ace-builder/Robbi/software/apps/fridge-rescue/README.md

# Fridge Rescue

Track food stock and dates, suggest offline recipes and maintain an app-owned shopping list.

See [Life tools documentation](../../docs/apps/LIFE_TOOLS_APPS.md) for behavior, limits, permissions and examples.

The implementation is included in this project and uses the declared Robbi SDK. It makes no network requests.
