ace-builder/Robbi/software/apps/home-care/README.md

# Home Care Companion

Recurring household chores with due dates based on actual completion and optional one-shot timers.

See [Life tools documentation](../../docs/apps/LIFE_TOOLS_APPS.md) for behavior, limits, permissions and examples.

The implementation is included in this project and uses the declared Robbi SDK. It makes no network requests.
