ace-builder/Robbi/build/hardware/prints/DESIGN-2026-10-13.md

# Printed design: 13 October 2026

[Print files](README.md) · [Assembly steps](../../05-assembly.md) · [Parts](../../01-parts.md)

> [!WARNING]
> **This printed design iteration has not yet been physically validated.** The CAD release records nominal fit, service-path and reference slicing checks. Those checks do not prove real printed fit, strength, reliable button actuation, charging access or sensor performance. Complete a dry assembly with actual components before committing adhesive or applying power.

The published assembly STL contains the revised chassis and fixed head; the earlier written guide and build footage described the prototype's assembly. The current guide now follows the October design. Individual October STLs and reference 3MF projects are available alongside the original assembly reference. Use the complete matching set.

## Differences from the filmed prototype

| Area | October design and required change |
| :--- | :--- |
| Head | Fixed carrier with an enclosed hollow neck and separate rear service cover. No adjustable or motorised head joint. Use two M3 × 12 screws **upward from inside the chassis**, with nuts in the head ears. The older central retaining bracket is not the new cover. |
| Head cover | Offer it **1.5 mm low**, move forward to the rim, then slide **up 1.5 mm** to engage two hooks. Secure with one M2 × 6 screw. The hooks slide; do not bend them as snap clips. |
| Electronics mounting | Four M2 × 20 screws from outside the rear cover pass through the Pi, **four 11 mm spacers**, custom PCB, compact washers and nuts. Confirm the actual header mating height; do not pull the boards together with screws. |
| Stack insertion | Keep the head and both side panels off. Enter from the **GPIO side**, hold the stack **4 mm outward**, connect BAT, then seat it **4 mm inward**. Do not stretch the body by centimetres as in the older footage. |
| Battery | Seat for a **76 × 21 × 18.4 mm** holder; measured loaded height **20.4 mm**. Glue the empty holder using accessible fillets after fit checks. Its central Ø3.6 hole is unused; no safe screw-head clearance has been established. |
| Motor retention | New front-fastened clip and side-loaded M2 nut replace the old rear fastener, which conflicts with the holder. Fit the motors and clip **before** the holder, head, camera or electronics. |
| Power button | Separate PETG rocker, keeper/return spring and split pivot pin operate SW1 from outside. Test no preload, a click before the stop and complete release with the actual stack installed. |
| Charging access | Rear opening is **14 × 8 mm**; the modelled connector mouth is **12.63 mm behind it**. The cable overmold must enter far enough for full seating. This enclosure change does not alter the PCB's brownout on charger connection. |
| Camera | The four seating planes move **1 mm forward**; the screw bores become **14 mm deep**. Check actual screws clamp before bottoming. Fit the camera after the head screws to preserve tool access. |
| ToF | Locating outline and two glue lands. Dry-fit the sensor, cover and solder tails; test readings through the window before two small glue fillets at the outer ears. No ToF screws or clamp. |
| Wiring | Battery position changes the local LCD and left-encoder routes. Use individual display housings through the neck and prewire constrained PCB plugs before inserting the stack. Keep H2 and SERVO1 empty in the standard build. |
| Servicing | Remove both side panels and the fixed head before taking out the electronics stack or replacing the cell. Unplug display leads at the display, feed individual housings down the neck, move the stack 4 mm out, disconnect BAT, then withdraw through the GPIO side. |

## Fit limits to check on real parts

- **Pi / PCB stack:** the 11 mm gap is between the Pi's top surface and the custom PCB's underside. The Pi's 1.6 mm model thickness is an assumption. Verify actual PCB thickness, soldered header height, mating depth and clearance before tightening.
- **Button:** nominal SW1 rest gap is 0.20 mm; assembly target 0.15–0.25 mm. Check no preload in every orientation and through available bearing play. A coupon cannot validate the board datum or switch position.
- **Head:** front outside face to inside rear wall is 29.0 mm, overall depth 30.6 mm. The model assumes a 1.2 mm display PCB. Four approximately 24.65 mm cover posts must not load the glass, cable or components. The cover must meet its rim without screw force.
- **Display leads:** the neck opening is Ø12 mm. Feed eight individual connector housings one at a time. Local head references allow housings up to 14.25 mm long, wire up to Ø1.5 mm and R3 centreline bends; actual bought leads still need checking.
- **Battery and harness:** the local LCD route has only about 0.295 mm nominal clearance to the loaded-holder envelope, falling to about 0.161 mm in the tested PCB-offset cases. Its modelled R2 bend and the left-encoder R2.5 bend are clearance references, not permission to kink stiff wire. Full harness lengths are not specified by CAD.
- **Thin plastic:** the minimum battery-seat floor is about 1.004 mm, rear motor wall about 1.018 mm, and panel pocket skins 0.8 mm. Check real print integrity and motor retention. Reference slicing is not a strength test.
- **ToF:** a 1 mm solder-tail reference clears in CAD, but actual tails/cover and optical field of view were not measured. Verify fit and ranging in the real shell.
- **Cell service:** the checked external envelope is up to 70 mm long × Ø18.6 mm. Actual spring-contact travel is not modelled. With the stack removed, the cell lifts about 20 mm before withdrawing through the battery side.

## What is established

The October release records 15 closed STL meshes, 11 unsliced reference 3MF projects and nominal assembly/service checks. The individual meshes and projects are published unchanged. [Validation status](2026-10-13/validation.json) and the [hardware manifest](../release-files.json) identify the files.

Physical print fit, material behaviour, repeated button use, motor retention, loaded wire clearance, optical performance and a complete new-enclosure build remain unverified. This mechanical revision does not change the PCB pinout or establish new electrical, charging or motor-load limits. Use the [wiring reference](../../WIRING.md), [bench tests](../../04-bench-tests.md) and [release checklist](../../RELEASE-CHECKLIST.md).
