ace-builder/Robbi/build/hardware/pcb/connector-pinout.csv

connector | pin | signal | connect_to | continuity_to | x_mm | y_mm
LCD | 1 | 3V3 | VCC | U6.1 | 18.11 | -2.2
LCD | 2 | GND | GND | U6.6 | 20.65 | -2.2
LCD | 3 | SPI clock | SCL | U6.23 | 23.19 | -2.2
LCD | 4 | SPI MOSI | SDA | U6.19 | 25.73 | -2.2
LCD | 5 | Reset | RES | U6.18 | 28.27 | -2.2
LCD | 6 | Data/command | DC | U6.22 | 30.81 | -2.2
LCD | 7 | Chip select | CS | U6.24 | 33.35 | -2.2
LCD | 8 | 3V3 backlight | BLK | U6.17 | 35.89 | -2.2
H1 | 1 | 3V3 | VCC | U6.1 | 53.65 | -2.2
H1 | 2 | GND | GND | U6.6 | 56.19 | -2.2
H1 | 3 | I2C SDA | SDA | U6.3 | 58.73 | -2.2
H1 | 4 | I2C SCL | SCL | U6.5 | 61.27 | -2.2
H1 | 5 | Unrouted | Leave unconnected | No route | 63.81 | -2.2
H1 | 6 | XSHUT / BCM13 | XSHUT | U6.33 | 66.35 | -2.2
H2 | 1 | 3V3 | Unused in this build | U6.1 | 2.2 | -3.15
H2 | 2 | GND | Unused in this build | U6.6 | 2.2 | -5.69
H2 | 3 | I2C SDA | Unused in this build | U6.3 | 2.2 | -8.23
H2 | 4 | I2C SCL | Unused in this build | U6.5 | 2.2 | -10.77
H2 | 5 | Unrouted | Leave unconnected | No route | 2.2 | -13.31
H2 | 6 | XSHUT / BCM12 | Unused in this build | U6.32 | 2.2 | -15.85
MENCODER_L | 1 | Motor terminal 1 | Motor lead 1 | MD1.2 | 17.15 | -42.0
MENCODER_L | 2 | 3V3 encoder supply | Encoder VCC | U6.1 | 19.69 | -42.0
MENCODER_L | 3 | Encoder A / BCM27 | Encoder A | U6.13 | 22.23 | -42.0
MENCODER_L | 4 | Encoder B / BCM5 | Encoder B | U6.29 | 24.77 | -42.0
MENCODER_L | 5 | GND | Encoder GND | U6.6 | 27.31 | -42.0
MENCODER_L | 6 | Motor terminal 2 | Motor lead 2 | MD1.4 | 29.85 | -42.0
MENCODER_R | 1 | Motor terminal 1 | Motor lead 1 | MD1.7 | 50.15 | -42.0
MENCODER_R | 2 | 3V3 encoder supply | Encoder VCC | U6.1 | 52.69 | -42.0
MENCODER_R | 3 | Encoder A / BCM6 | Encoder A | U6.31 | 55.23 | -42.0
MENCODER_R | 4 | Encoder B / BCM16 | Encoder B | U6.36 | 57.77 | -42.0
MENCODER_R | 5 | GND | Encoder GND | U6.6 | 60.31 | -42.0
MENCODER_R | 6 | Motor terminal 2 | Motor lead 2 | MD1.5 | 62.85 | -42.0
H3 | 1 | Speaker + | Speaker + | AMP.9 | 52.73 | -26.5
H3 | 2 | Speaker - | Speaker - | AMP.10 | 55.27 | -26.5
BAT | 1 | Battery + / PACK+ | Holder positive | TP_PACK+.1 | 11.98018 | -41.0
BAT | 2 | Battery - / PACK- | Holder negative | TP_PACK-.1 | 8.01982 | -41.0
