ace-builder/Robbi/software/apps/bookmarks/images/screen.png

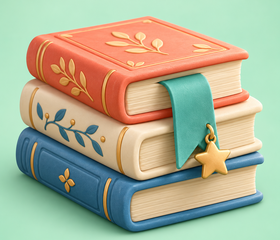
software/apps/bookmarks/images/screen.png
