ace-builder/Robbi/software/apps/calculator/images/screen.png

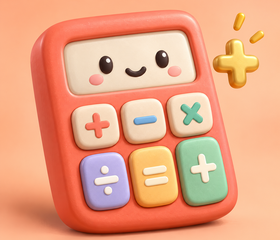
software/apps/calculator/images/screen.png
