ace-builder/Robbi/software/apps/checklists/images/screen.png

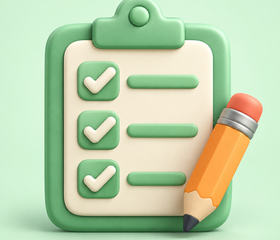
software/apps/checklists/images/screen.png
