ace-builder/Robbi/software/apps/date-calculator/images/screen.png

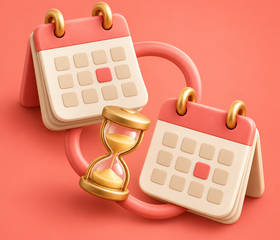
software/apps/date-calculator/images/screen.png
