ace-builder/Robbi/software/apps/decision-helper/images/screen.png

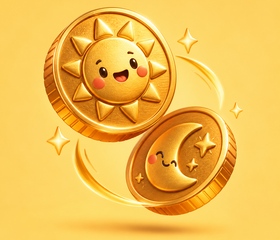
software/apps/decision-helper/images/screen.png
