ace-builder/Robbi/software/apps/decision-notebook/images/screen.png

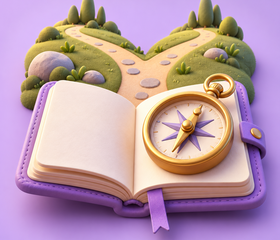
software/apps/decision-notebook/images/screen.png
