ace-builder/Robbi/software/apps/expense-tracker/images/screen.png

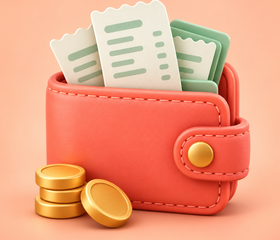
software/apps/expense-tracker/images/screen.png
