ace-builder/Robbi/software/apps/expressions/images/screen.png

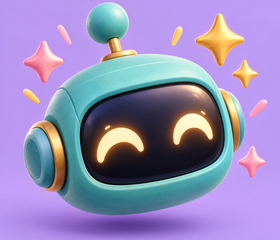
software/apps/expressions/images/screen.png
