ace-builder/Robbi/software/apps/fridge-rescue/images/screen.png

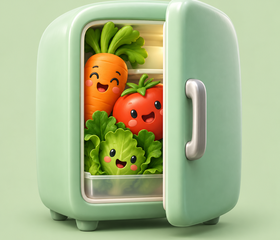
software/apps/fridge-rescue/images/screen.png
