ace-builder/Robbi/software/apps/gmail/images/screen.png

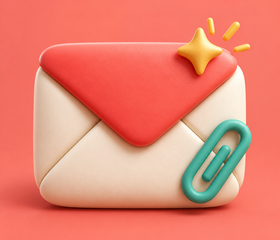
software/apps/gmail/images/screen.png
