ace-builder/Robbi/software/apps/google-calendar/images/screen.png

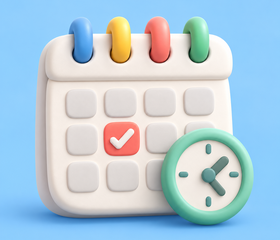
software/apps/google-calendar/images/screen.png
