ace-builder/Robbi/software/apps/google-maps/images/screen.png

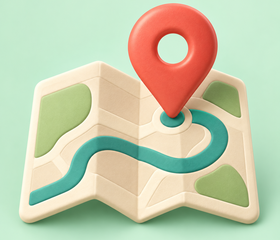
software/apps/google-maps/images/screen.png
