ace-builder/Robbi/software/apps/habit-tracker/images/screen.png

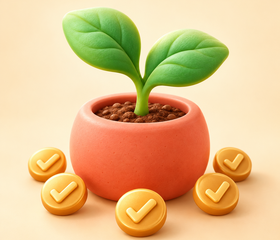
software/apps/habit-tracker/images/screen.png
