ace-builder/Robbi/software/apps/higher-lower/images/screen.png

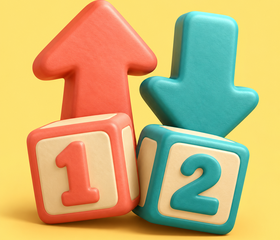
software/apps/higher-lower/images/screen.png
