ace-builder/Robbi/software/apps/home-care/images/screen.png

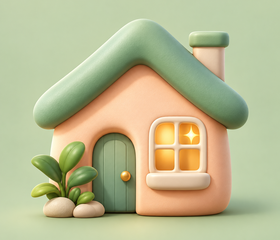
software/apps/home-care/images/screen.png
