ace-builder/Robbi/software/apps/image-studio/images/screen.png

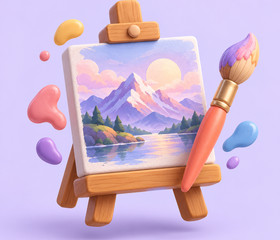
software/apps/image-studio/images/screen.png
