ace-builder/Robbi/software/apps/kitchen-timers/images/screen.png

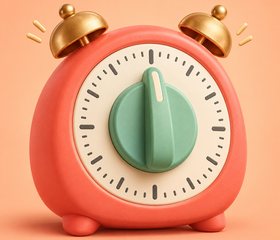
software/apps/kitchen-timers/images/screen.png
