ace-builder/Robbi/software/apps/meeting-prep/images/screen.png

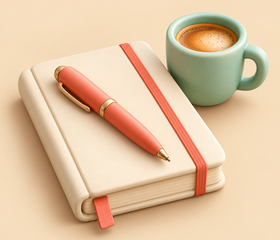
software/apps/meeting-prep/images/screen.png
