ace-builder/Robbi/software/apps/memory-colours/images/screen.png

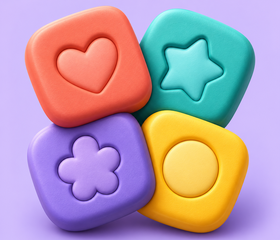
software/apps/memory-colours/images/screen.png
