ace-builder/Robbi/software/apps/packing-list/images/screen.png

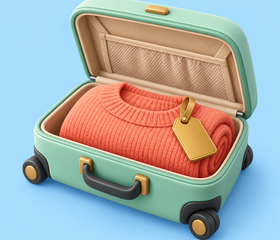
software/apps/packing-list/images/screen.png
