ace-builder/Robbi/software/apps/password-generator/images/screen.png

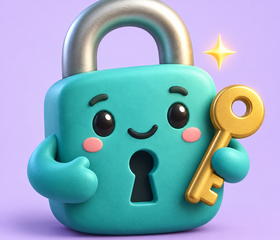
software/apps/password-generator/images/screen.png
