ace-builder/Robbi/software/apps/percentage-helper/images/screen.png

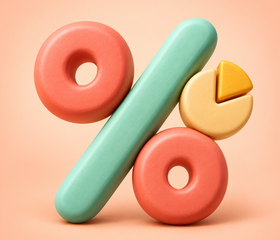
software/apps/percentage-helper/images/screen.png
