ace-builder/Robbi/software/apps/quick-notes/images/screen.png

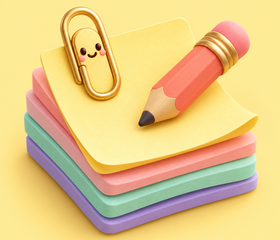
software/apps/quick-notes/images/screen.png
