ace-builder/Robbi/software/apps/random-number/images/screen.png

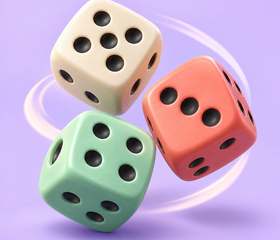
software/apps/random-number/images/screen.png
