ace-builder/Robbi/software/apps/ready-to-leave/images/screen.png

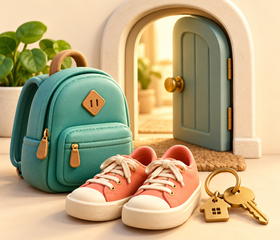
software/apps/ready-to-leave/images/screen.png
