ace-builder/Robbi/software/apps/recipe-scaler/images/screen.png

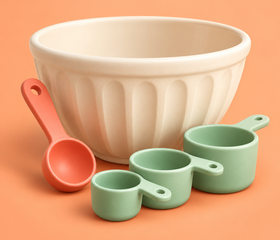
software/apps/recipe-scaler/images/screen.png
