ace-builder/Robbi/software/apps/rhythm-relay/images/screen.png

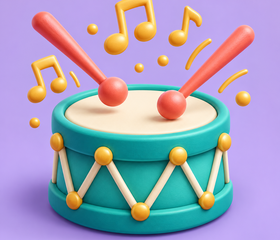
software/apps/rhythm-relay/images/screen.png
