ace-builder/Robbi/software/apps/robot-charades/images/screen.png

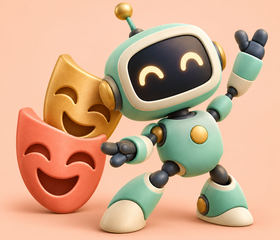
software/apps/robot-charades/images/screen.png
