ace-builder/Robbi/software/apps/robot-status/images/screen.png

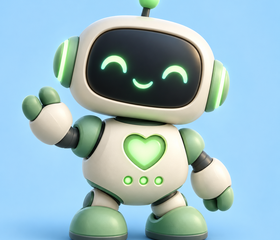
software/apps/robot-status/images/screen.png
