ace-builder/Robbi/software/apps/sensor-check/images/screen.png

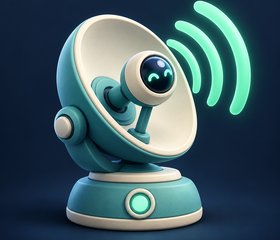
software/apps/sensor-check/images/screen.png
