ace-builder/Robbi/software/apps/teach-me/images/screen.png

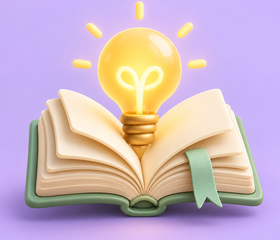
software/apps/teach-me/images/screen.png
