ace-builder/Robbi/software/apps/text-toolbox/images/screen.png

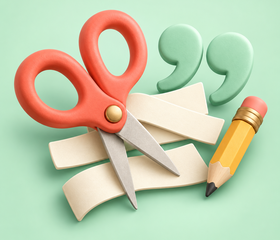
software/apps/text-toolbox/images/screen.png
