ace-builder/Robbi/software/apps/tic-tac-toe/images/screen.png

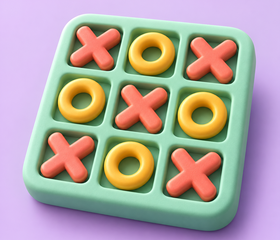
software/apps/tic-tac-toe/images/screen.png
