ace-builder/Robbi/software/apps/tiny-detective/images/screen.png

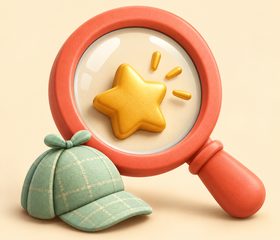
software/apps/tiny-detective/images/screen.png
