ace-builder/Robbi/software/apps/tip-splitter/images/screen.png

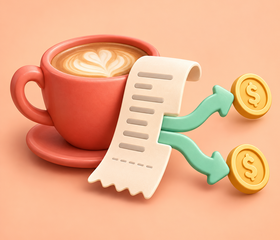
software/apps/tip-splitter/images/screen.png
