ace-builder/Robbi/software/apps/unit-converter/images/screen.png

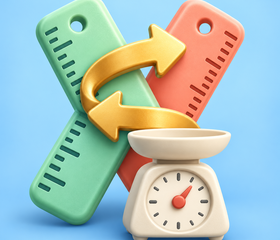
software/apps/unit-converter/images/screen.png
