ace-builder/Robbi/software/apps/weather/images/screen.png

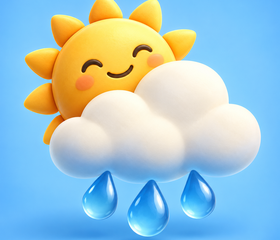
software/apps/weather/images/screen.png
