ace-builder/Robbi/software/apps/web-search/images/screen.png

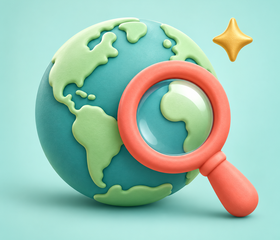
software/apps/web-search/images/screen.png
