ace-builder/Robbi/software/apps/where-did-i-put-it/images/screen.png

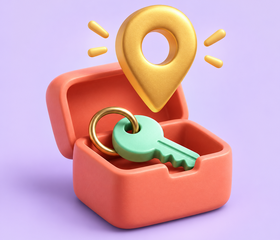
software/apps/where-did-i-put-it/images/screen.png
