ace-builder/Robbi/software/apps/world-clock/images/screen.png

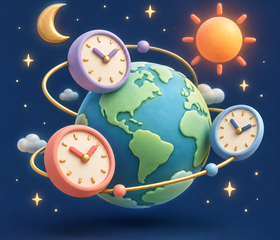
software/apps/world-clock/images/screen.png
