ace-builder/Robbi/software/assets/dynamics_sources/after-hours-v1/boundary-cactus.png

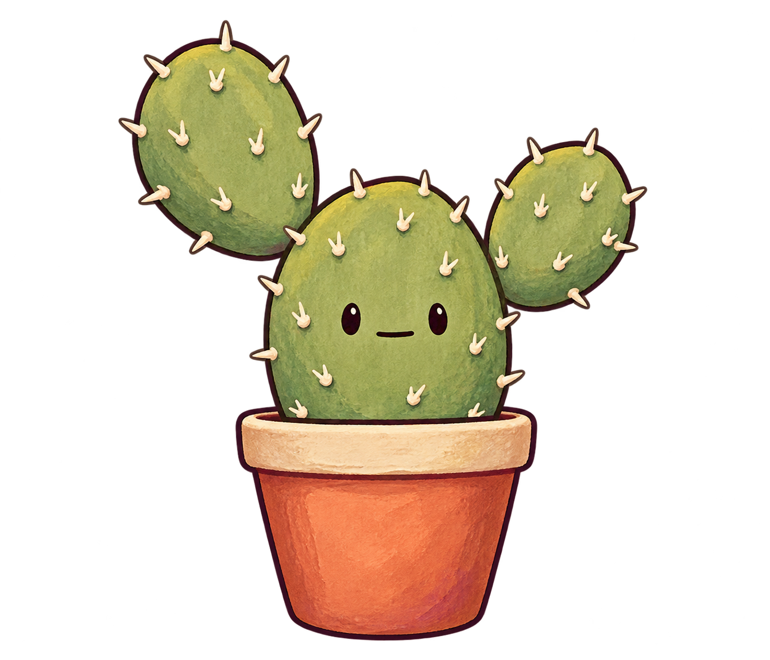
software/assets/dynamics_sources/after-hours-v1/boundary-cactus.png
