ace-builder/Robbi/software/assets/dynamics_sources/after-hours-v1/capybara-rest.png

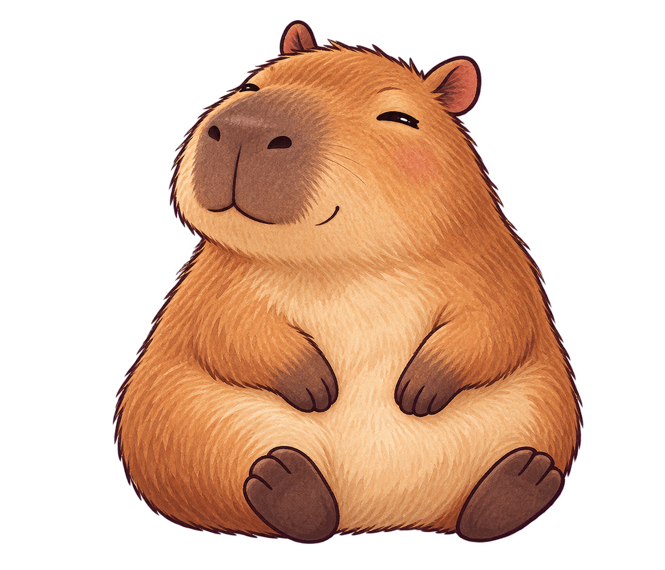
software/assets/dynamics_sources/after-hours-v1/capybara-rest.png
