ace-builder/Robbi/software/assets/dynamics_sources/after-hours-v1/judge-shrimp.png

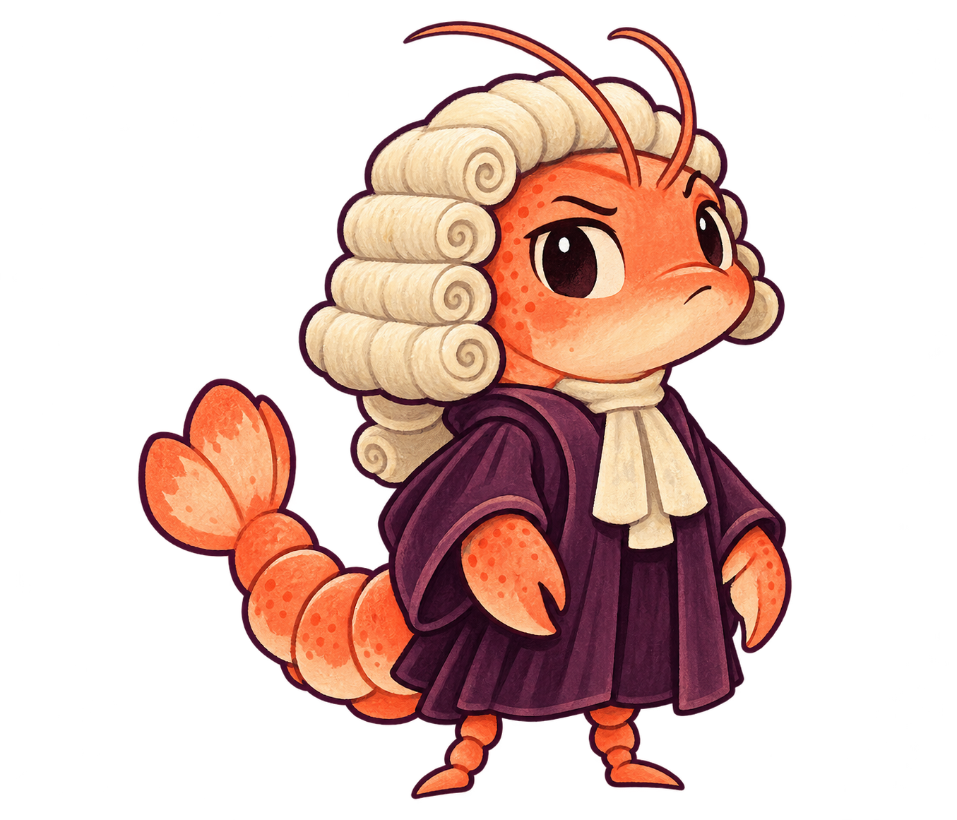
software/assets/dynamics_sources/after-hours-v1/judge-shrimp.png
