ace-builder/Robbi/software/assets/dynamics_sources/celebration-original.png

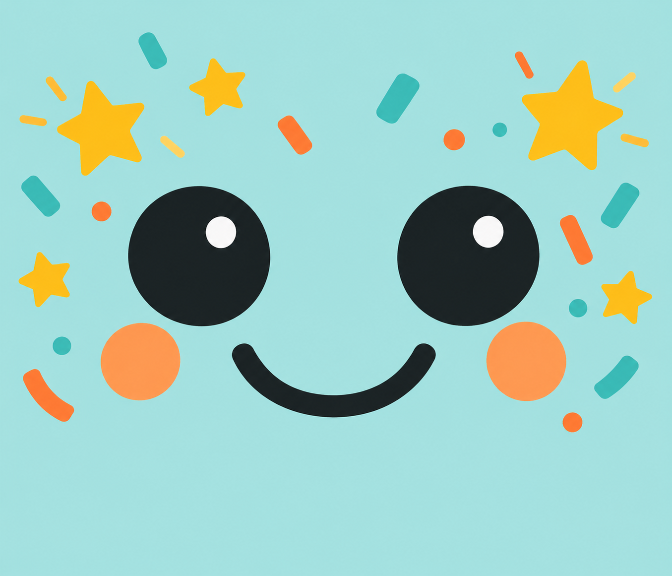
software/assets/dynamics_sources/celebration-original.png
