ace-builder/Robbi/software/assets/dynamics_sources/emotion-keyposes-v3-original.png

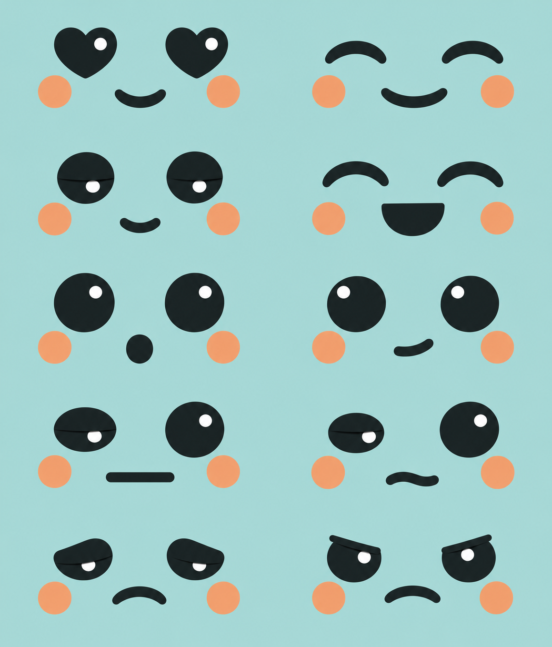
software/assets/dynamics_sources/emotion-keyposes-v3-original.png
