ace-builder/Robbi/software/assets/dynamics_sources/expression-atlas-v2-original.png

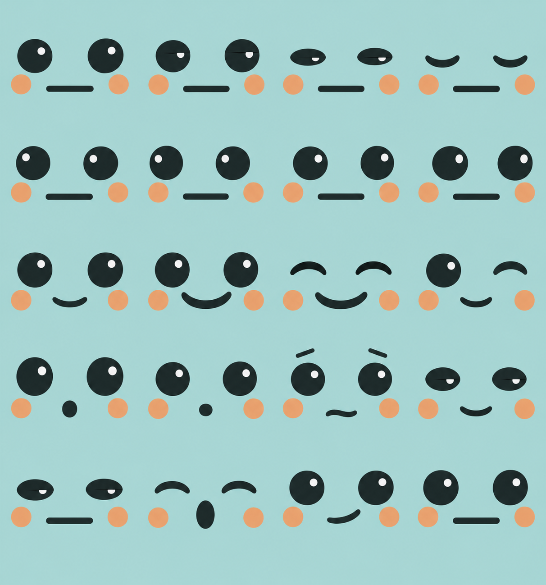
software/assets/dynamics_sources/expression-atlas-v2-original.png
