ace-builder/Robbi/software/assets/dynamics_sources/happy-sprites-original.png

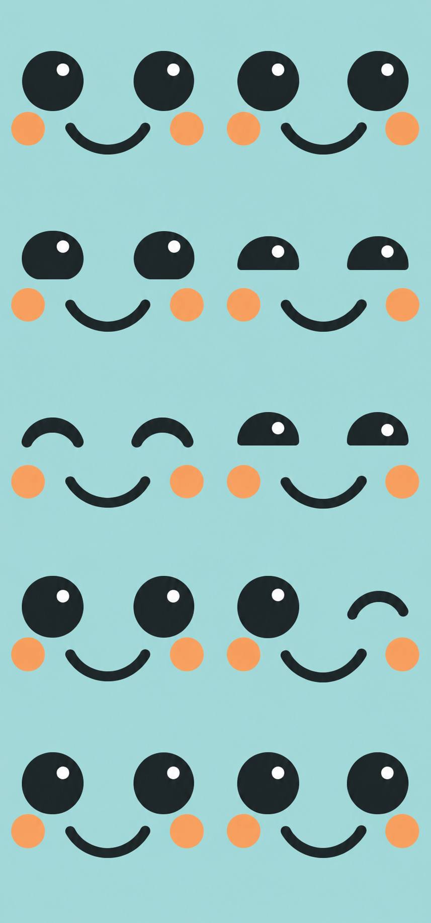
software/assets/dynamics_sources/happy-sprites-original.png
