ace-builder/Robbi/software/assets/dynamics_sources/little-kindness-v1/cookie.png

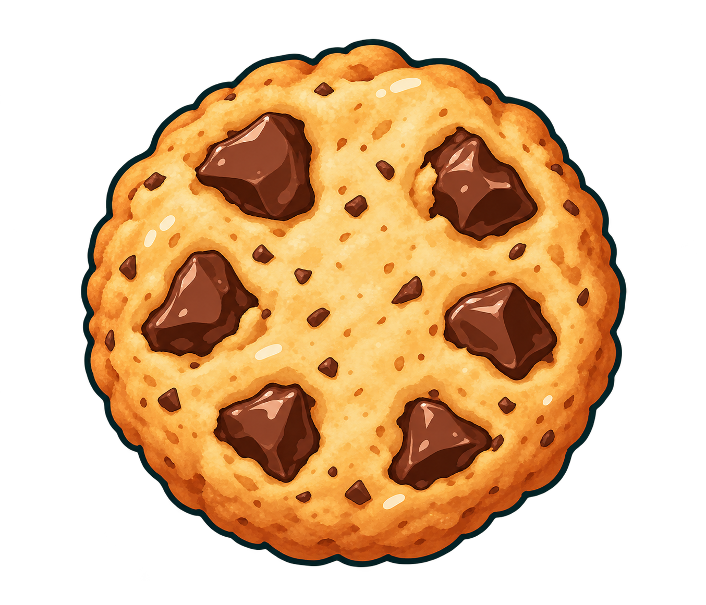
software/assets/dynamics_sources/little-kindness-v1/cookie.png
