ace-builder/Robbi/software/assets/dynamics_sources/little-kindness-v1/face-plate.png

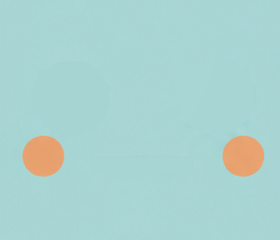
software/assets/dynamics_sources/little-kindness-v1/face-plate.png
