ace-builder/Robbi/software/assets/dynamics_sources/little-kindness-v1/flower.png

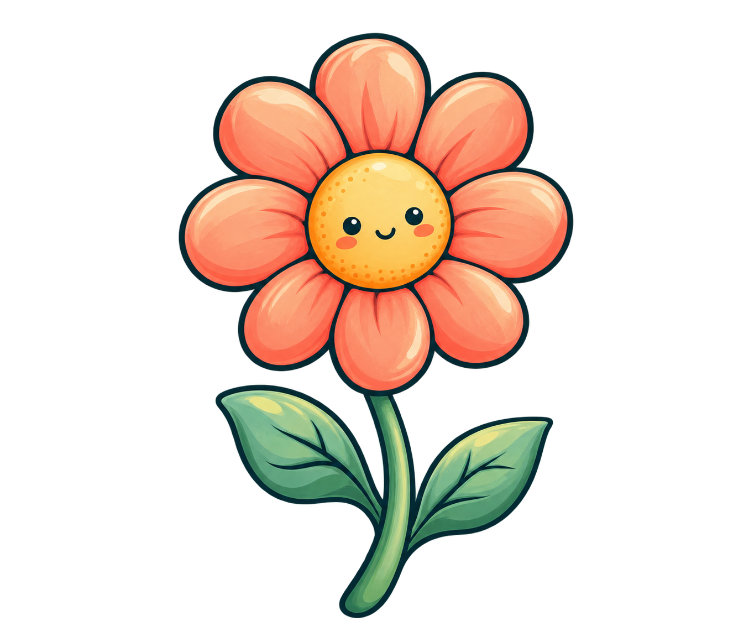
software/assets/dynamics_sources/little-kindness-v1/flower.png
