ace-builder/Robbi/software/assets/dynamics_sources/little-kindness-v1/umbrella.png

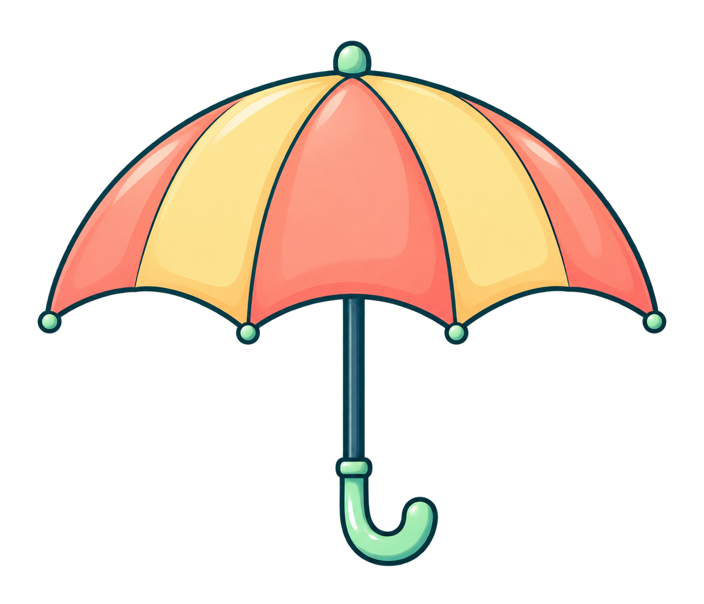
software/assets/dynamics_sources/little-kindness-v1/umbrella.png
