ace-builder/Robbi/software/assets/dynamics_sources/meme-encore-v1/cat.png

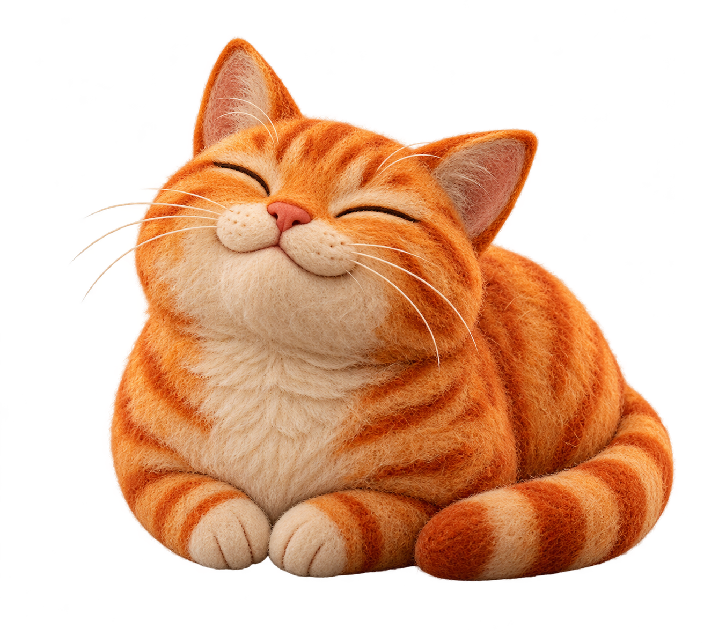
software/assets/dynamics_sources/meme-encore-v1/cat.png
