ace-builder/Robbi/software/assets/dynamics_sources/meme-encore-v1/raccoon.png

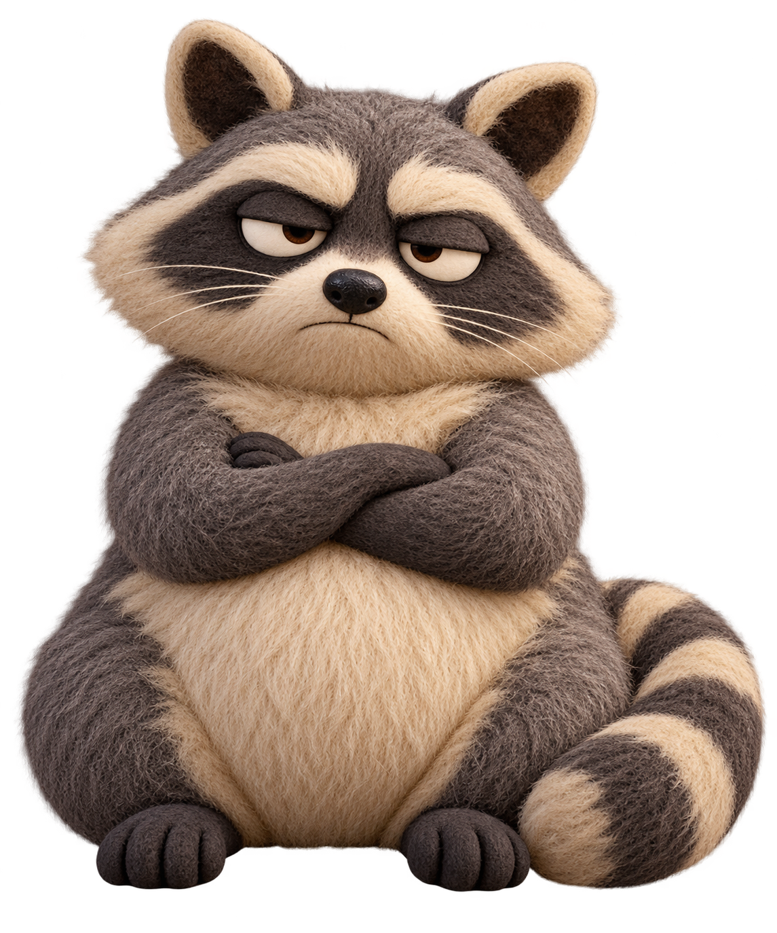
software/assets/dynamics_sources/meme-encore-v1/raccoon.png
