ace-builder/Robbi/software/assets/dynamics_sources/meme-encore-v1/toaster.png

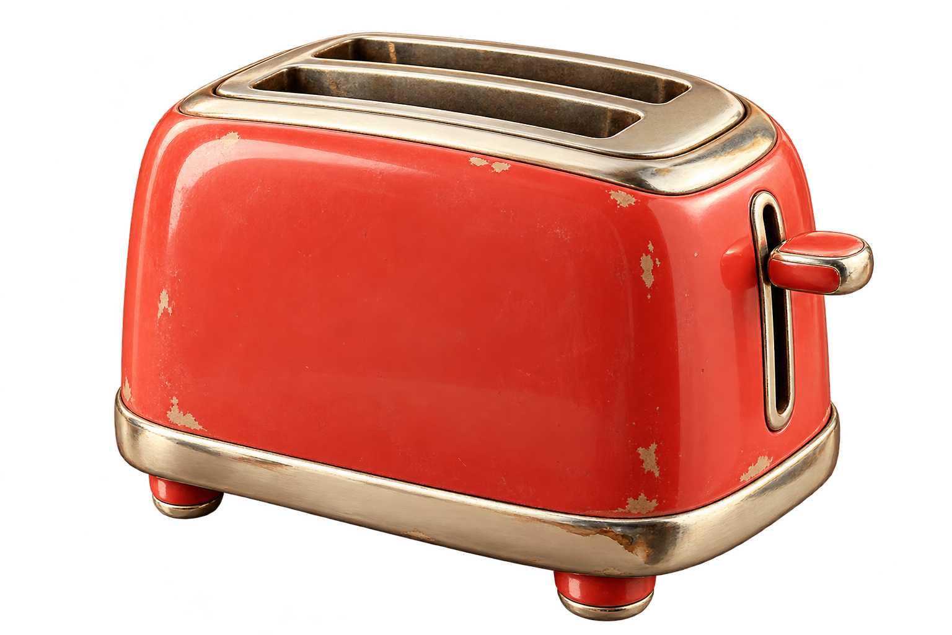
software/assets/dynamics_sources/meme-encore-v1/toaster.png
