ace-builder/Robbi/software/assets/dynamics_sources/meme-lab-v1/bin.png

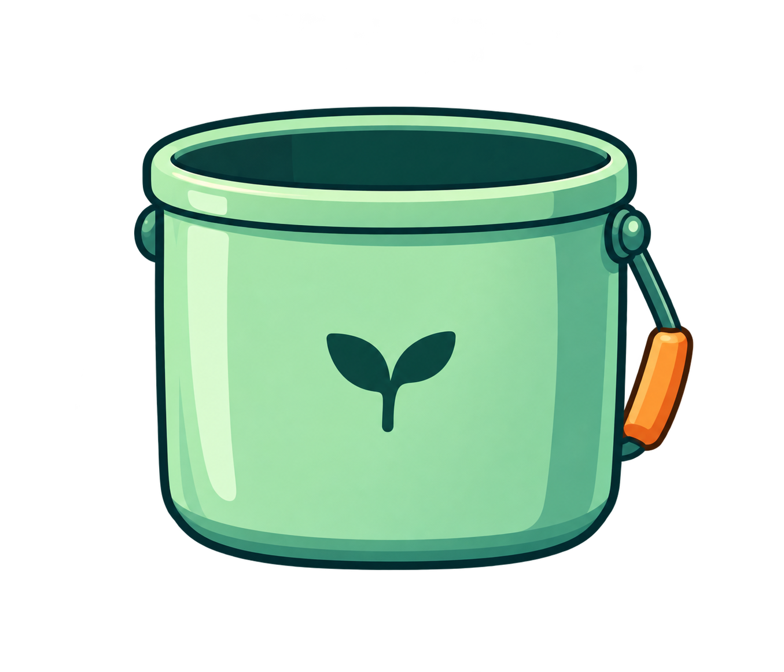
software/assets/dynamics_sources/meme-lab-v1/bin.png
