ace-builder/Robbi/software/assets/dynamics_sources/meme-lab-v1/brick.png

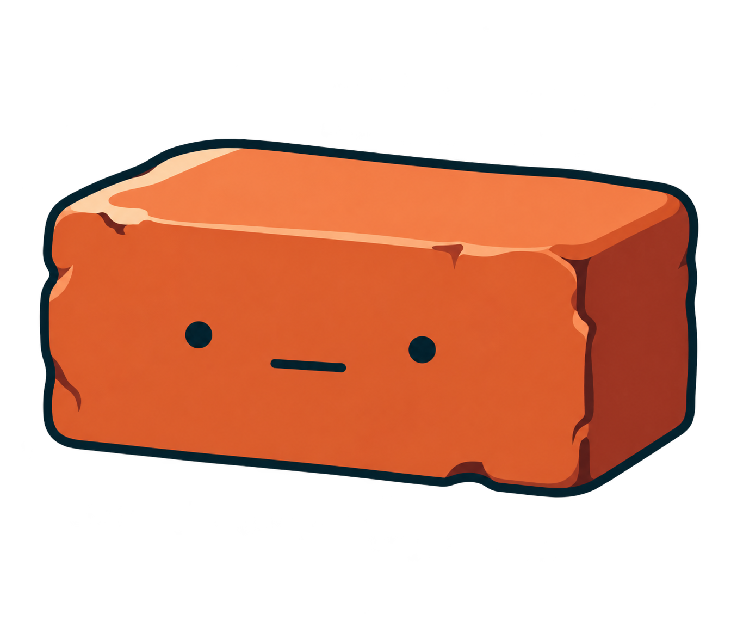
software/assets/dynamics_sources/meme-lab-v1/brick.png
