ace-builder/Robbi/software/assets/dynamics_sources/meme-lab-v1/can.png

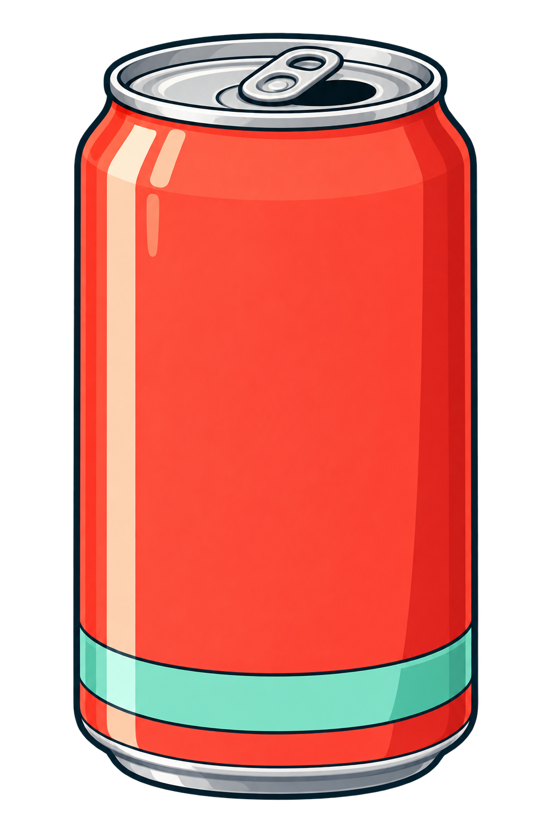
software/assets/dynamics_sources/meme-lab-v1/can.png
