ace-builder/Robbi/software/assets/dynamics_sources/meme-lab-v1/shredder.png

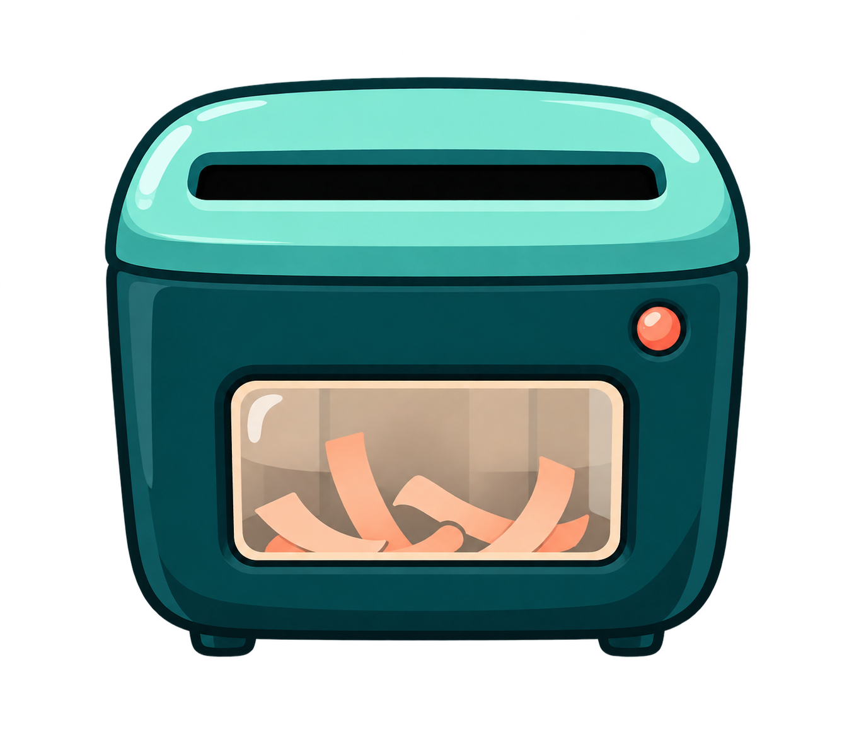
software/assets/dynamics_sources/meme-lab-v1/shredder.png
