ace-builder/Robbi/software/assets/dynamics_sources/meme-reflections-v1/cactus.png

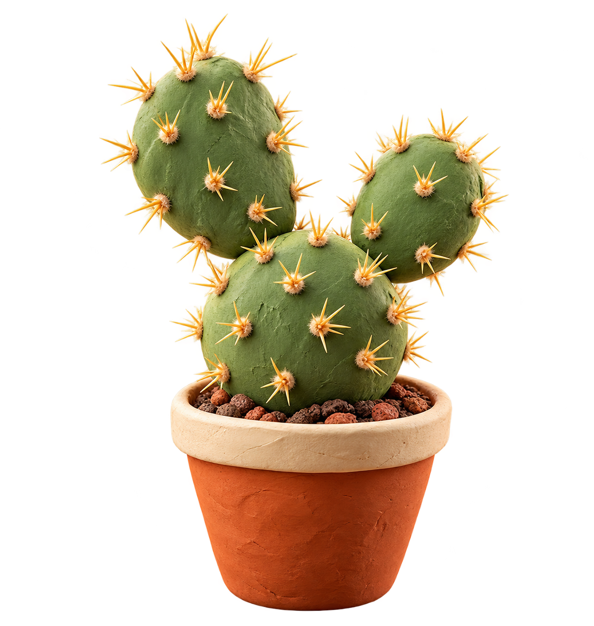
software/assets/dynamics_sources/meme-reflections-v1/cactus.png
