ace-builder/Robbi/software/assets/dynamics_sources/meme-reflections-v1/frog.png

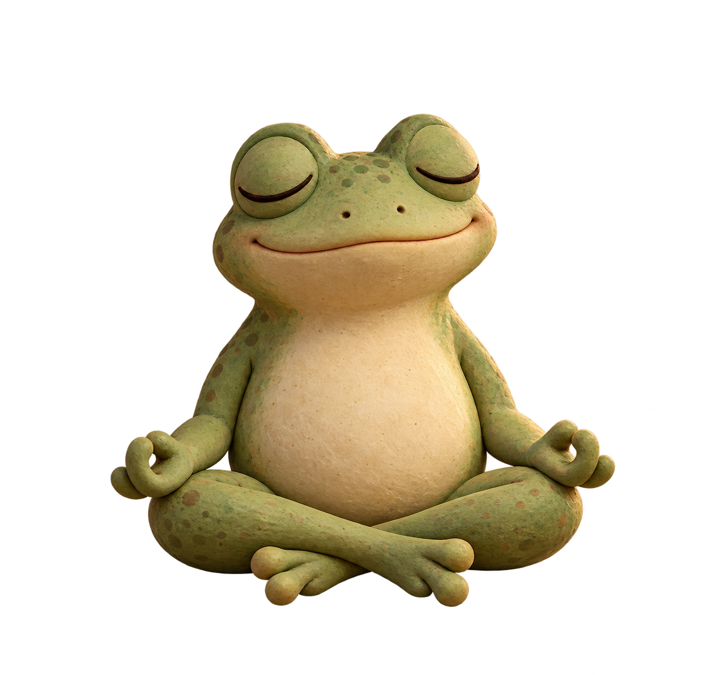
software/assets/dynamics_sources/meme-reflections-v1/frog.png
