ace-builder/Robbi/software/assets/dynamics_sources/meme-reflections-v1/octopus.png

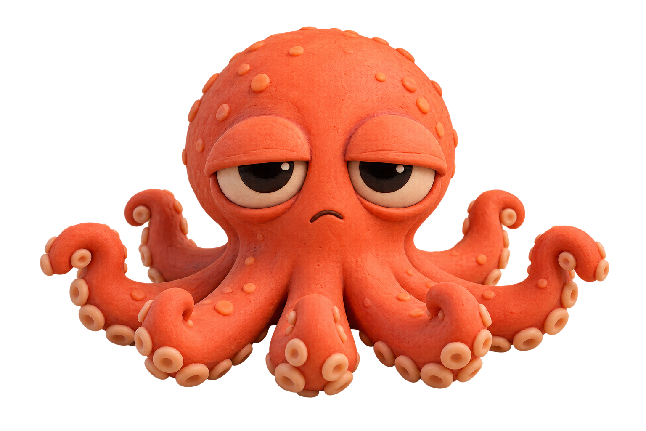
software/assets/dynamics_sources/meme-reflections-v1/octopus.png
