ace-builder/Robbi/software/assets/dynamics_sources/pocket-postcards-v1/peace-tea.png

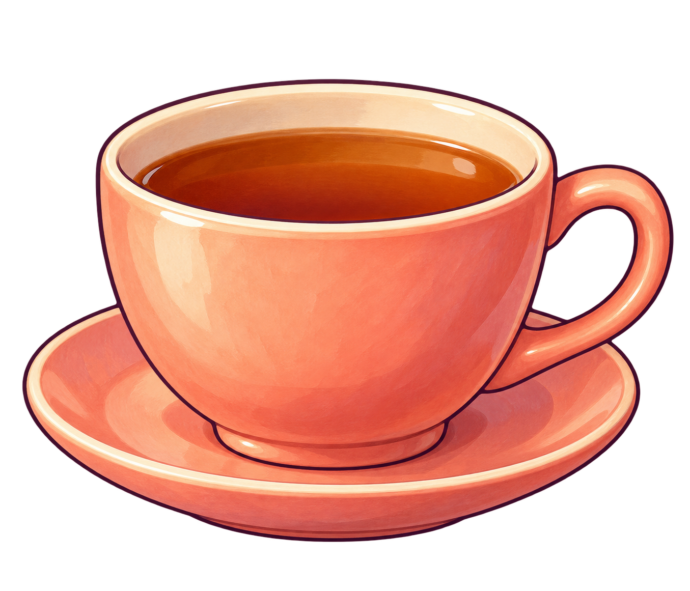
software/assets/dynamics_sources/pocket-postcards-v1/peace-tea.png
