ace-builder/Robbi/software/assets/dynamics_sources/pocket-postcards-v1/slow-snail-draft.png

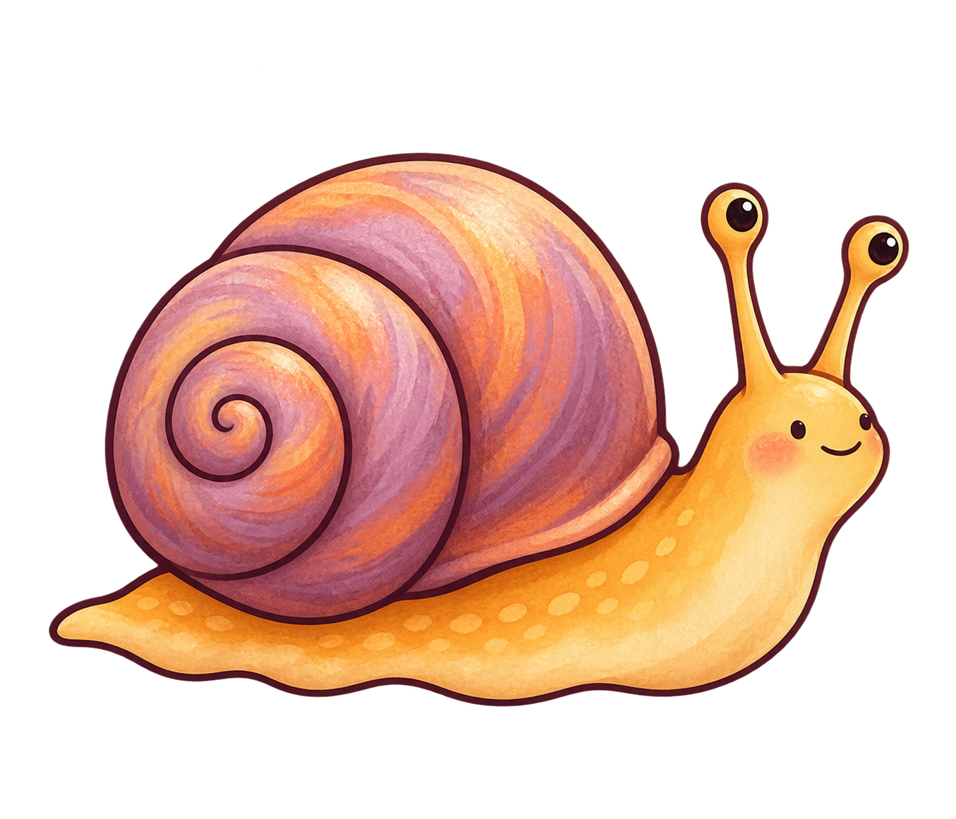
software/assets/dynamics_sources/pocket-postcards-v1/slow-snail-draft.png
