ace-builder/Robbi/software/assets/dynamics_sources/pocket-postcards-v1/soft-pillow.png

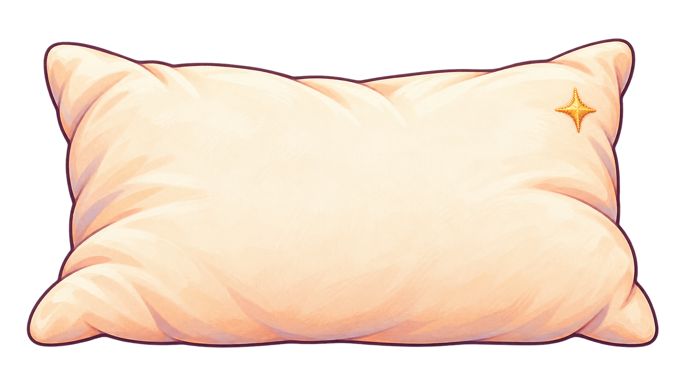
software/assets/dynamics_sources/pocket-postcards-v1/soft-pillow.png
