ace-builder/Robbi/software/assets/dynamics_sources/pocket-postcards-v1/sunshine-jar.png

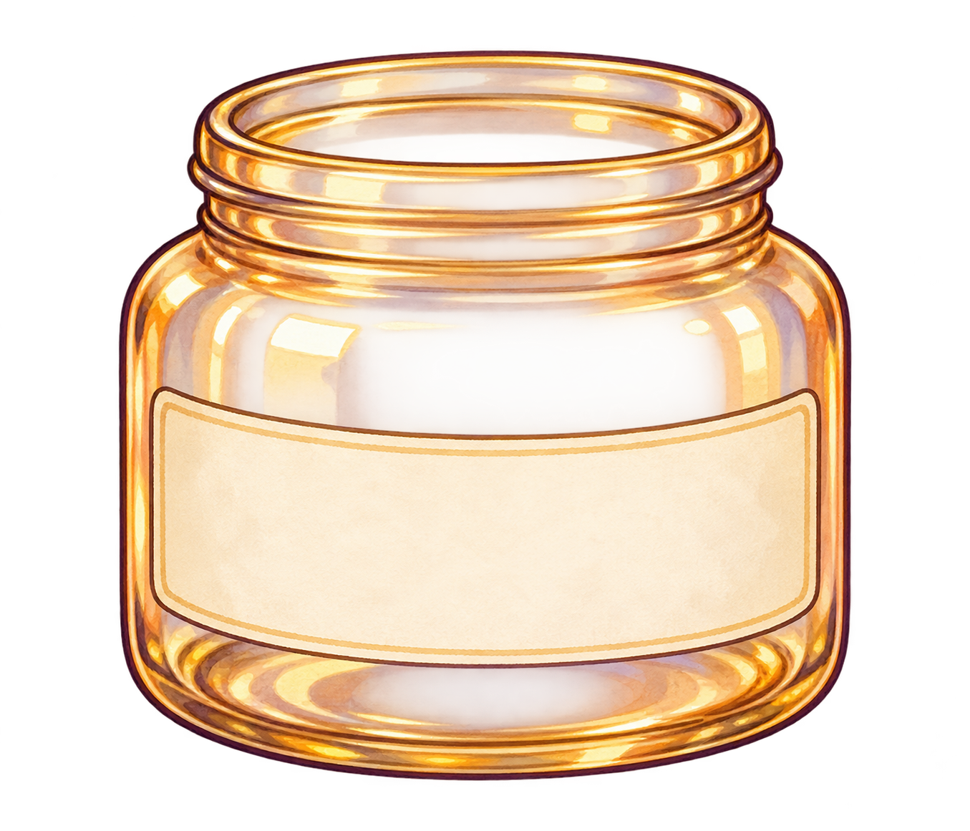
software/assets/dynamics_sources/pocket-postcards-v1/sunshine-jar.png
