ace-builder/Robbi/software/assets/dynamics_sources/screen-gags-v1/duck.png

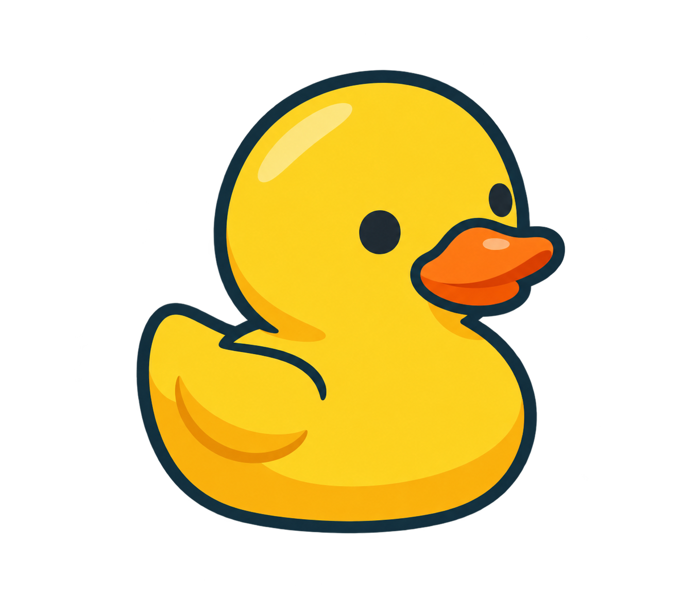
software/assets/dynamics_sources/screen-gags-v1/duck.png
