ace-builder/Robbi/software/assets/dynamics_sources/screen-gags-v1/hamster.png

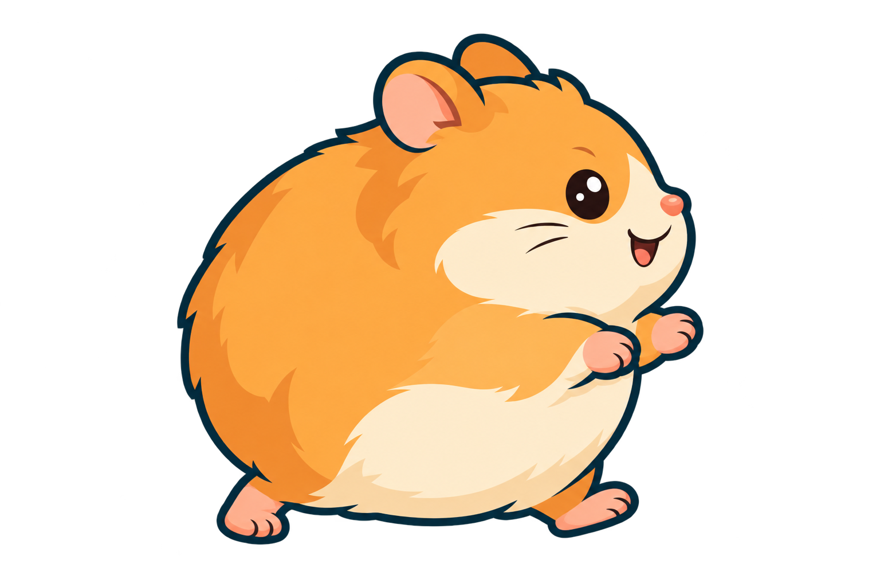
software/assets/dynamics_sources/screen-gags-v1/hamster.png
