ace-builder/Robbi/software/assets/dynamics_sources/screen-gags-v1/violin.png

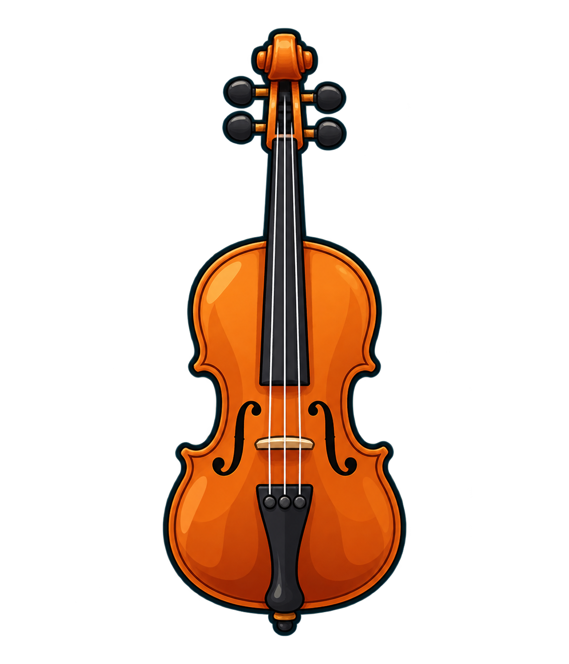
software/assets/dynamics_sources/screen-gags-v1/violin.png
