ace-builder/Robbi/software/assets/dynamics_sources/seasonal-encore-v1/festive/carnival-mask.png

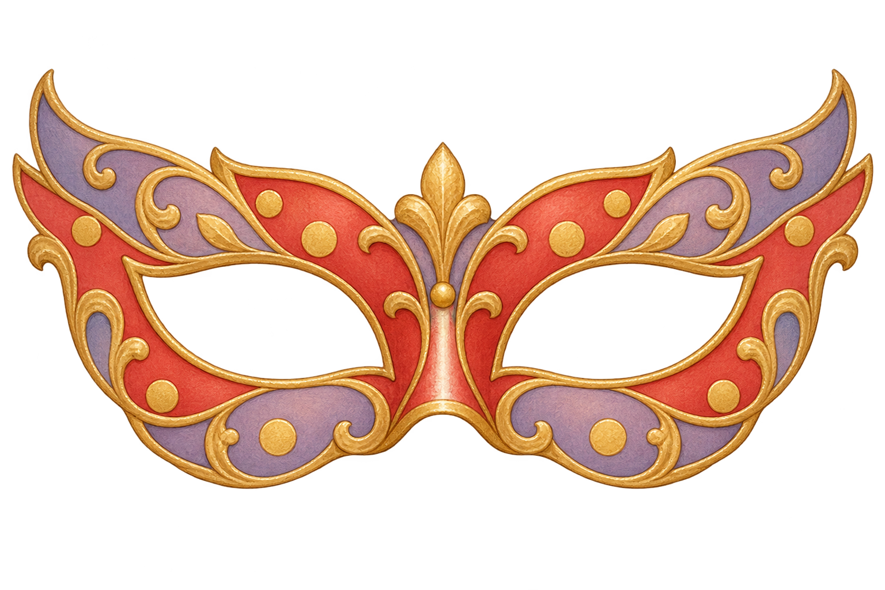
software/assets/dynamics_sources/seasonal-encore-v1/festive/carnival-mask.png
