ace-builder/Robbi/software/assets/dynamics_sources/seasonal-encore-v1/holidays/rubber-duck.png

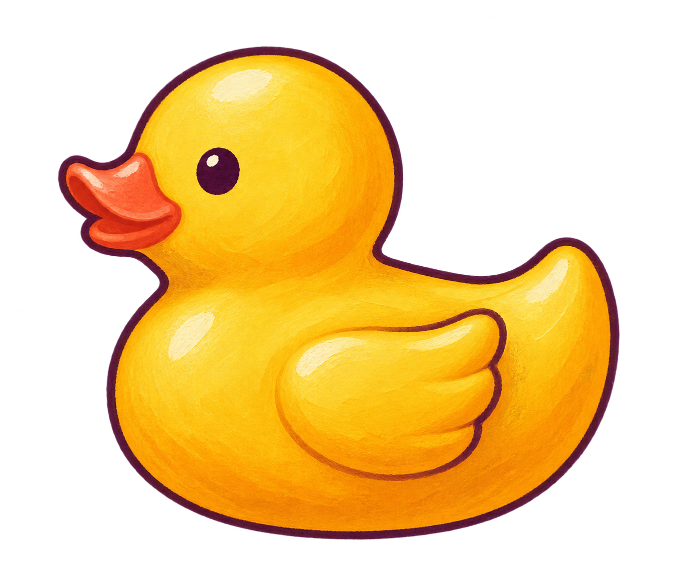
software/assets/dynamics_sources/seasonal-encore-v1/holidays/rubber-duck.png
