ace-builder/Robbi/software/assets/dynamics_sources/seasonal-encore-v1/holidays/warm-pretzel.png

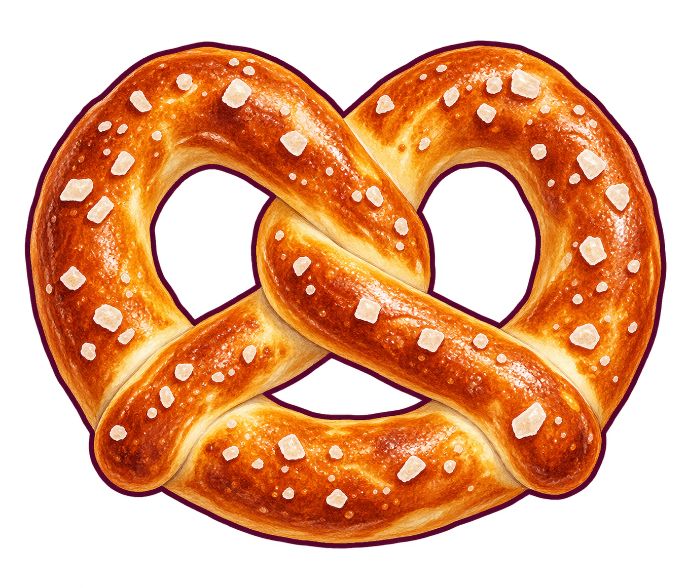
software/assets/dynamics_sources/seasonal-encore-v1/holidays/warm-pretzel.png
