ace-builder/Robbi/software/assets/dynamics_sources/seasonal-encore-v1/nature/strawberry.png

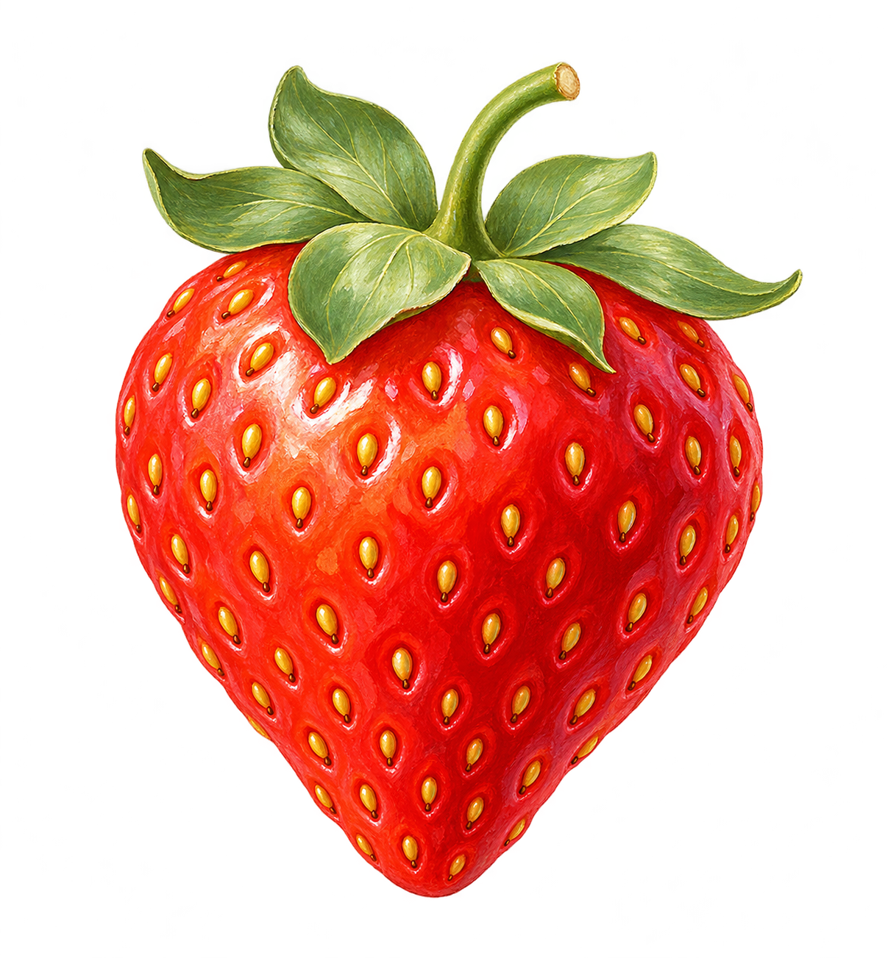
software/assets/dynamics_sources/seasonal-encore-v1/nature/strawberry.png
