ace-builder/Robbi/software/assets/dynamics_sources/seasonal-encore-v1/nature/woodland-mushroom.png

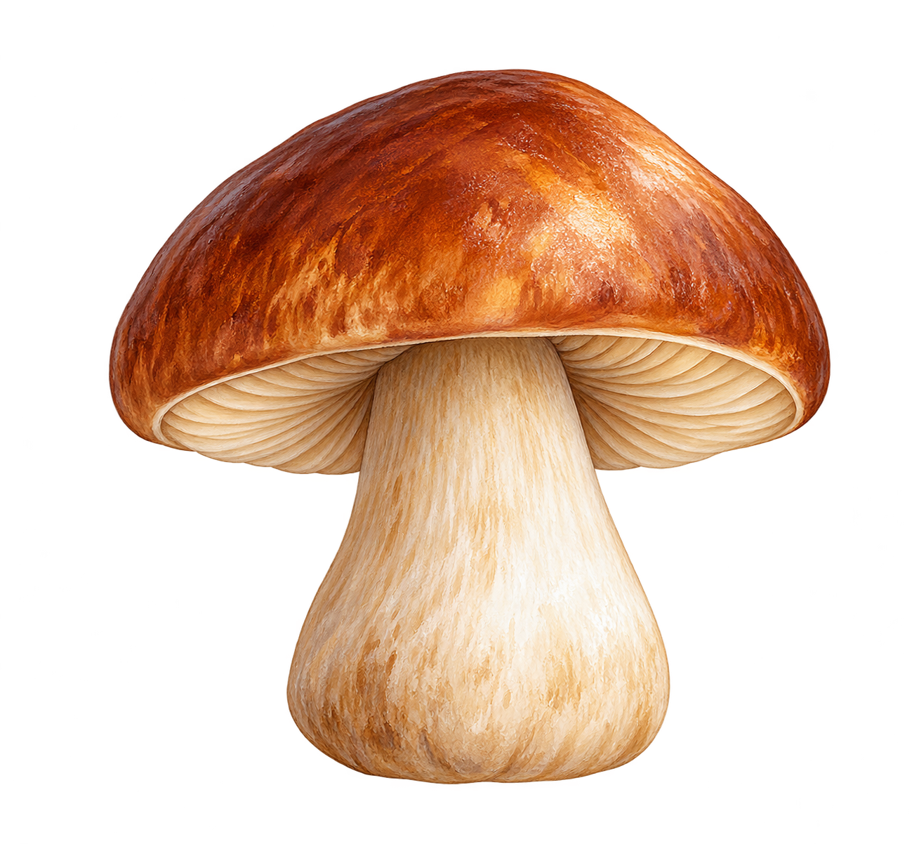
software/assets/dynamics_sources/seasonal-encore-v1/nature/woodland-mushroom.png
