ace-builder/Robbi/software/assets/dynamics_sources/seasonal-postcards-v1/advent-early/cocoa-mug.png

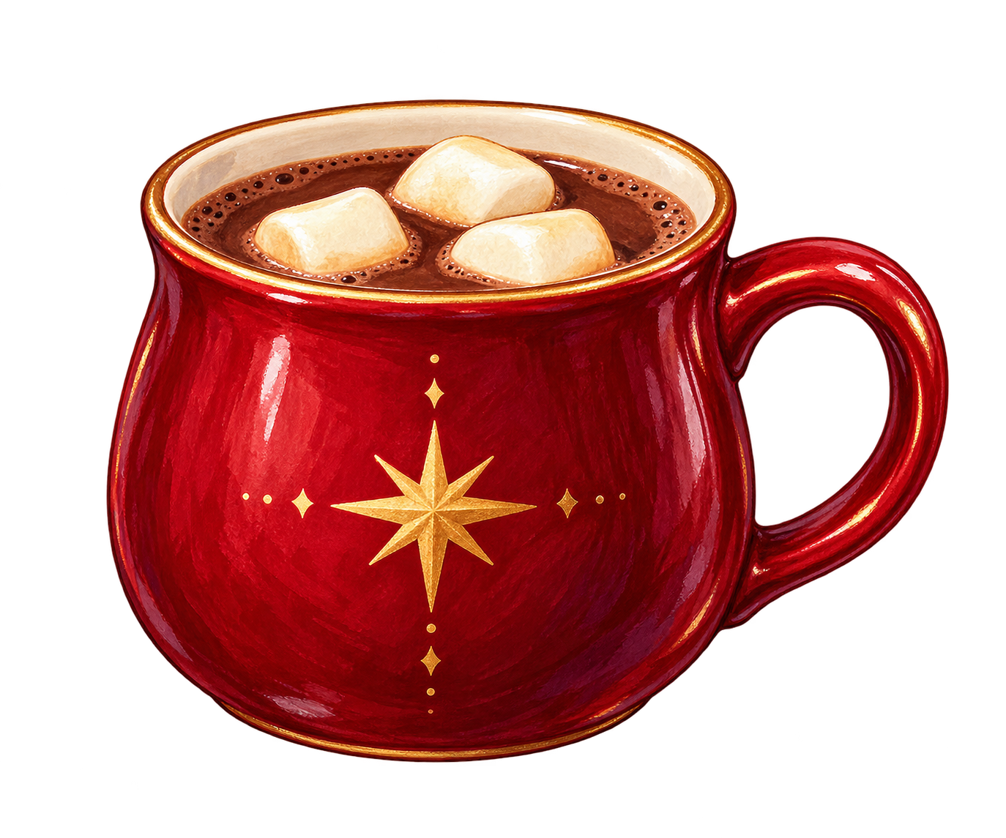
software/assets/dynamics_sources/seasonal-postcards-v1/advent-early/cocoa-mug.png
