ace-builder/Robbi/software/assets/dynamics_sources/seasonal-postcards-v1/advent-early/ginger-star.png

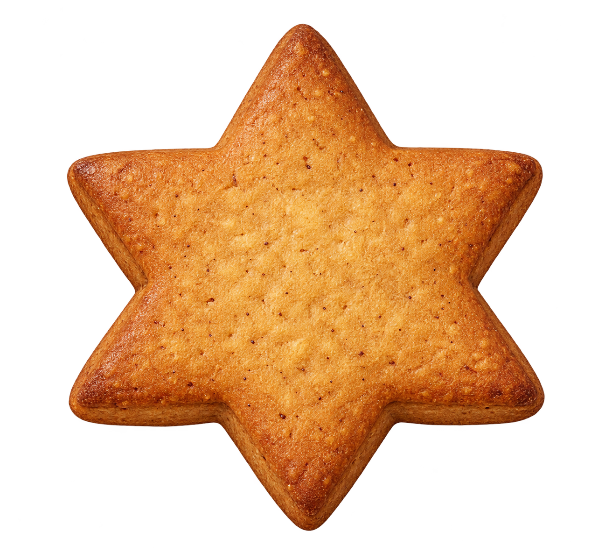
software/assets/dynamics_sources/seasonal-postcards-v1/advent-early/ginger-star.png
