ace-builder/Robbi/software/assets/dynamics_sources/seasonal-postcards-v1/advent-early/nicholas-boot.png

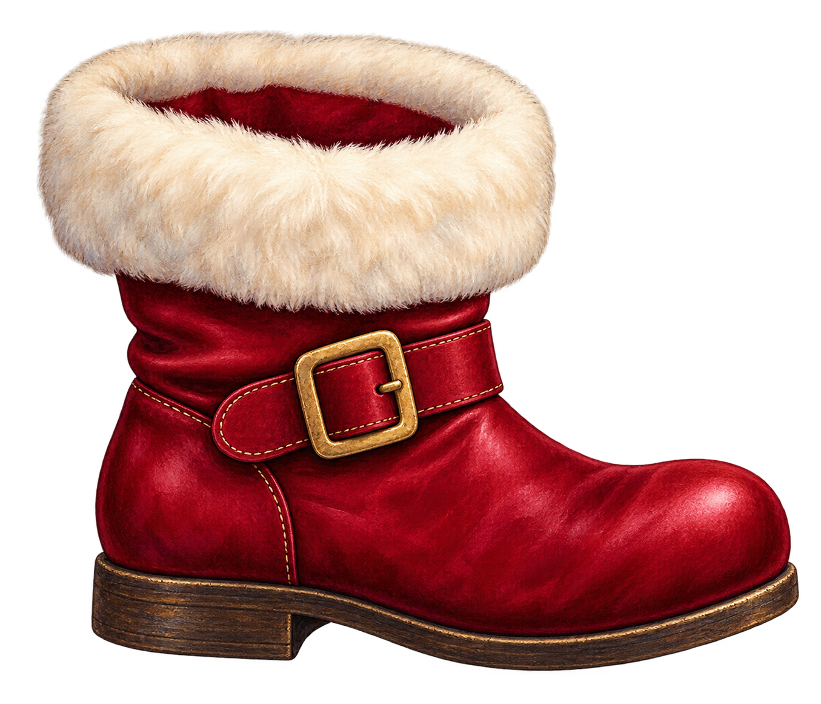
software/assets/dynamics_sources/seasonal-postcards-v1/advent-early/nicholas-boot.png
