ace-builder/Robbi/software/assets/dynamics_sources/seasonal-postcards-v1/advent-early/sage-mitten.png

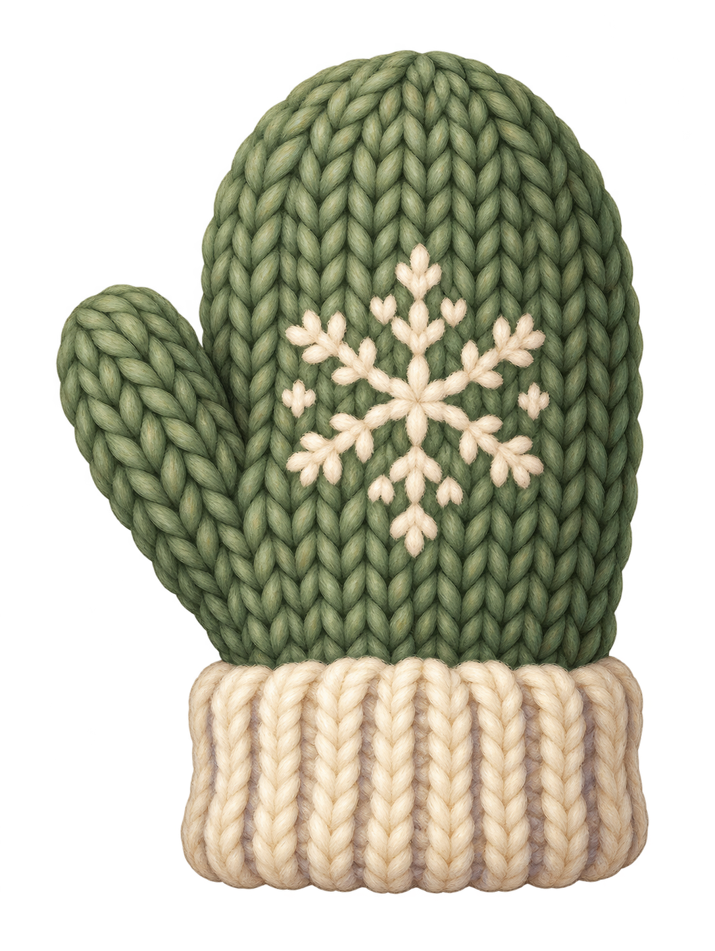
software/assets/dynamics_sources/seasonal-postcards-v1/advent-early/sage-mitten.png
