ace-builder/Robbi/software/assets/dynamics_sources/seasonal-postcards-v1/advent-late/festive-pinecone.png

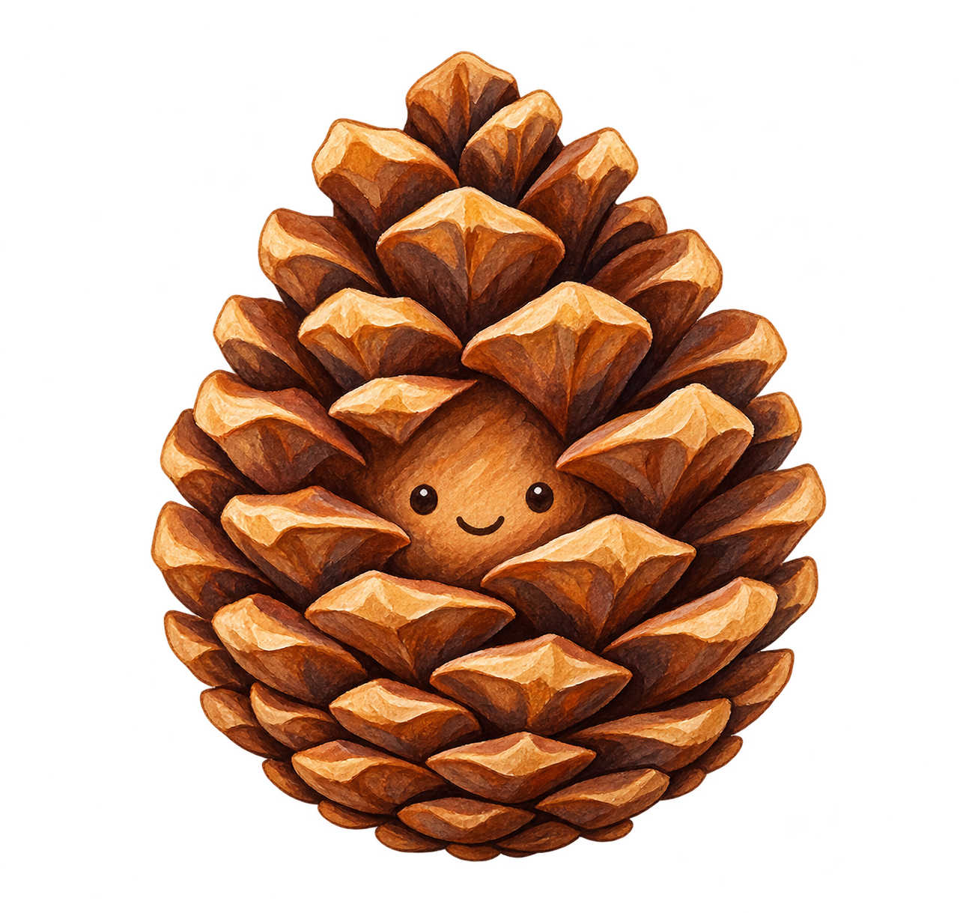
software/assets/dynamics_sources/seasonal-postcards-v1/advent-late/festive-pinecone.png
