ace-builder/Robbi/software/assets/dynamics_sources/seasonal-postcards-v1/advent-late/skating-penguin.png

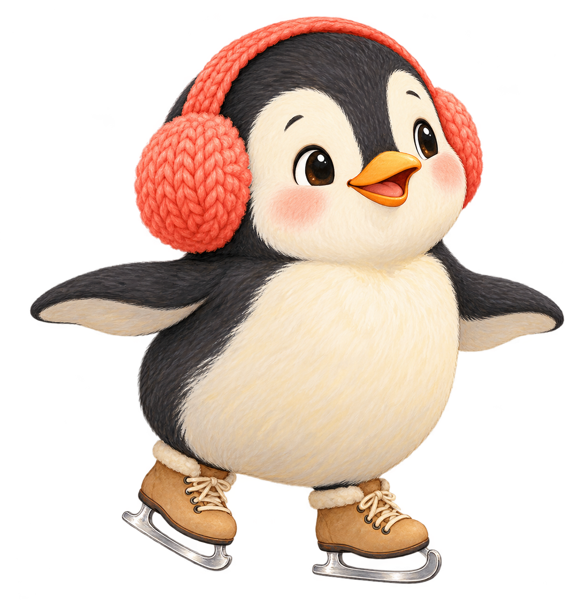
software/assets/dynamics_sources/seasonal-postcards-v1/advent-late/skating-penguin.png
