ace-builder/Robbi/software/assets/dynamics_sources/seasonal-postcards-v1/advent-late/sleepy-gingerbread.png

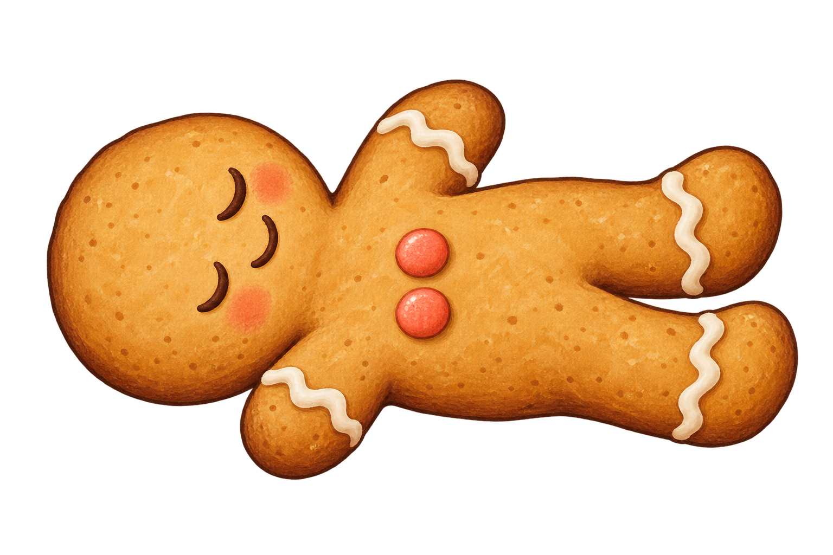
software/assets/dynamics_sources/seasonal-postcards-v1/advent-late/sleepy-gingerbread.png
