ace-builder/Robbi/software/assets/dynamics_sources/seasonal-postcards-v1/advent-late/snack-reindeer.png

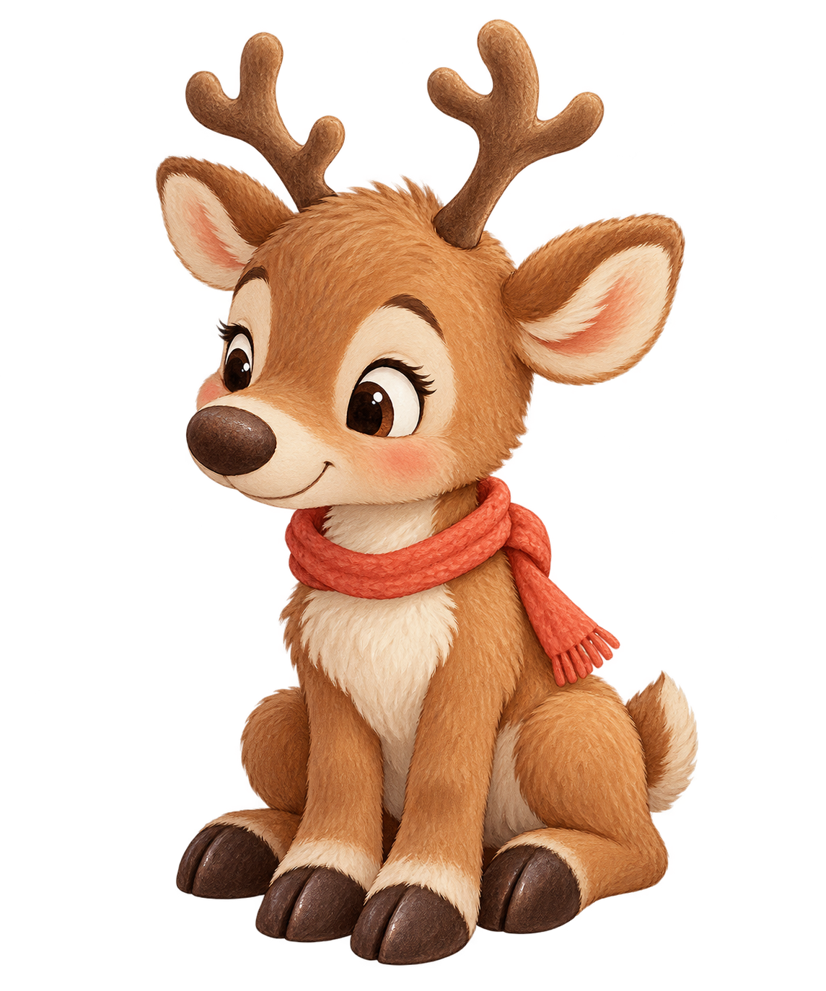
software/assets/dynamics_sources/seasonal-postcards-v1/advent-late/snack-reindeer.png
