ace-builder/Robbi/software/assets/dynamics_sources/seasonal-postcards-v1/holidays/autumn-hedgehog.png

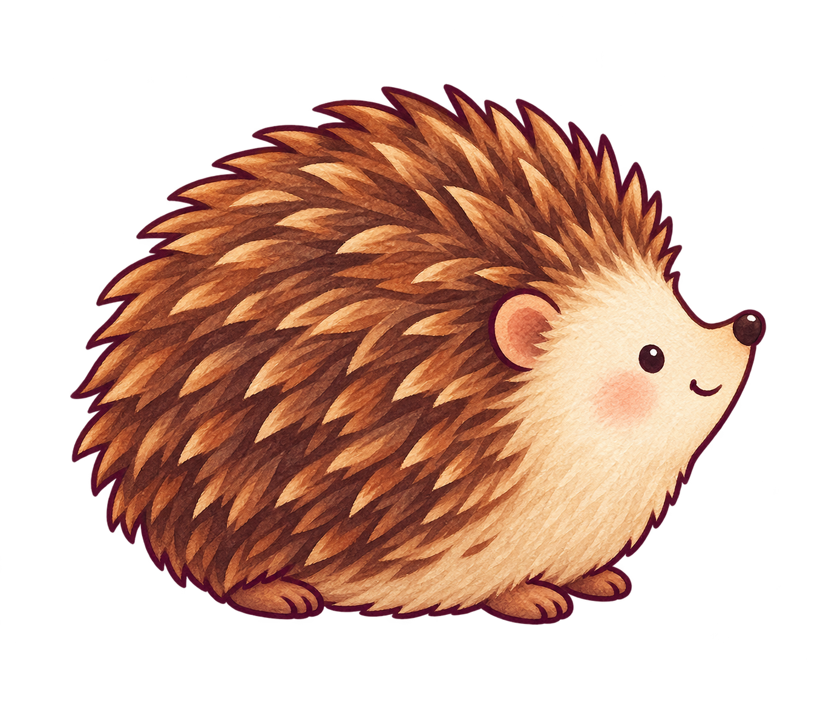
software/assets/dynamics_sources/seasonal-postcards-v1/holidays/autumn-hedgehog.png
