ace-builder/Robbi/software/assets/dynamics_sources/seasonal-postcards-v1/holidays/birthday-cake.png

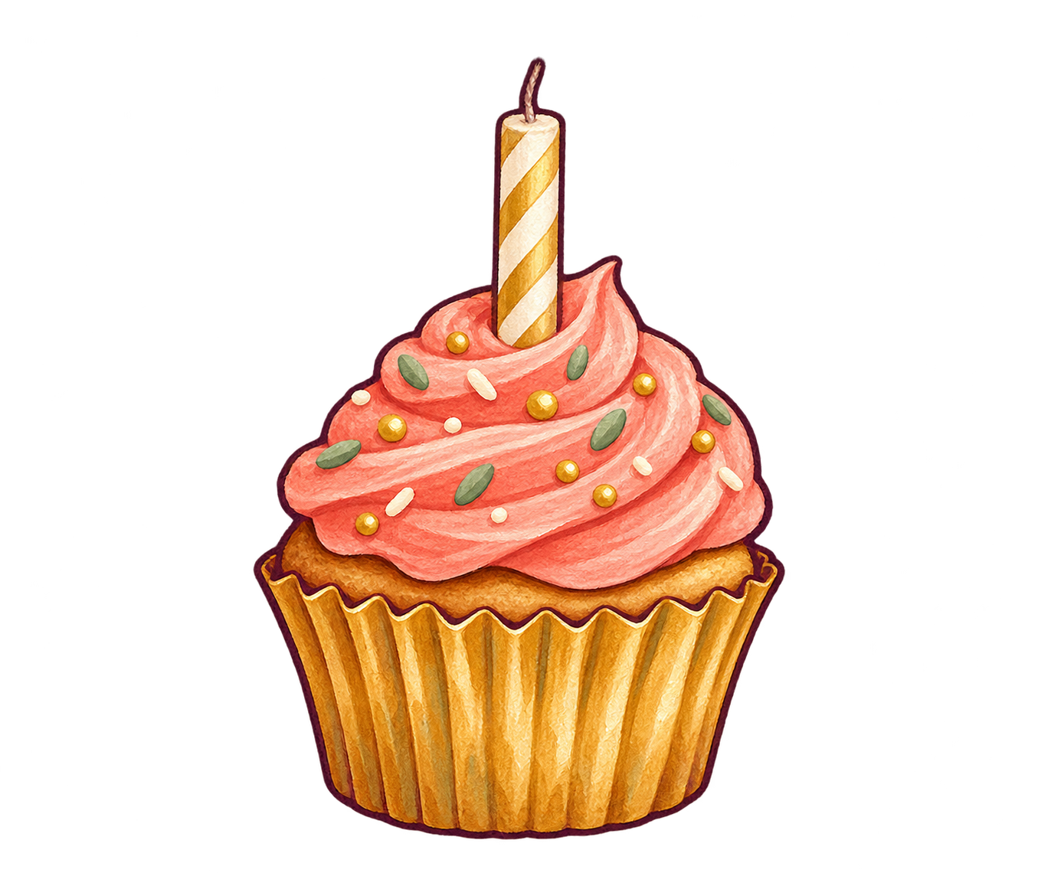
software/assets/dynamics_sources/seasonal-postcards-v1/holidays/birthday-cake.png
