ace-builder/Robbi/software/assets/dynamics_sources/seasonal-postcards-v1/holidays/gingerbread.png

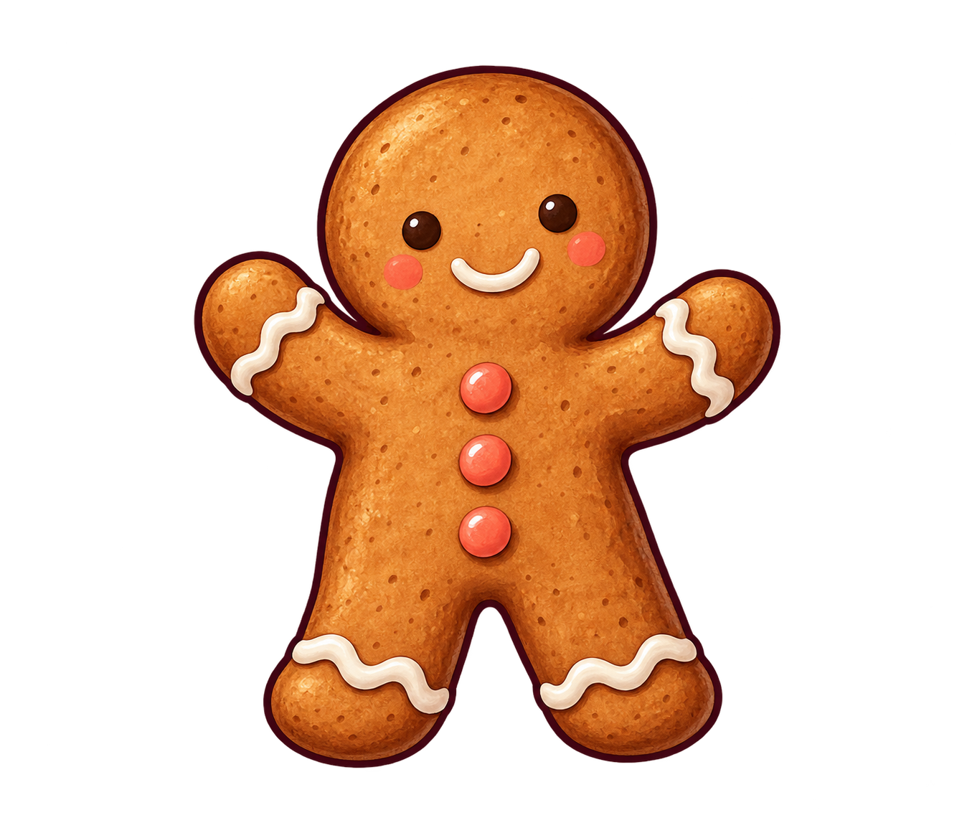
software/assets/dynamics_sources/seasonal-postcards-v1/holidays/gingerbread.png
