ace-builder/Robbi/software/assets/dynamics_sources/seasonal-postcards-v1/holidays/pumpkin.png

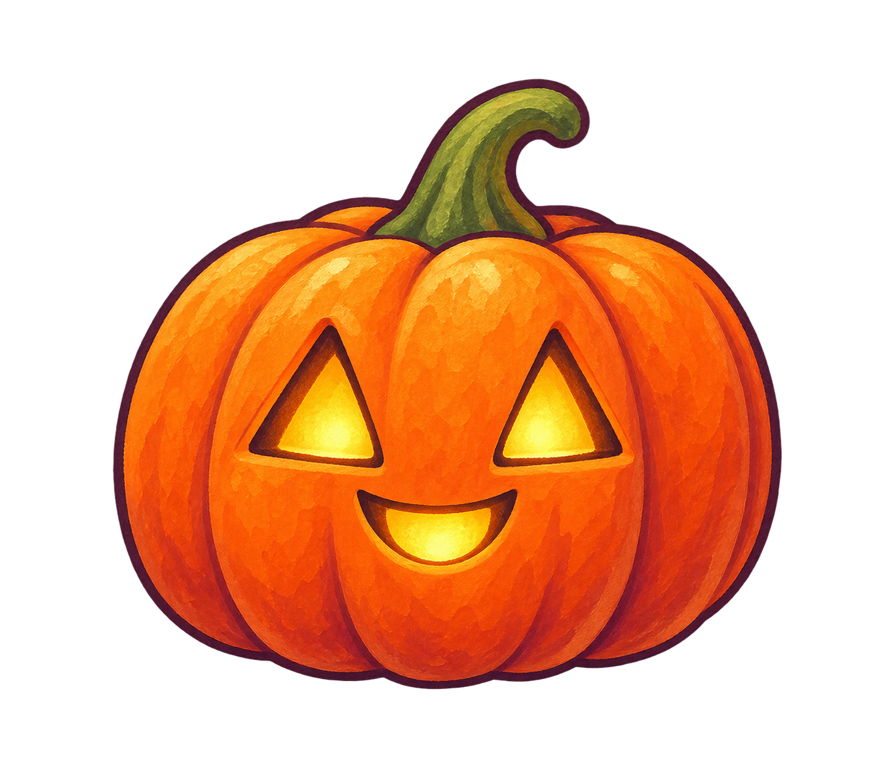
software/assets/dynamics_sources/seasonal-postcards-v1/holidays/pumpkin.png
