ace-builder/Robbi/software/assets/dynamics_sources/seasonal-postcards-v1/holidays/spring-wateringcan.png

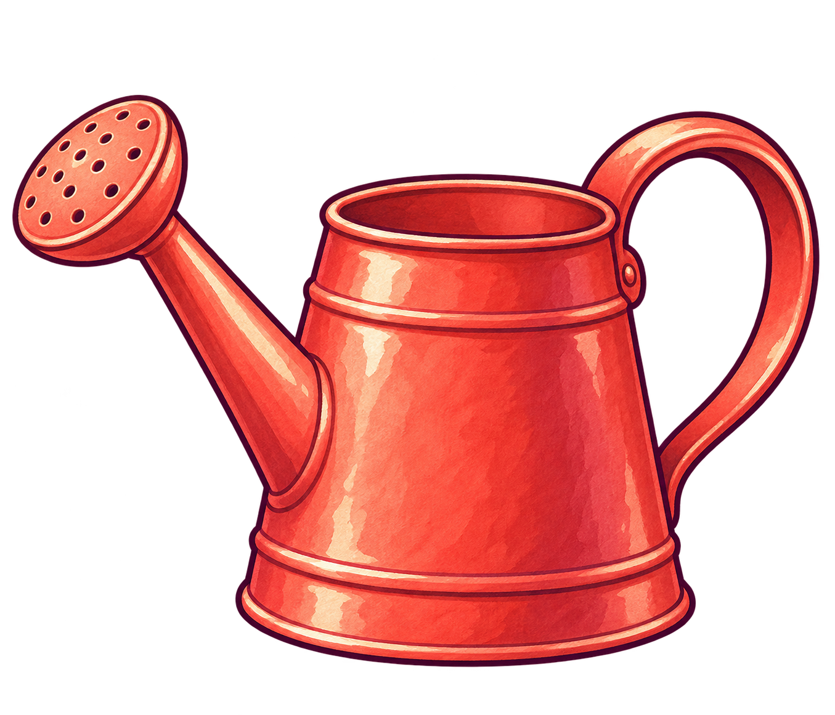
software/assets/dynamics_sources/seasonal-postcards-v1/holidays/spring-wateringcan.png
