ace-builder/Robbi/software/assets/dynamics_sources/seasonal-postcards-v1/holidays/summer-icecream.png

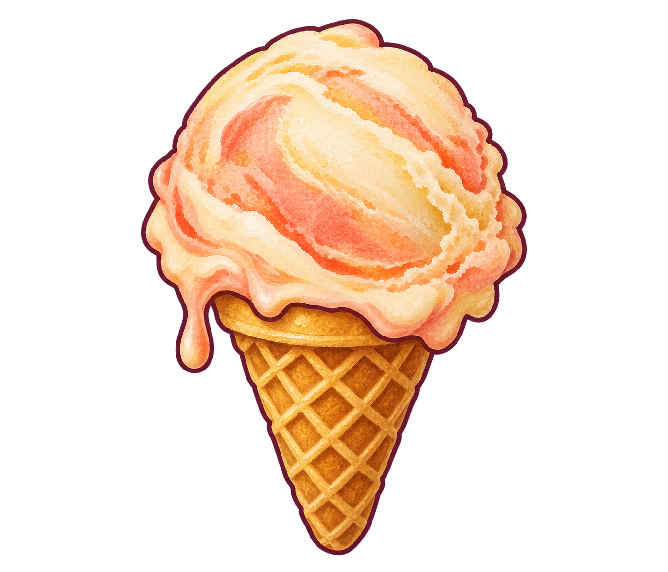
software/assets/dynamics_sources/seasonal-postcards-v1/holidays/summer-icecream.png
