ace-builder/Robbi/software/assets/face_animations/advent-01.png

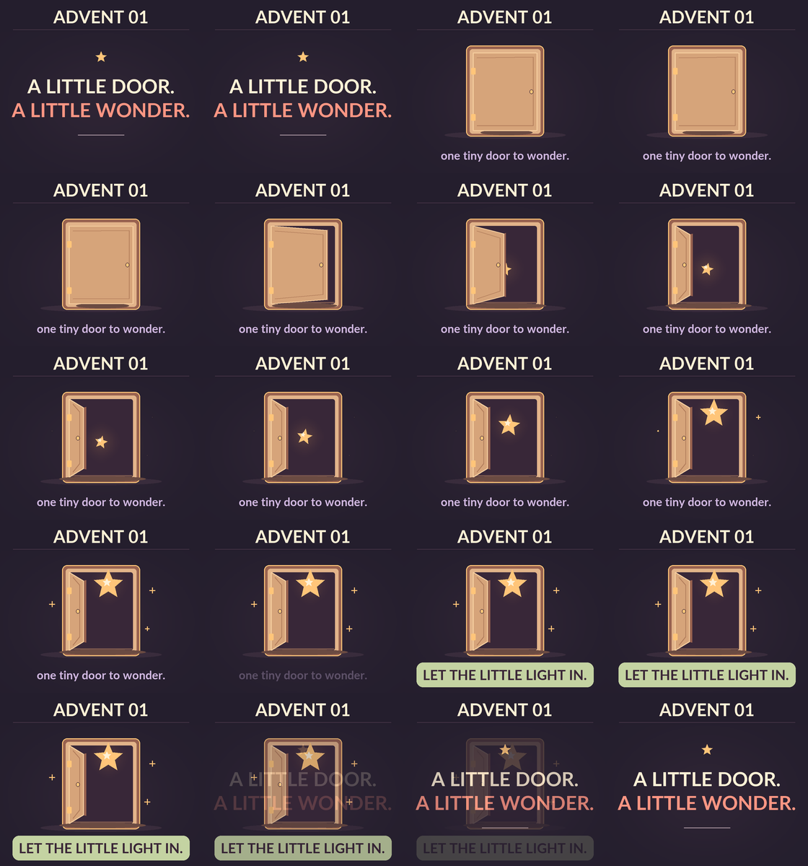
software/assets/face_animations/advent-01.png
