ace-builder/Robbi/software/assets/face_animations/advent-02.png

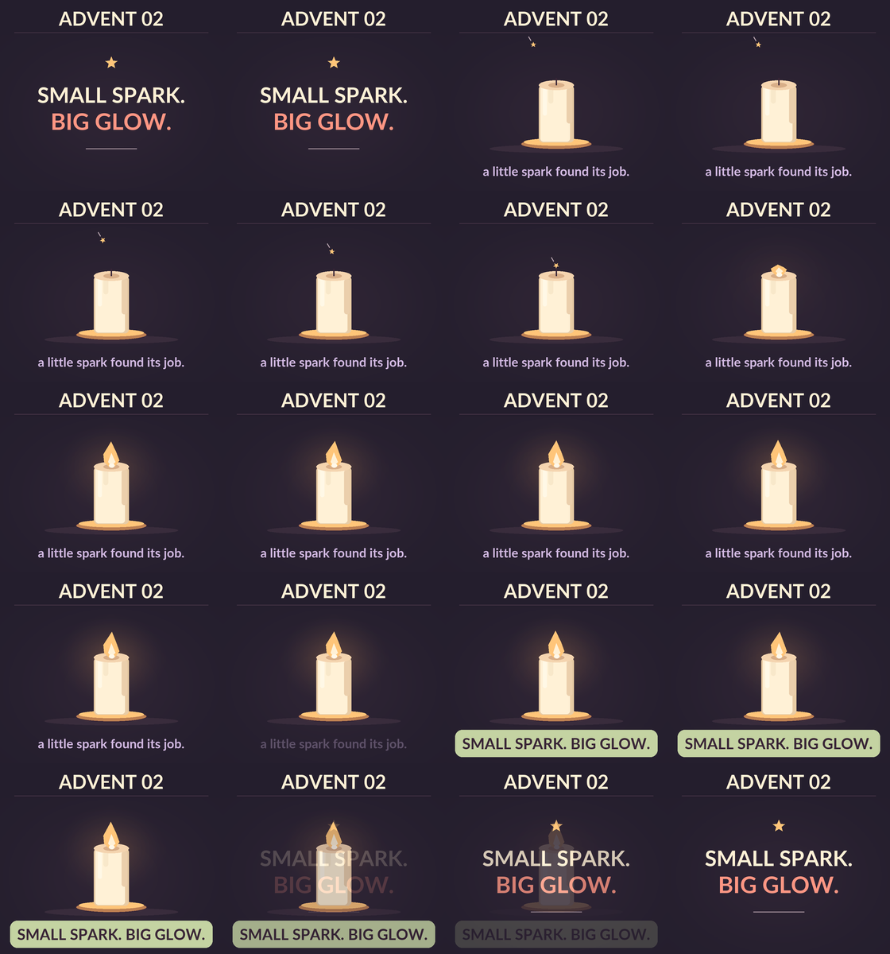
software/assets/face_animations/advent-02.png
