ace-builder/Robbi/software/assets/face_animations/advent-09.png

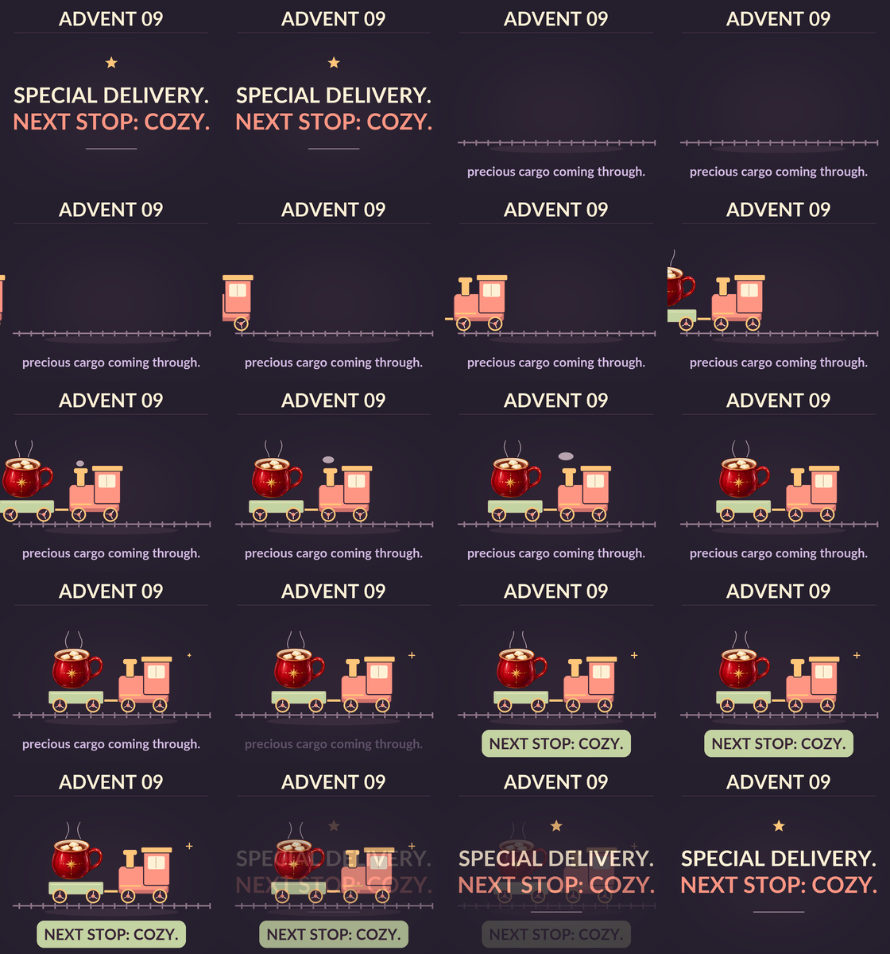
software/assets/face_animations/advent-09.png
