ace-builder/Robbi/software/assets/face_animations/advent-11.png

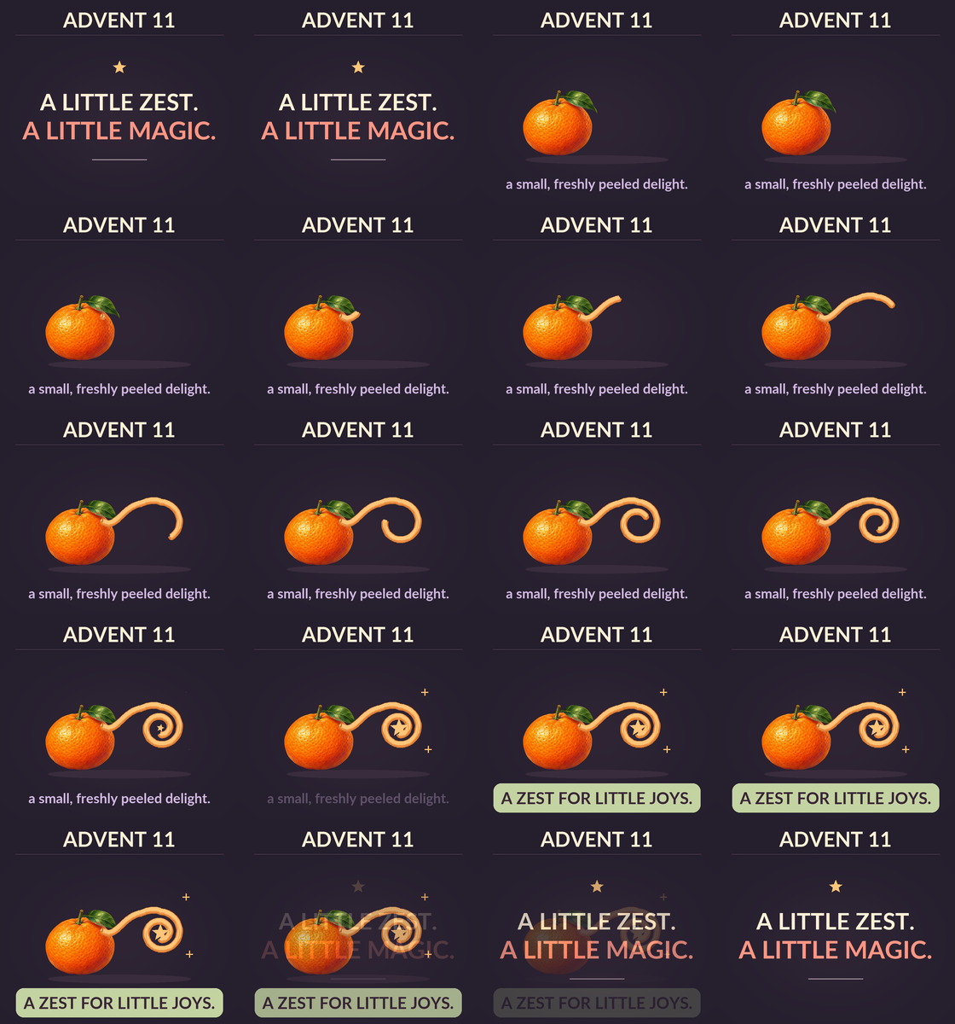
software/assets/face_animations/advent-11.png
