ace-builder/Robbi/software/assets/face_animations/advent-18.png

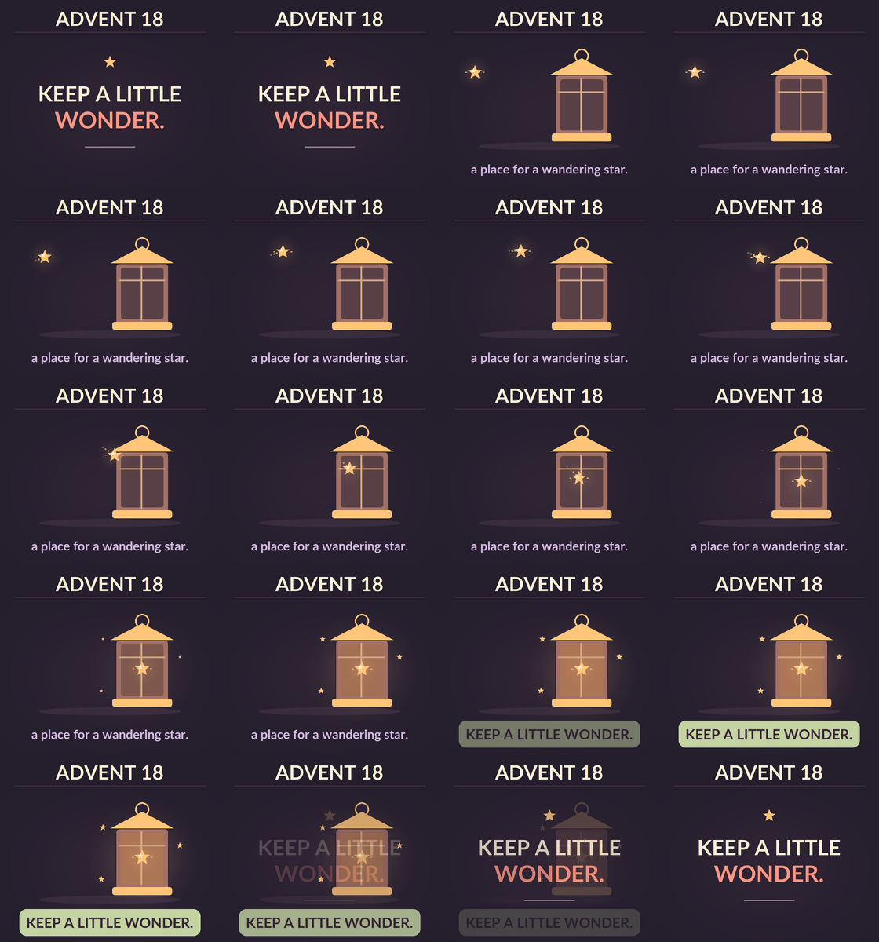
software/assets/face_animations/advent-18.png
