ace-builder/Robbi/software/assets/face_animations/advent-20.png

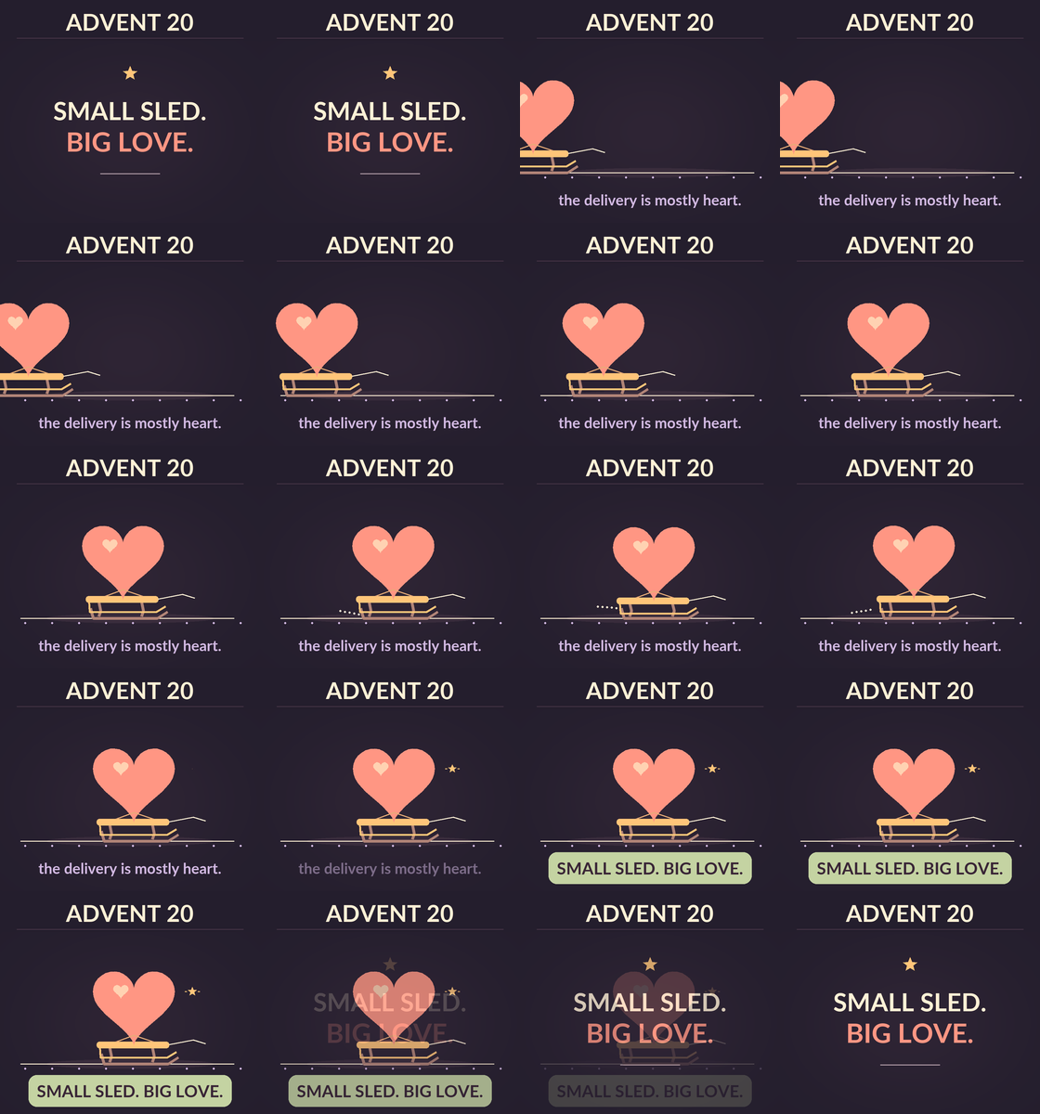
software/assets/face_animations/advent-20.png
