ace-builder/Robbi/software/assets/face_animations/advent-23.png

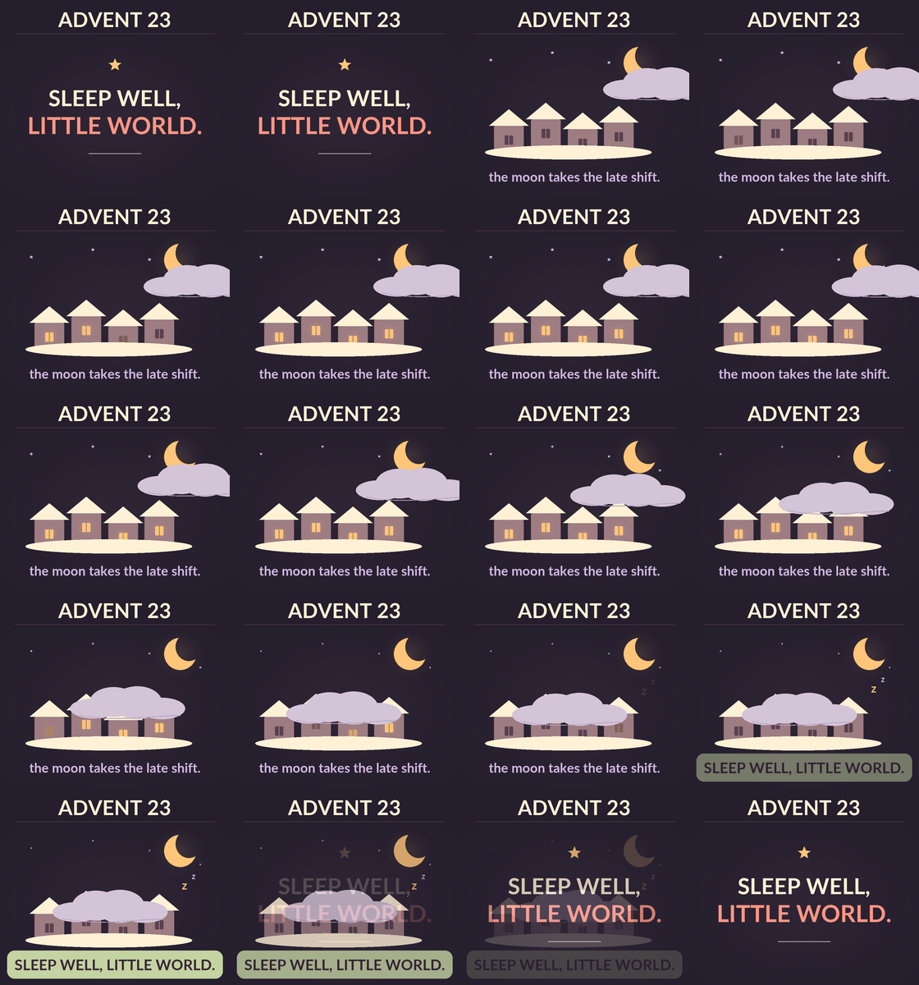
software/assets/face_animations/advent-23.png
