ace-builder/Robbi/software/assets/face_animations/amazed-gasp.png

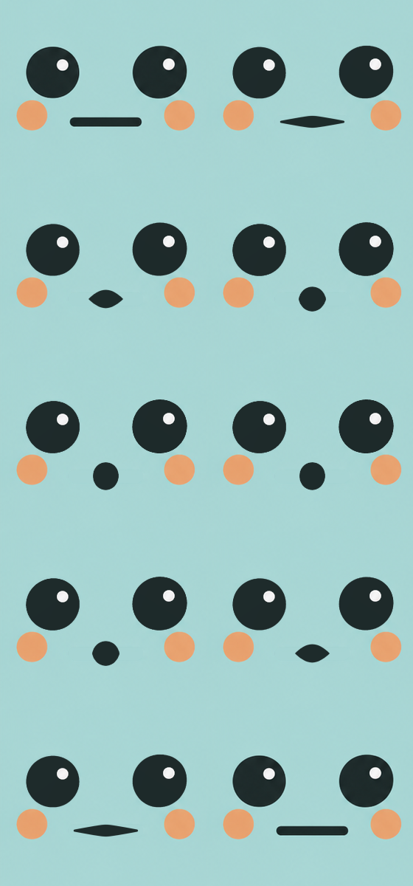
software/assets/face_animations/amazed-gasp.png
