ace-builder/Robbi/software/assets/face_animations/expression-atlas-v2.png

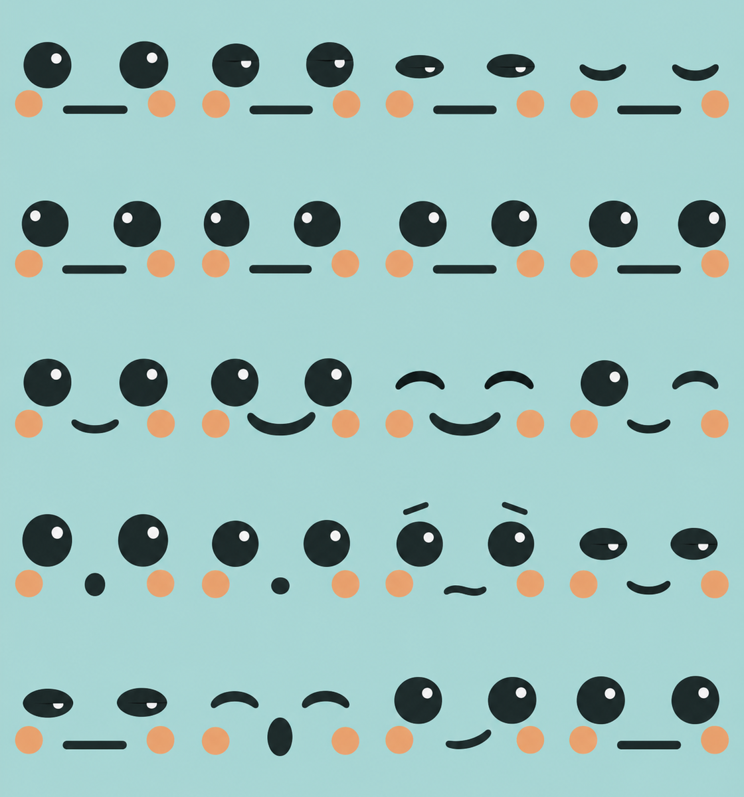
software/assets/face_animations/expression-atlas-v2.png
