ace-builder/Robbi/software/assets/face_animations/gag-achievement.png

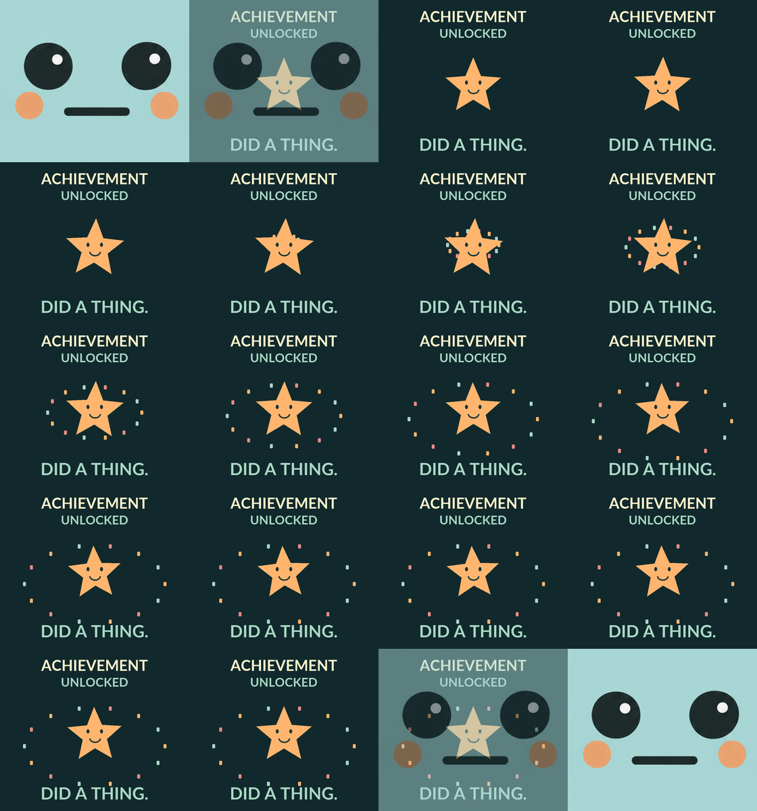
software/assets/face_animations/gag-achievement.png
