ace-builder/Robbi/software/assets/face_animations/gag-buffering.png

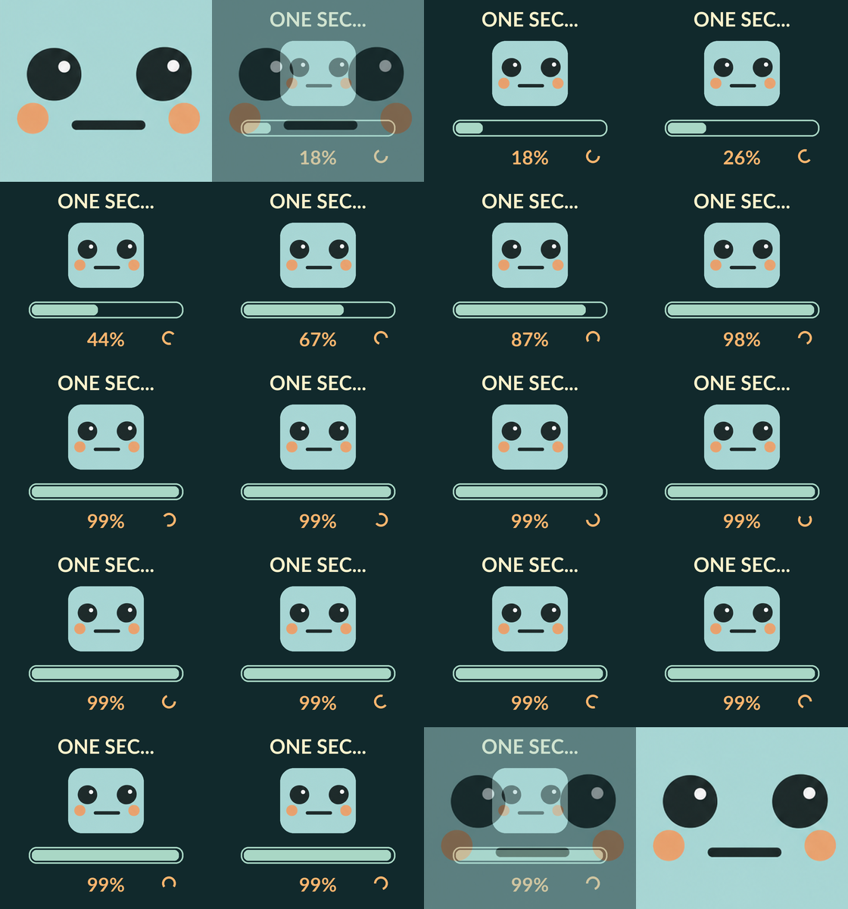
software/assets/face_animations/gag-buffering.png
