ace-builder/Robbi/software/assets/face_animations/gag-deal-with-it.png

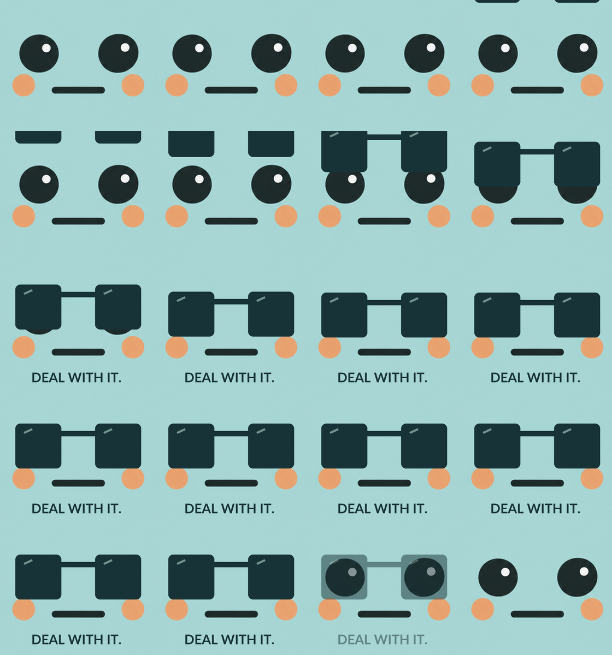
software/assets/face_animations/gag-deal-with-it.png
