ace-builder/Robbi/software/assets/face_animations/gag-dramatic-zoom.png

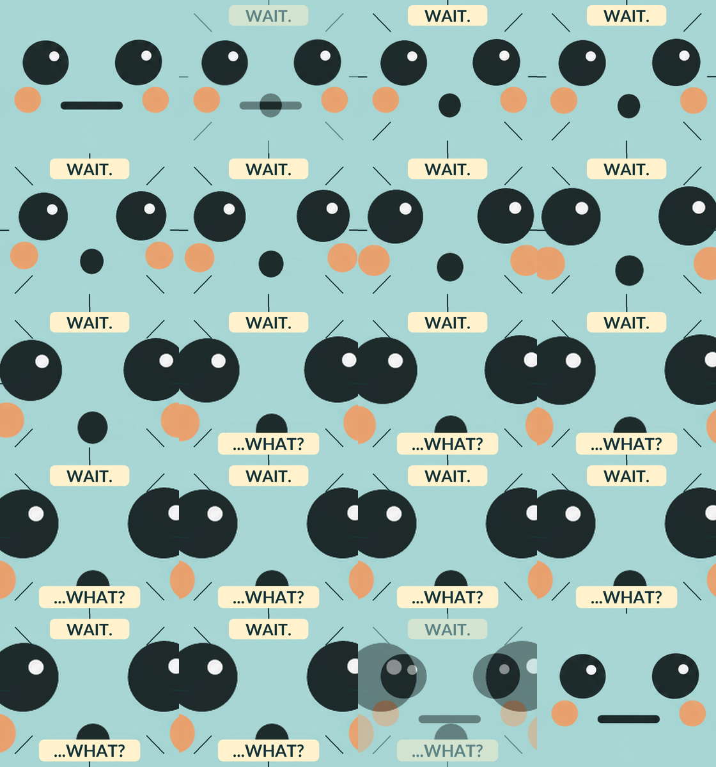
software/assets/face_animations/gag-dramatic-zoom.png
