ace-builder/Robbi/software/assets/face_animations/gag-hamster-brain.png

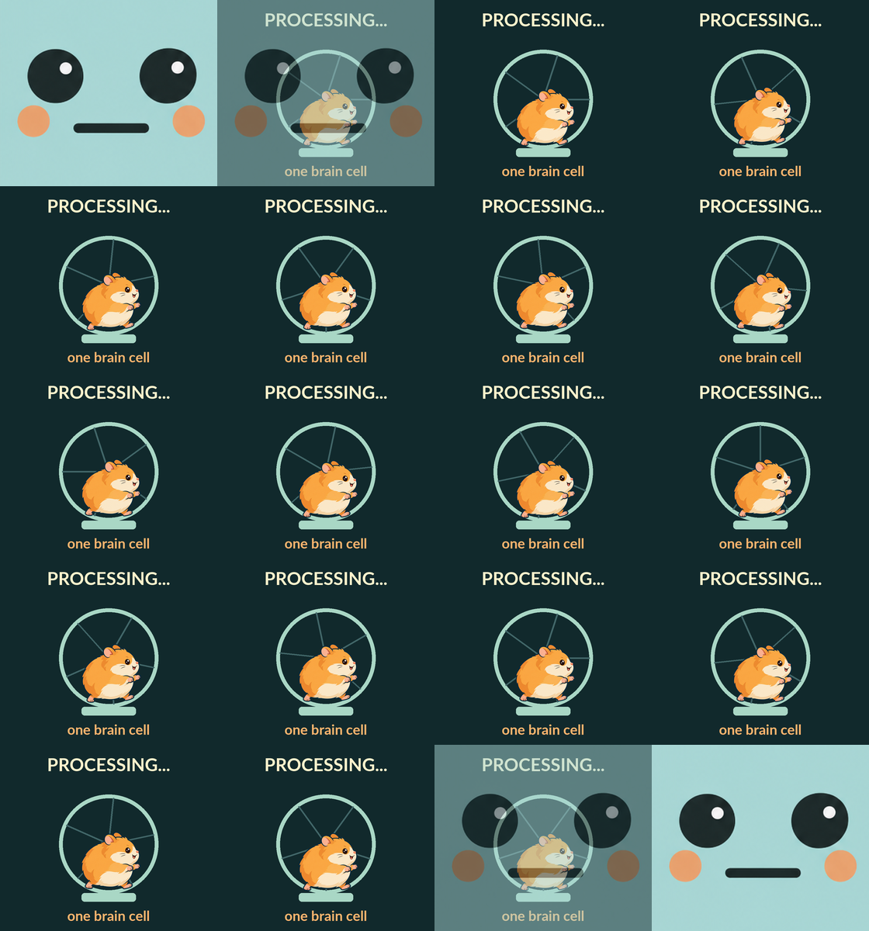
software/assets/face_animations/gag-hamster-brain.png
