ace-builder/Robbi/software/assets/face_animations/gag-touch-grass.png

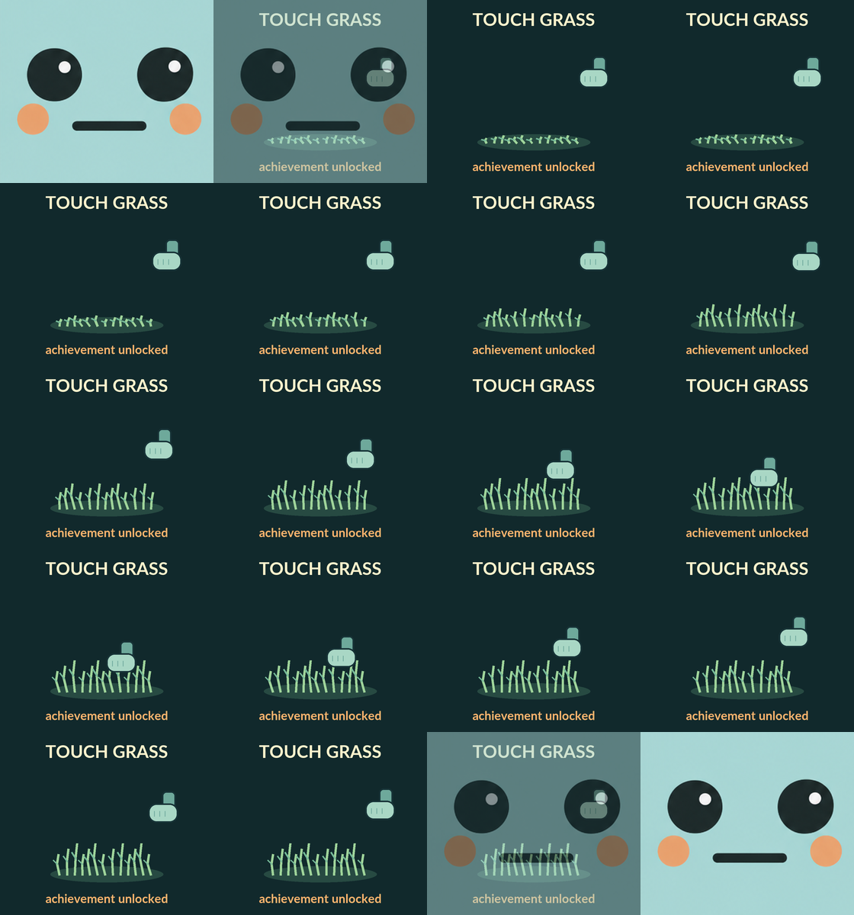
software/assets/face_animations/gag-touch-grass.png
