ace-builder/Robbi/software/assets/face_animations/meme-brain-tabs.png

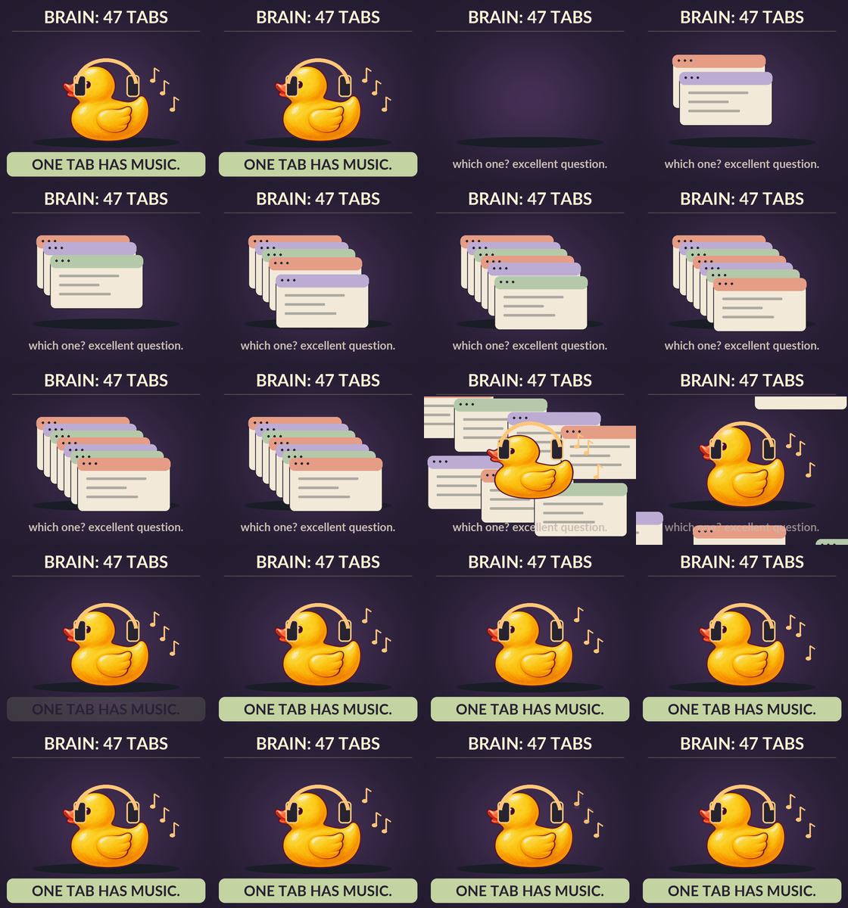
software/assets/face_animations/meme-brain-tabs.png
