ace-builder/Robbi/software/assets/face_animations/meme-expectation-luggage.png

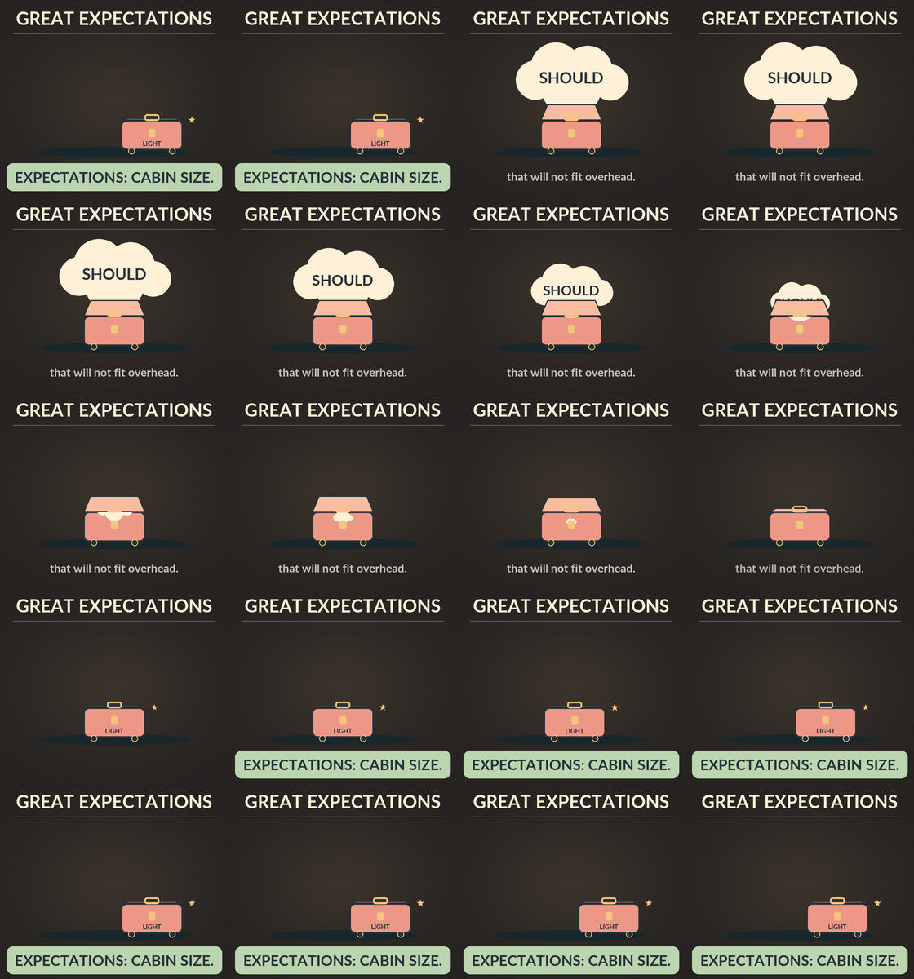
software/assets/face_animations/meme-expectation-luggage.png
