ace-builder/Robbi/software/assets/face_animations/meme-hot-take-freezer.png

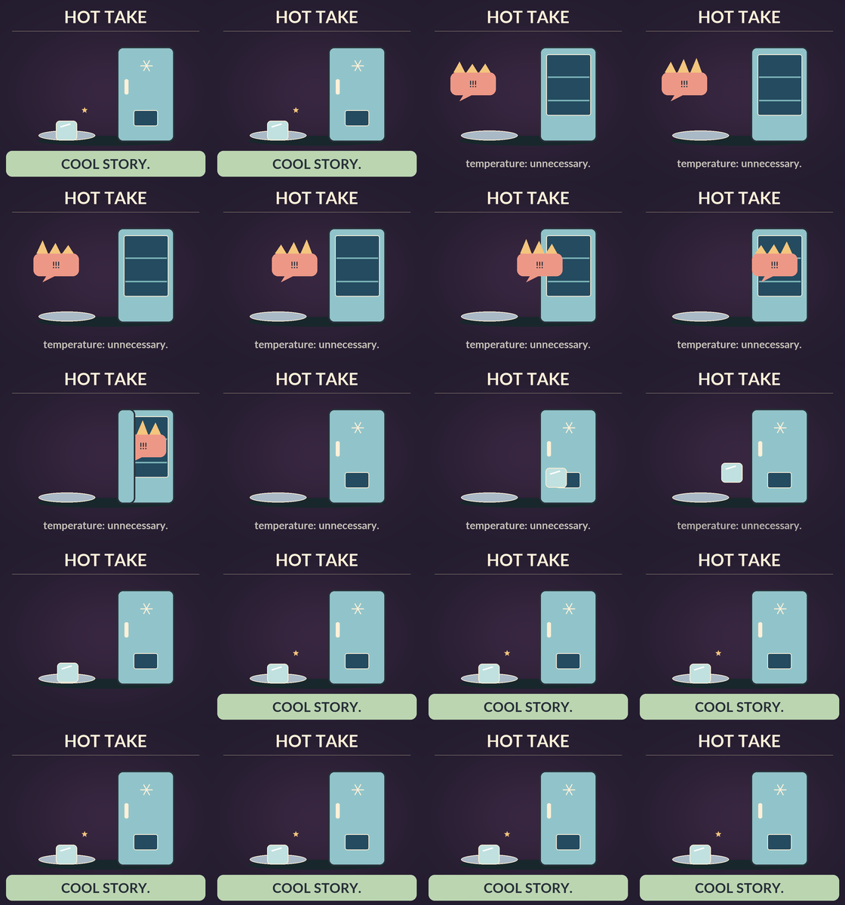
software/assets/face_animations/meme-hot-take-freezer.png
