ace-builder/Robbi/software/assets/face_animations/meme-meeting-escape.png

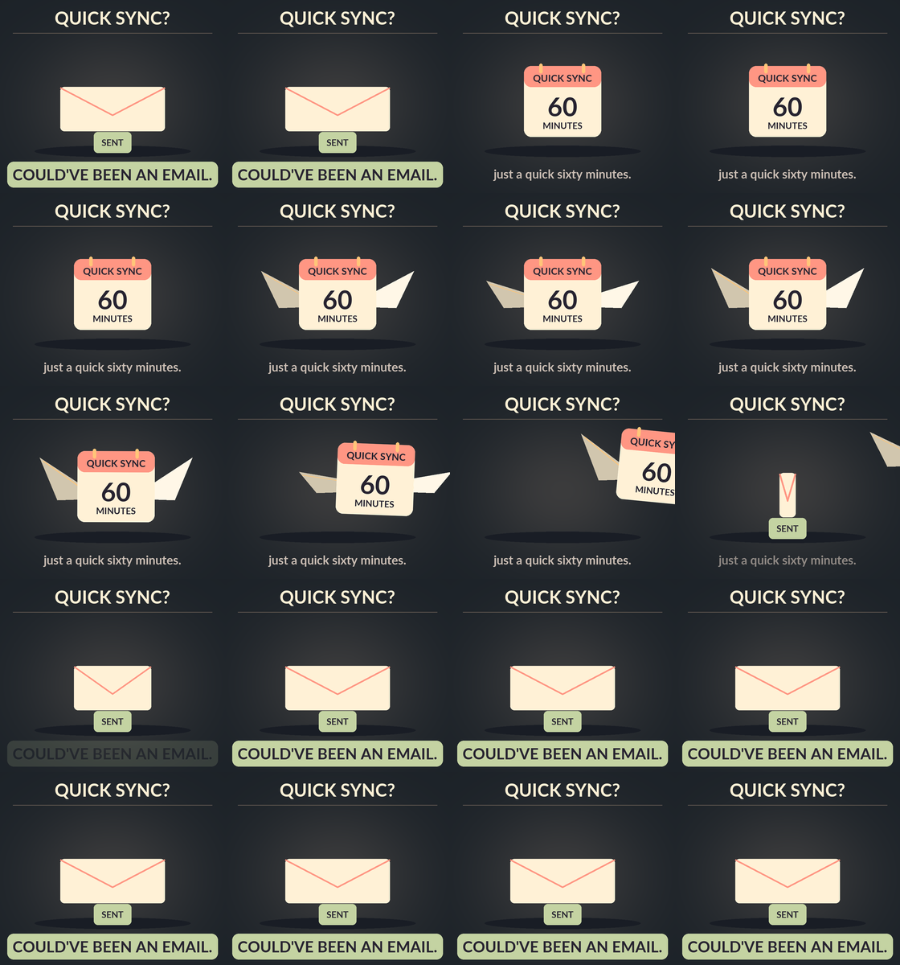
software/assets/face_animations/meme-meeting-escape.png
