ace-builder/Robbi/software/assets/face_animations/meme-moving-goalposts.png

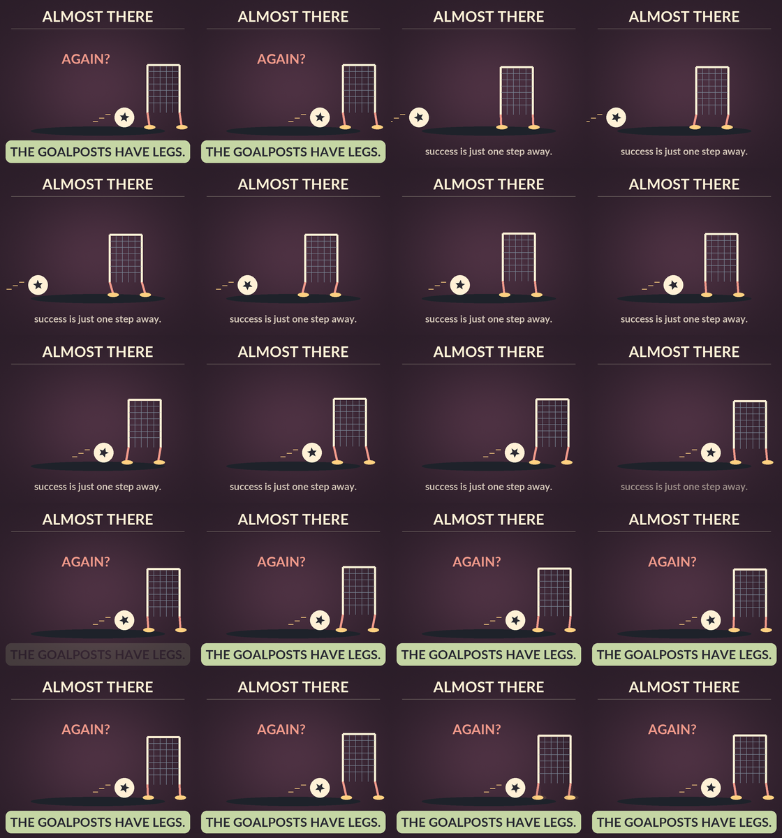
software/assets/face_animations/meme-moving-goalposts.png
