ace-builder/Robbi/software/assets/face_animations/meme-optimism-shredder.png

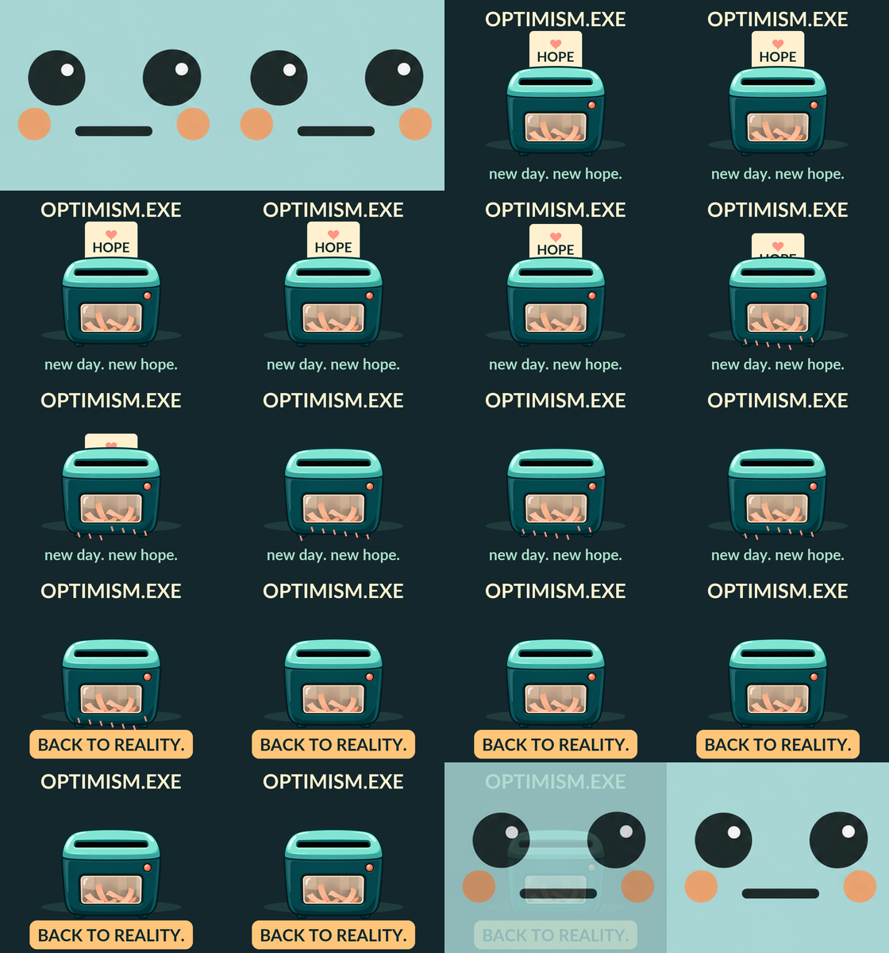
software/assets/face_animations/meme-optimism-shredder.png
