ace-builder/Robbi/software/assets/face_animations/meme-plot-armor.png

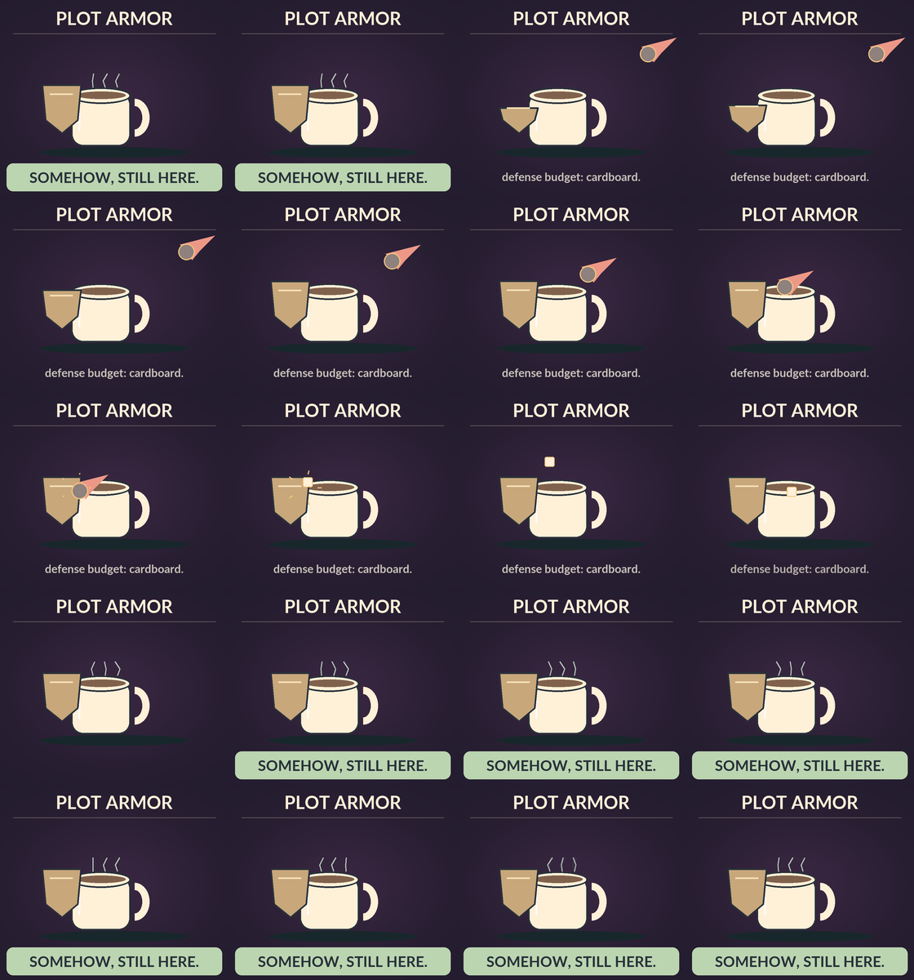
software/assets/face_animations/meme-plot-armor.png
