ace-builder/Robbi/software/assets/face_animations/meme-plot-twist-boat.png

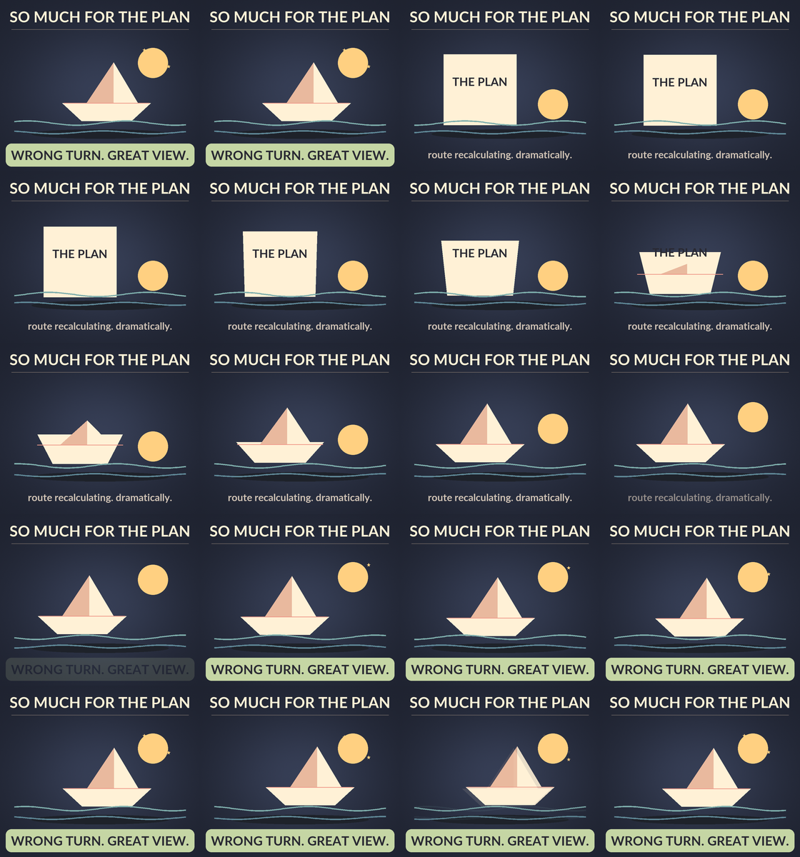
software/assets/face_animations/meme-plot-twist-boat.png
