ace-builder/Robbi/software/assets/face_animations/meme-urgent-laundry.png

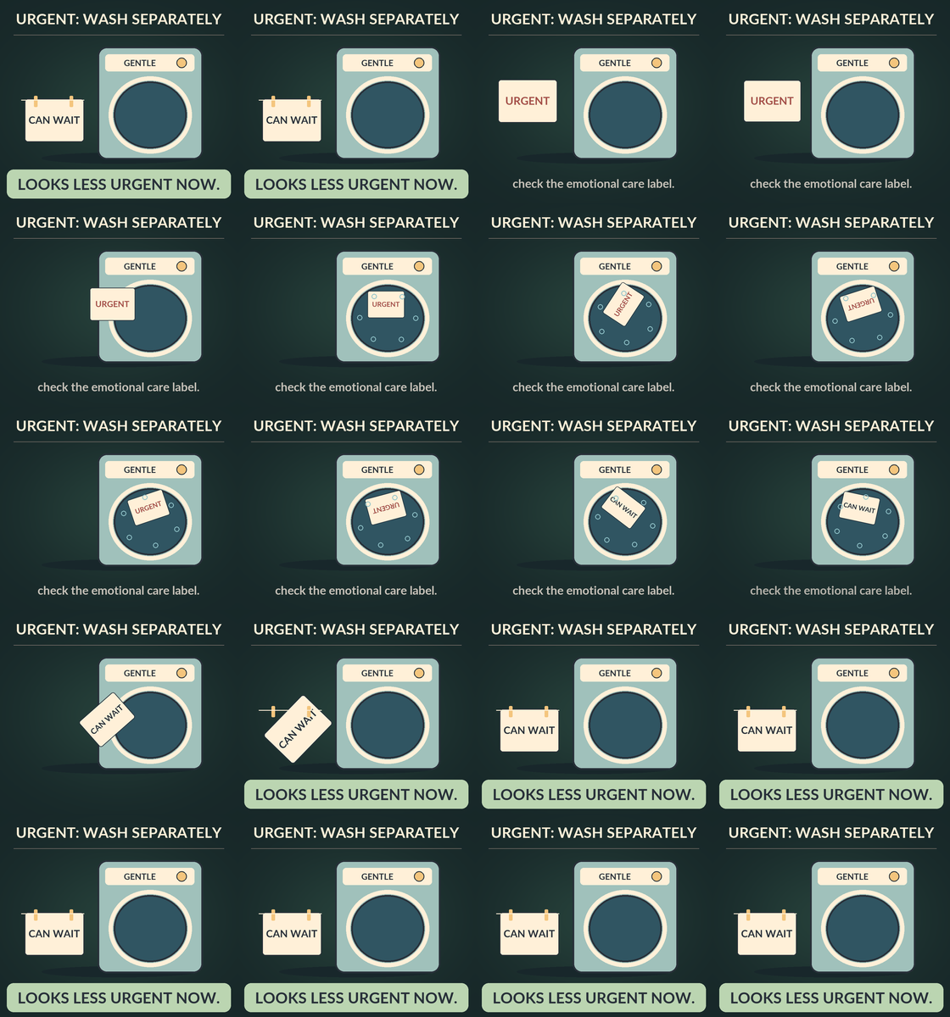
software/assets/face_animations/meme-urgent-laundry.png
