ace-builder/Robbi/software/assets/face_animations/meme-vibe-check.png

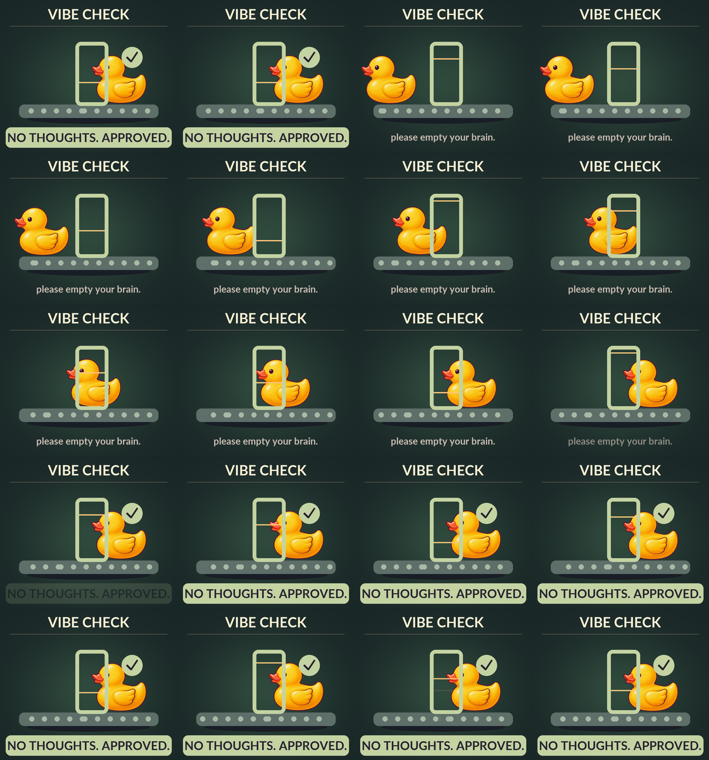
software/assets/face_animations/meme-vibe-check.png
