ace-builder/Robbi/software/assets/face_animations/post-peace-tea.png

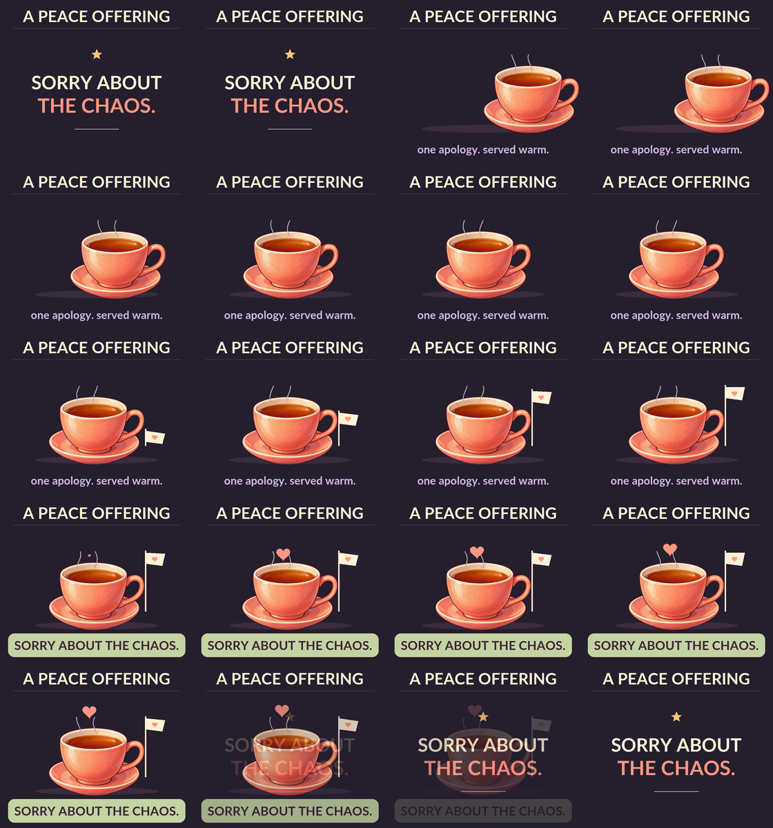
software/assets/face_animations/post-peace-tea.png
