ace-builder/Robbi/software/assets/face_animations/post-return-guilt.png

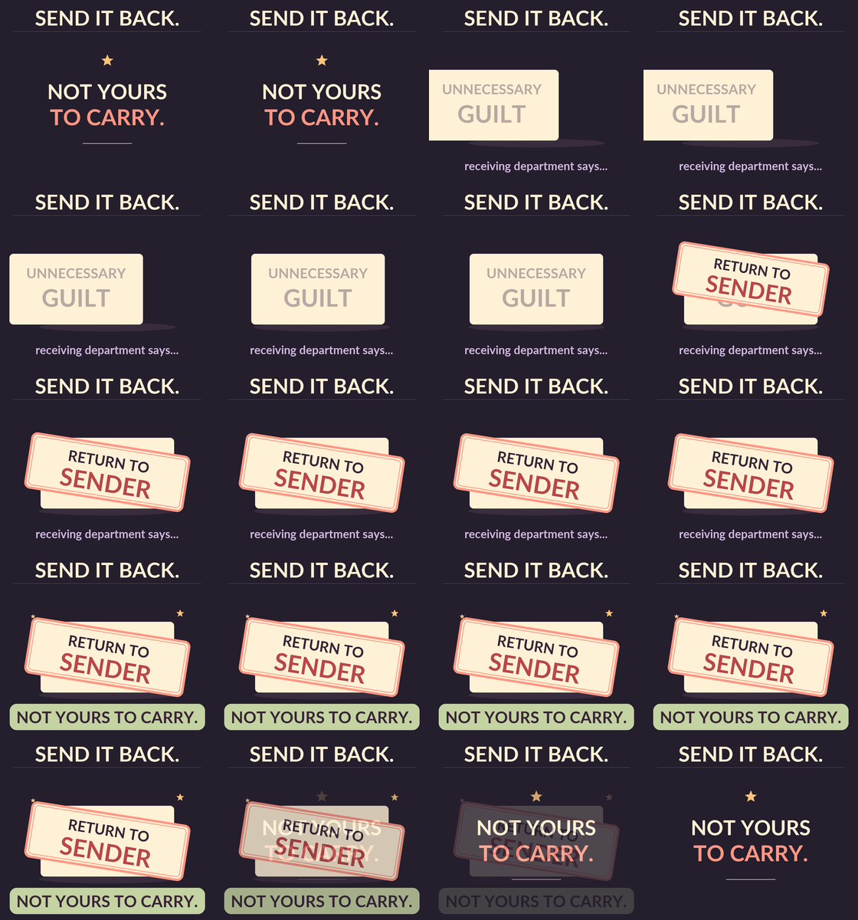
software/assets/face_animations/post-return-guilt.png
