ace-builder/Robbi/software/assets/face_animations/post-slow-club.png

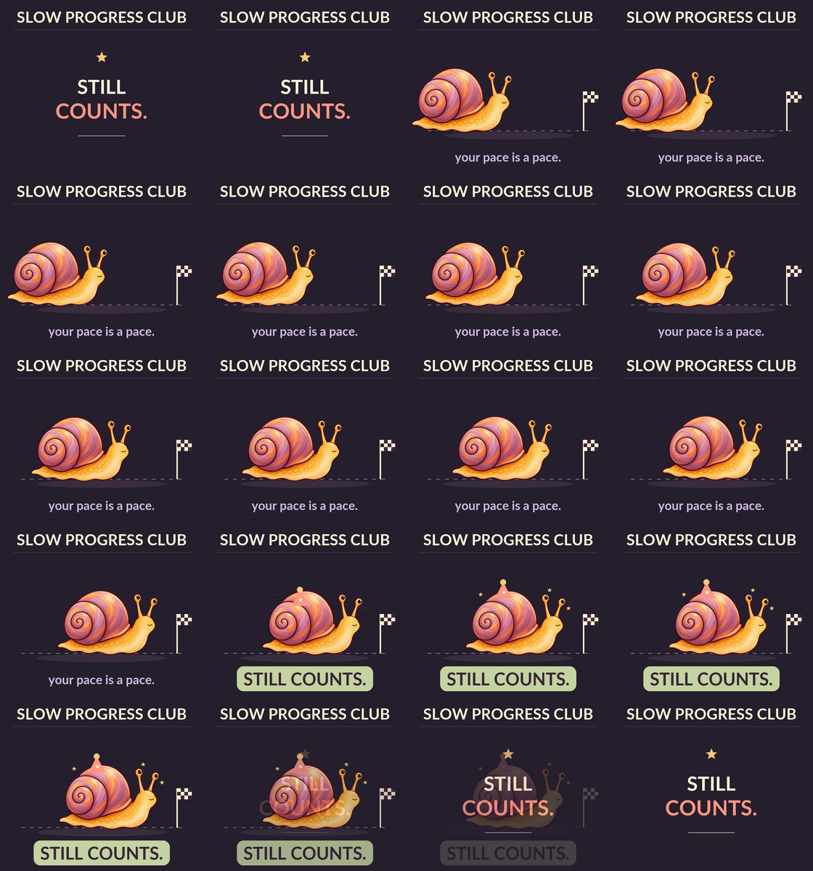
software/assets/face_animations/post-slow-club.png
