ace-builder/Robbi/software/assets/face_animations/season-oktoberfest.png

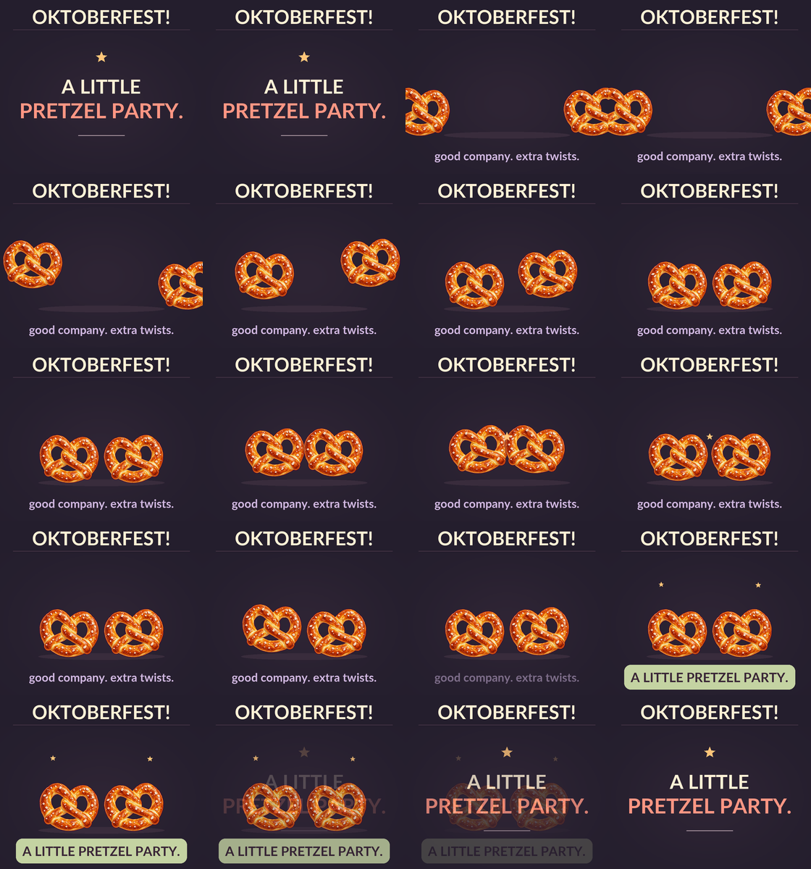
software/assets/face_animations/season-oktoberfest.png
