ace-builder/Robbi/software/assets/face_animations/season-spring.png

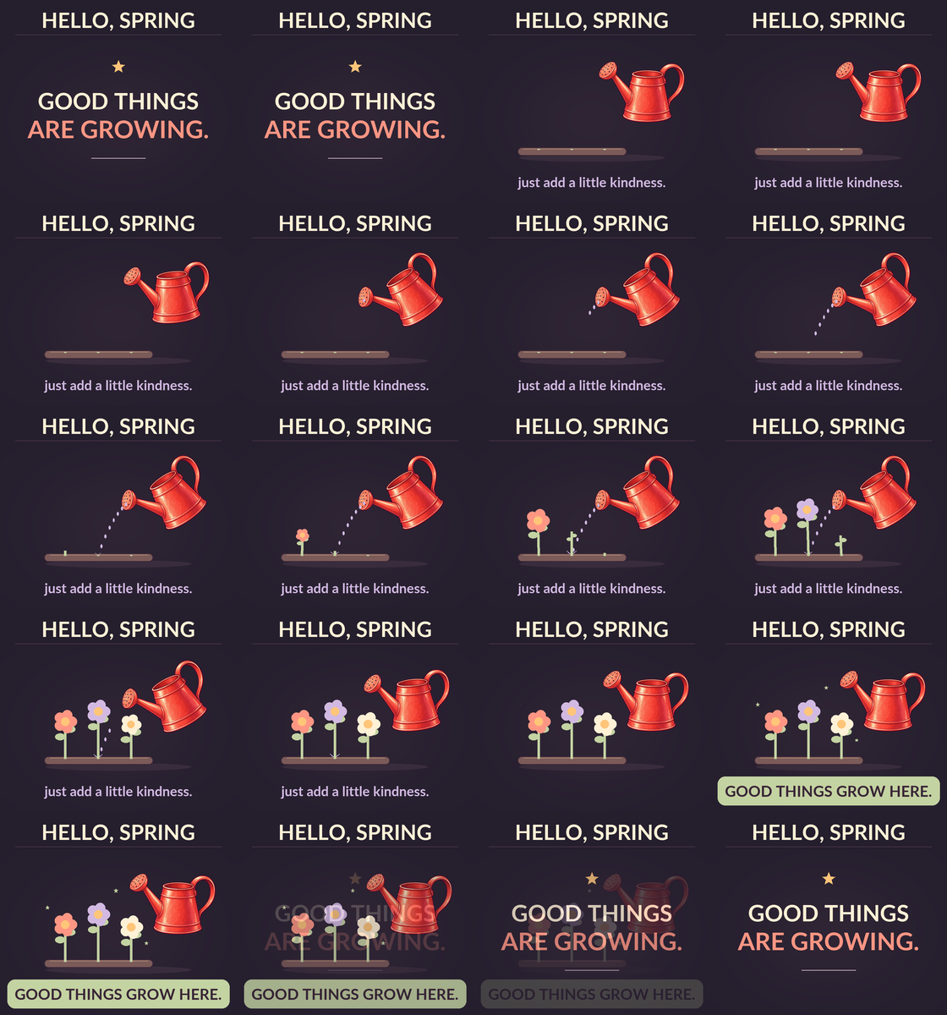
software/assets/face_animations/season-spring.png
