ace-builder/Robbi/software/assets/face_animations/sweet-cookie.png

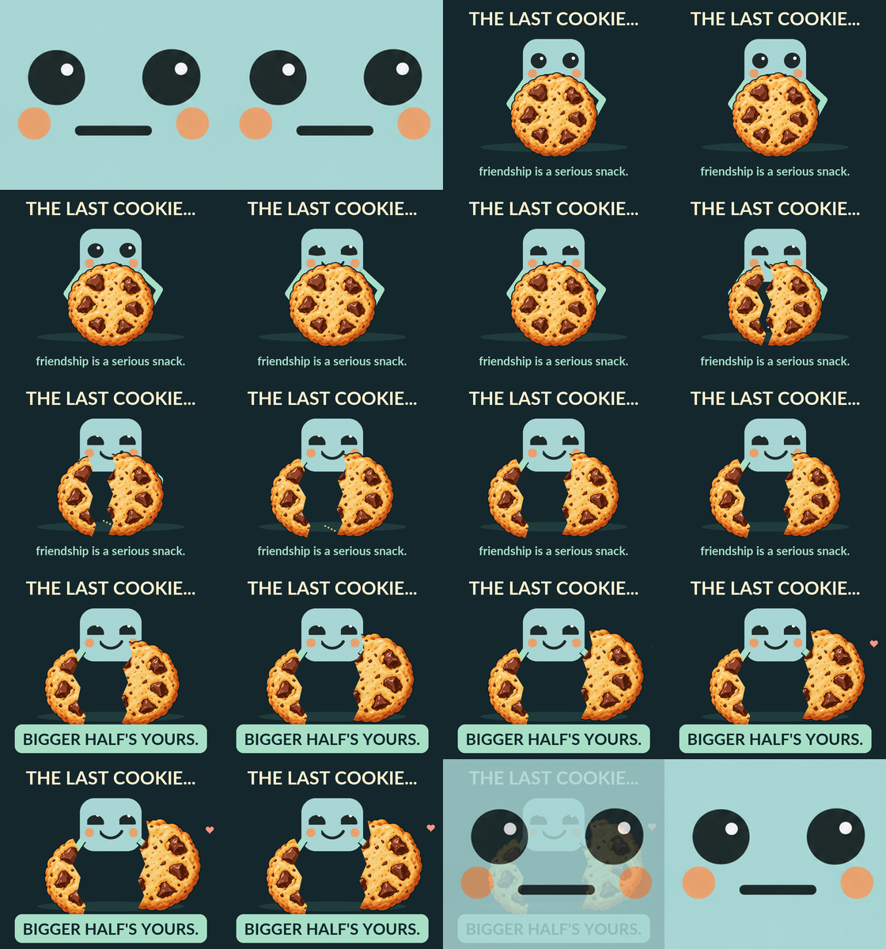
software/assets/face_animations/sweet-cookie.png
