ace-builder/Robbi/software/assets/face_animations/sweet-flower.png

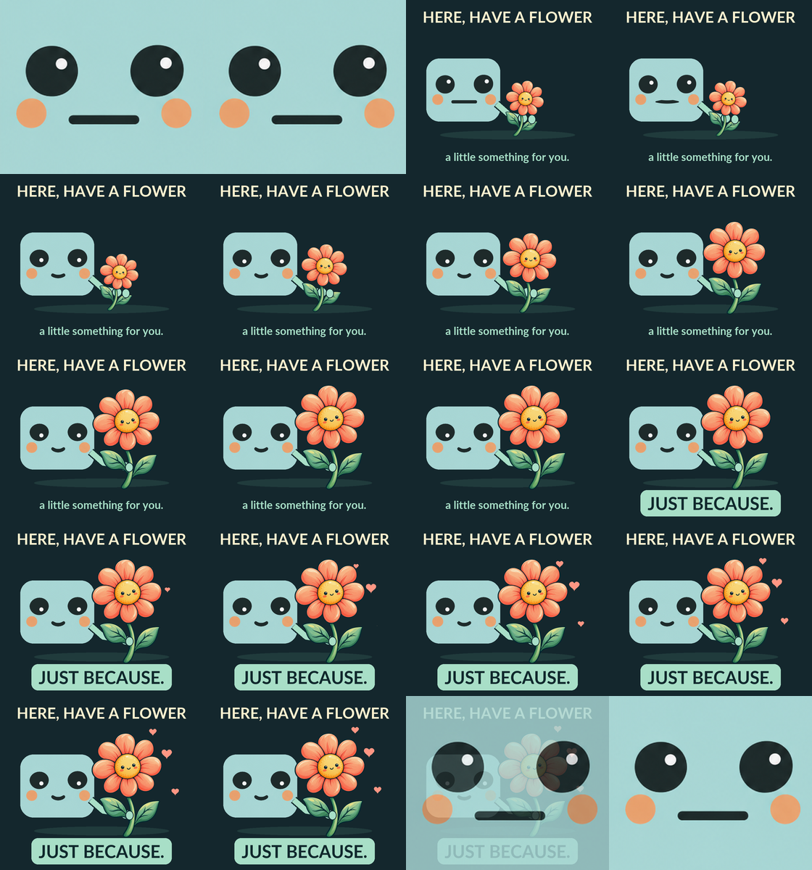
software/assets/face_animations/sweet-flower.png
