ace-builder/Robbi/software/assets/face_animations/sweet-sorry.png

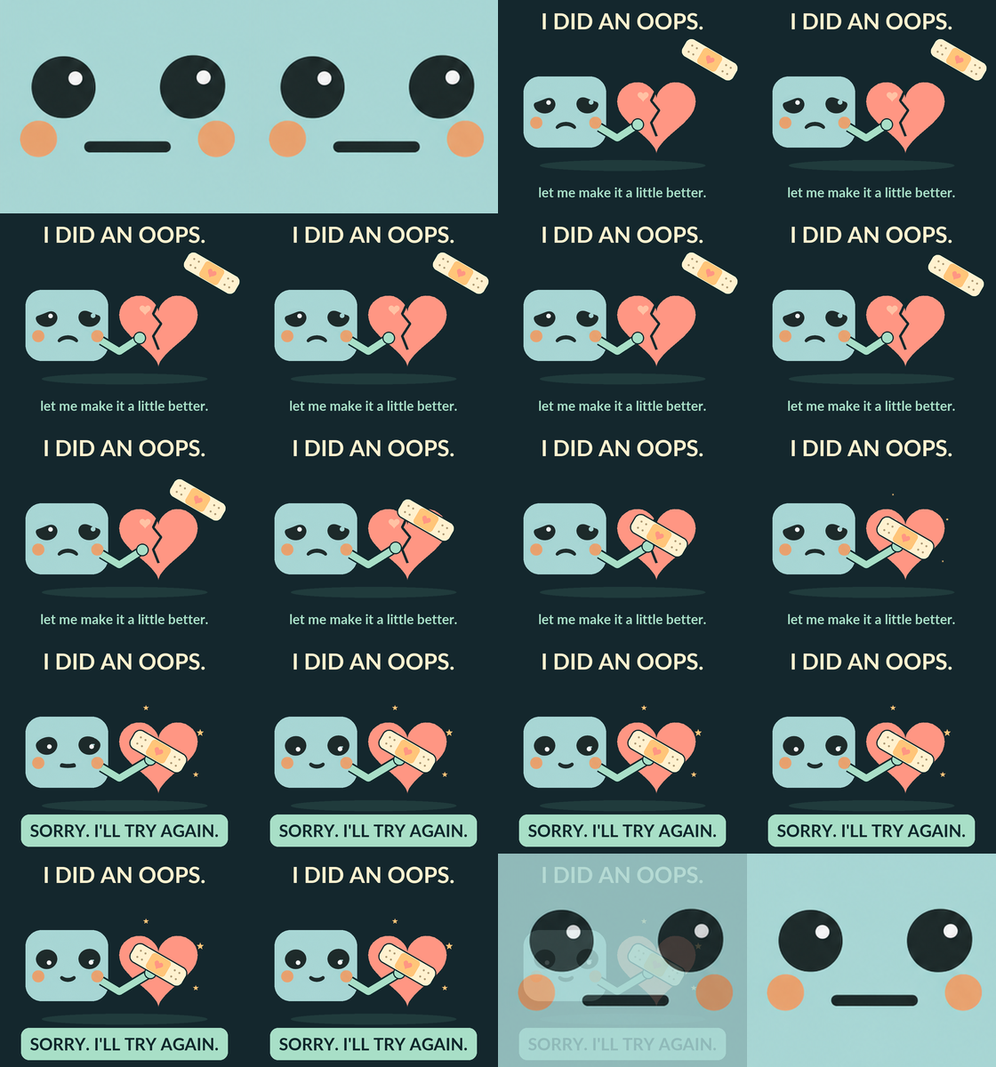
software/assets/face_animations/sweet-sorry.png
