ace-builder/Robbi/software/assets/face_animations/talking-loop.png

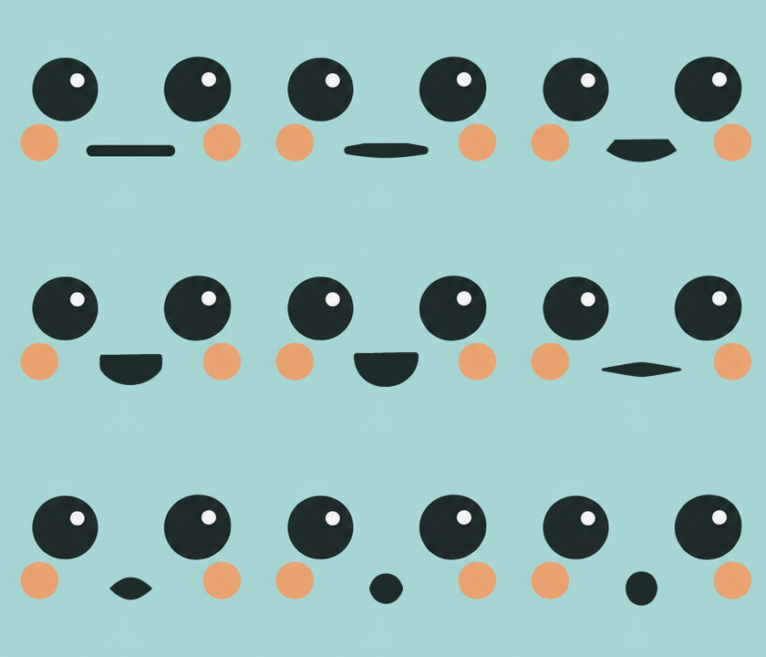
software/assets/face_animations/talking-loop.png
