ace-builder/Robbi/software/assets/face_animations/thoughtful-look.png

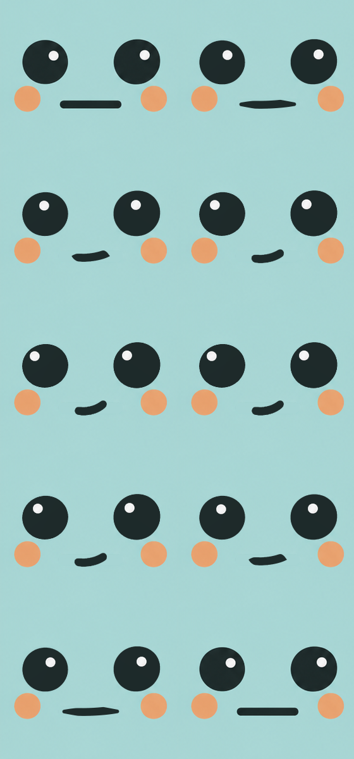
software/assets/face_animations/thoughtful-look.png
