ace-builder/Robbi/software/assets/images/faces/angry.png

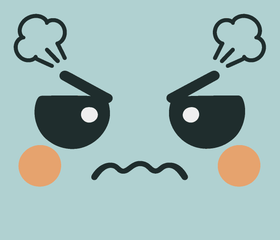
software/assets/images/faces/angry.png
