ace-builder/Robbi/software/assets/images/faces/annoyed.png

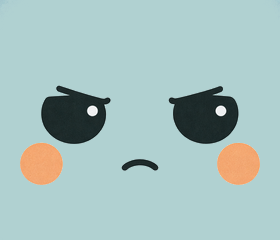
software/assets/images/faces/annoyed.png
