ace-builder/Robbi/software/assets/images/faces/aware.png

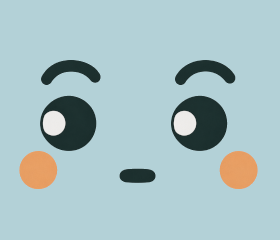
software/assets/images/faces/aware.png
