ace-builder/Robbi/software/assets/images/faces/listen.png

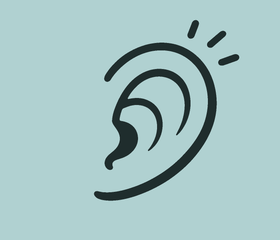
software/assets/images/faces/listen.png
