ace-builder/Robbi/software/assets/images/faces/neutral.png

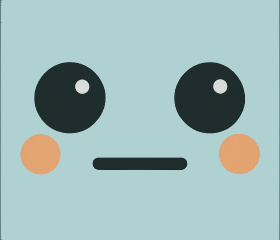
software/assets/images/faces/neutral.png
