ace-builder/Robbi/software/assets/images/faces/restarting.png

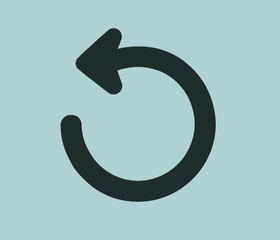
software/assets/images/faces/restarting.png
