ace-builder/Robbi/software/assets/images/faces/siren_1_.png

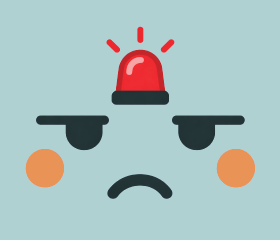
software/assets/images/faces/siren_1_.png
