ace-builder/Robbi/software/assets/images/faces/wink.png

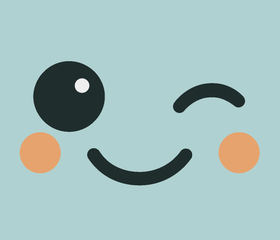
software/assets/images/faces/wink.png
