ace-builder/Robbi/software/web/motion-studio/faces/cute.png

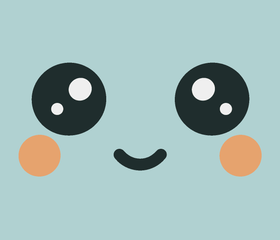
software/web/motion-studio/faces/cute.png
