ace-builder/Robbi/software/web/motion-studio/faces/error.png

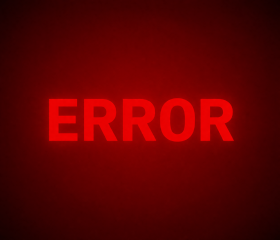
software/web/motion-studio/faces/error.png
