ace-builder/Robbi/software/web/motion-studio/faces/grumpy.png

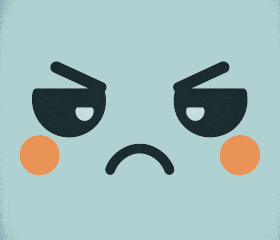
software/web/motion-studio/faces/grumpy.png
