ace-builder/Robbi/software/web/motion-studio/faces/happy.png

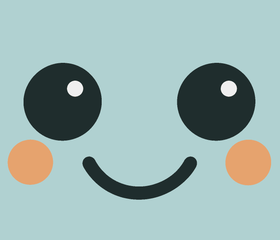
software/web/motion-studio/faces/happy.png
