ace-builder/Robbi/software/web/motion-studio/faces/joyful.png

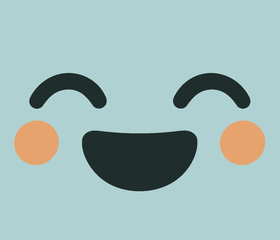
software/web/motion-studio/faces/joyful.png
