ace-builder/Robbi/software/web/motion-studio/faces/mischievous.png

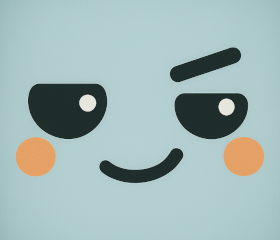
software/web/motion-studio/faces/mischievous.png
