ace-builder/Robbi/software/web/motion-studio/faces/sleepy.png

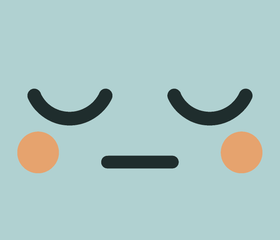
software/web/motion-studio/faces/sleepy.png
