ace-builder/Robbi/software/web/motion-studio/faces/surprised.png

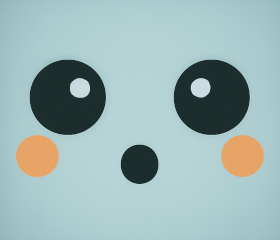
software/web/motion-studio/faces/surprised.png
