ace-builder/Robbi/software/web/motion-studio/faces/thinking.png

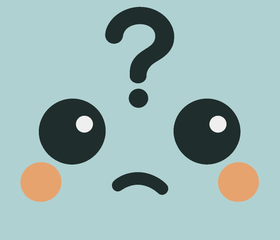
software/web/motion-studio/faces/thinking.png
