ace-builder/Robbi/build-record.csv

stage | check_or_measurement | guidance | your_result
Build identity | PCB manufacturing hash/revision
Build identity | Print release and slicer profile
Build identity | Runtime tag/commit
Build identity | OS/Python version
Parts | Motor label and encoder cable pinout
Parts | Cell model and protection
Wiring | Battery polarity verified | PASS / FAIL
Wiring | No persistent supply short | PASS / FAIL
Wiring | Right encoder B GPIO | 16 intended; 7 original repair only
Power | Power button pressed for bare-PCB test | PASS / FAIL
Power | Pi rail unloaded / loaded (V) | 5V test pin against PACK-; nominal 5 V
Power | Sensor / logic rail (V) | 3V3 test pin against PACK-; check with Pi installed
Power | Motor rail and approved duty limit
Power | Startup and loaded behaviour
Bench | Face / camera / microphone / speaker | PASS / FAIL
Bench | Forward ToF fresh and responsive | PASS / FAIL
Bench | IMU fresh and responsive | PASS / FAIL
Motion | Left / right forward direction | PASS / FAIL
Motion | A/B counts and logical signs | PASS / FAIL
Calibration | Wheel diameter including tread (cm)
Calibration | Physical / effective wheelbase (cm)
Calibration | Counts per output-wheel revolution
Calibration | 100 cm run 1: travel / sideways drift (cm)
Calibration | 100 cm run 2: travel / sideways drift (cm)
Calibration | 100 cm run 3: travel / sideways drift (cm)
Calibration | Left/right 90-degree settled error
Calibration | 180 / 360-degree settled error
Fault checks | Stop / network timeout / restart | PASS / FAIL
Fault checks | Missing or stale forward ToF | PASS / FAIL
Final | Closed-shell repeat checks | PASS / FAIL
Final | Date / builder / remaining issues
Calibration | IMU tab calibration completed | PASS / FAIL
Conversation | STT transcription | PASS / FAIL
Conversation | LLM response | PASS / FAIL
Conversation | TTS output | PASS / FAIL
Conversation | Complete spoken interaction | PASS / FAIL
