ace-builder/Robbi/build/hardware/pcb/bom_v1.csv

ID | Name | Designator | Footprint | Quantity | Manufacturer Part | Manufacturer | Supplier | Supplier Part | Price | Pins | 3DModel | Contributor | JLCPCB Part Class | link
1 | 2.54-2*20 - HAND SOLDER BACK SIDE | U6 | HDR-TH_40P-P2.54-V-F-R2-C20-S2.54 | 1 | 2.54-2*20 | ZHOURI(洲日) | LCSC | C2977589 | 0.32 | 40 | HDR-TH_40P-P2.54-F-LI-2X20P | LCSC | Extended Part | https://item.szlcsc.com/2776437.html?ref=editor&logined=true
2 | 470uF | C2 | CAP-SMD_BD6.3-L6.6-W6.6-FD | 1 | CS1A471M-CRE77 | ST(先科) | LCSC | C116423 | 0.052 | 2 | CAP-SMD_BD6.3-L6.6-W6.6-FD | lcsc | Extended Part | https://item.szlcsc.com/265679.html
3 | 10uF | C3,C4,C5,C6 | C0805 | 4 | CL21A106KAYNNNE | SAMSUNG(三星) | LCSC | C15850 | 0.086 | 2 | C0805_L2.0-W1.3-H1.3 | lcsc | Basic Part | https://item.szlcsc.com/373011.html
4 | 22uF | C7,C8,C11 | C0805 | 3 | CL21A226MAQNNNE | SAMSUNG(三星) | LCSC | C45783 | 0.252 | 2 | C0805_L2.0-W1.3-H1.3 | lcsc | Basic Part | https://item.szlcsc.com/373011.html
5 | 210S-1*6P | H1,MENCODER_L,MENCODER_R | HDR-TH_6P-P2.54-V_Z-211-0611-0021-001 | 3 | B-2100S06P-A110 | Ckmtw(灿科盟) | LCSC | C124380 | 0.057 | 6 | HDR2.54-M-LI-1X6P | LCSC | Extended Part | https://item.szlcsc.com/213064.html
6 | 210S-1*6P L=11.6MMGold-plated black | H2 | HDR-TH_6P-P2.54-V_Z-211-0611-0021-001 | 1 | B-2100S06P-A110 | Ckmtw(灿科盟) | LCSC | C124380 | 0.057 | 6 | HDR2.54-M-LI-1X6P | LCSC | Extended Part | https://item.szlcsc.com/213064.html
7 | 210S-1*2P L=11.6MMGold-plated black | H3 | HDR-TH_2P-P2.54-V-M-1 | 1 | B-2100S02P-A110 | Ckmtw(灿科盟) | LCSC | C124375 | 0.03 | 2 | HDR-M-2.54_1x2 | LCSC | Extended Part | https://item.szlcsc.com/366904.html
8 | 1uH | L2 | IND-SMD_L4.4-W4.2 | 1 | FXL0420-1R0-M | cjiang(长江微电) | LCSC | C167203 | 0.208 | 2 | IND-SMD_L4.2-W4.4-H2.0 | LCSC | Extended Part | https://item.szlcsc.com/178588.html
9 | Header-Male-2.54_1x8 | LCD | HDR-TH_8P-P2.54-V-M | 1 | B-2100S08P-A110 | Ckmtw(灿科盟) | LCSC | C124381 | 0.08 | 8 | HDR-TH_8P-P2.54-V-M | LCSC | Extended Part | https://item.szlcsc.com/502963.html
10 | 10kΩ | R1 | R0603 | 1 | 0603WAF1002T5E | UNI-ROYAL(厚声) | LCSC | C25804 | 0.004 | 2 | R0603 | lcsc | Basic Part | https://www.mouser.in/datasheet/2/447/PYu_RT_1_to_0_01_RoHS_L_11-1669912.pdf
11 | 2Ω | R2,R4 | R0603 | 2 | AC0603FR-072RL | YAGEO(国巨) | LCSC | C227804 | 0.016 | 2 | R0603 | LCSC | Extended Part | https://www.mouser.in/datasheet/2/447/PYu_RT_1_to_0_01_RoHS_L_11-1669912.pdf
12 | 5.1kΩ | R3,R6 | R0603 | 2 | 0603WAF5101T5E | UNI-ROYAL(厚声) | LCSC | C23186 | 0.002 | 2 | R0603 | lcsc | Basic Part | https://www.mouser.in/datasheet/2/447/PYu_RT_1_to_0_01_RoHS_L_11-1669912.pdf
13 | 10kΩ | R5 | R0603 | 1 | RC0603FR-0710KL | YAGEO(国巨) | LCSC | C98220 | 0.004 | 2 | R0603 | lcsc | Extended Part | https://www.mouser.in/datasheet/2/447/PYu_RT_1_to_0_01_RoHS_L_11-1669912.pdf
14 | 100kΩ | R7 | R0603 | 1 | 0603WAF1003T5E | UNI-ROYAL(厚声) | LCSC | C25803 | 0.004 | 2 | R0603 | lcsc | Basic Part | https://www.mouser.in/datasheet/2/447/PYu_RT_1_to_0_01_RoHS_L_11-1669912.pdf
15 | TS-1088-AR02016 | SW1 | SW-SMD_L3.9-W3.0-P4.45 | 1 | TS-1088-AR02016 | XUNPU(讯普) | LCSC | C720477 | 0.056 | 2 | SW-SMD_L3.9-W2.9-H2.0-LS4.8 | LCSC | Basic Part | https://item.szlcsc.com/457636.html
16 | HDR-M-2.54_1x1 | TP_I1C_SCL,TP_USB_VBUS1,TP_USB_VBUS2,TP_3V3,TP_5V,TP_I2C_SCL,TP_I2C_SDA,TP_M_L_1,TP_M_L_2,TP_M_R_1,TP_PACK+,TP_PACK-,TP_ROBOT_EN,TP_USB_DETECT,TP_USB_VBUS | HDR-M-2.54_1X1 | 15 |  |  | LCSC | C81276 | 0.013 | 1 | HDR-M-2.54_1x1 | LCEDA_Lib
17 | IP5306 | U7 | ESOP-8_L4.9-W3.9-P1.27-LS6.0-BL-EP | 1 | IP5306 | INJOINIC(英集芯) | LCSC | C181692 | 0.299 | 9 | ESOP-8_L4.9-W3.9-H1.6-LS6.0-P1.27 | LCSC | Extended Part | https://www.mornsun.cn/html/pdf/SCM1501B.html
18 | TYPE-C-31-M-12 | USBC1 | USB-C_SMD-TYPE-C-31-M-12_1 | 1 | TYPE-C-31-M-12 | 韩国韩荣 | LCSC | C165948 | 0.187 | 16 | USB-C_SMD-TYPE-C-31-M-12_1 | LCSC | Extended Part | https://item.szlcsc.com/datasheet/TYPE-C-31-M-12/177331.html
19 | Header-Male-2.54_1x3 | SERVO1,SERVO2 | HDR-TH_3P-P2.54-V-M-1 | 2 | 2.54-1*3P针 | BOOMELE(博穆精密) | LCSC | C49257 | 0.028 | 3 | HDR-M-2.54_1x3 | lcsc | Extended Part | https://item.szlcsc.com/50265.html
20 | MAX98357AETE+T | AMP | TQFN-16_L3.0-W3.0-P0.50-BL-EP1.5 | 1 | MAX98357AETE+T | ADI(亚德诺)/MAXIM(美信) | LCSC | C910544 | 1.326 | 17 | TQFN-16_L3.0-W3.0-P0.50-BL-EP1.5 | LCSC | Extended Part | https://item.szlcsc.com/533528.html
21 | B2P-VH (LF)(SN) | BAT | CONN-TH_B2P-VH-LF-SN | 1 | B2P-VH(LF)(SN) | JST | LCSC | C160315 | 0.063 | 2 | VH3.96-2A | LCSC | Extended Part | https://atta.szlcsc.com/upload/public/pdf/source/20180420/C160315_19C451141449BB9E1CAF8D49BAD03192.pdf
22 | 2.2uF | C19 | C0603 | 1 | CL10A225KO8NNNC | SAMSUNG(三星) | LCSC | C23630 | 0.019 | 2 | C0603_L1.6-W0.8-H0.8 | lcsc | Basic Part | https://item.szlcsc.com/362304.html
23 | 10uF | C20 | C0603 | 1 | CC0603MRX5R7BB106 | YAGEO(国巨) | LCSC | C109457 | 0.303 | 2 | C0603_L1.6-W0.8-H0.8 | lcsc | Extended Part | https://item.szlcsc.com/362304.html
24 | 100nF | C21,C25,C27,C28 | C0603 | 4 | CL10B104KB8NNNC | SAMSUNG(三星) | LCSC | C1591 | 0.011 | 2 | C0603_L1.6-W0.8-H0.8 | LCSC | Extended Part | https://item.szlcsc.com/362304.html
25 | 10nF | C22 | C0603 | 1 | CC0603KRX7R9BB103 | YAGEO(国巨) | LCSC | C100042 | 0.009 | 2 | C0603_L1.6-W0.8-H0.8 | lcsc | Extended Part | https://item.szlcsc.com/362304.html
26 | 10uF | C23 | C0603 | 1 | CL10A106MA8NRNC | SAMSUNG(三星) | LCSC | C96446 | 0.058 | 2 | C0603_L1.6-W0.8-H0.8 | lcsc | Basic Part | https://item.szlcsc.com/362304.html
27 | 100nF | C24 | C0805 | 1 | CL21B104KBCNNNC | SAMSUNG(三星) | LCSC | C1711 | 0.016 | 2 | C0805_L2.0-W1.3-H1.3 | lcsc | Extended Part | https://item.szlcsc.com/373011.html
28 | 470uF | C26 | CAP-SMD_BD8.0-L8.3-W8.3-LS9.3-FD-2 | 1 | RVT1C471M0810 | ROQANG(容强) | LCSC | C72517 | 0.068 | 2 | CAP-SMD_BD8.0-L8.3-W8.3-LS9.3-FD-2 | lcsc |  | https://atta.szlcsc.com/upload/public/pdf/source/20171116/C136294_15108221148061123704.pdf
29 | DRV8833PWP | MD1 | TSSOP-16_L5.0-W4.4-P0.65-LS6.4-BL-EP | 1 | DRV8833PWPR | TI(德州仪器) | LCSC | C50506 | 2.497 | 17 | TSSOP-16_L5.0-W4.4-H1.0-LS6.4-P0.65 | lcsc | Extended Part | https://item.szlcsc.com/109073.html
30 | 10kΩ | R17,R18 | R0603 | 2 | RMC 0603 10K J N | Tyohm(幸亚电阻) | LCSC | C5362358 | 0.003 | 2 | R0603 | lcsc | Extended Part | https://www.mouser.in/datasheet/2/447/PYu_RT_1_to_0_01_RoHS_L_11-1669912.pdf
31 | LSM6DS3TR-C | U4 | LGA-14_L3.0-W2.5-P0.50-TL | 1 | LSM6DS3TR-C | ST(意法半导体) | LCSC | C967633 | 1.527 | 14 | LGA-14_L2.5-W3.0-H0.9-P0.50 | LCSC | Extended Part | https://lcsc.com/product-detail/Sensors_Bosch_BMG250_BMG250_C189521.html
