ace-builder/Robbi/build/hardware/prints/2026-10-13/slicer_projects/01_Main_chassis_REFERENCE_A1_0p4.3mf

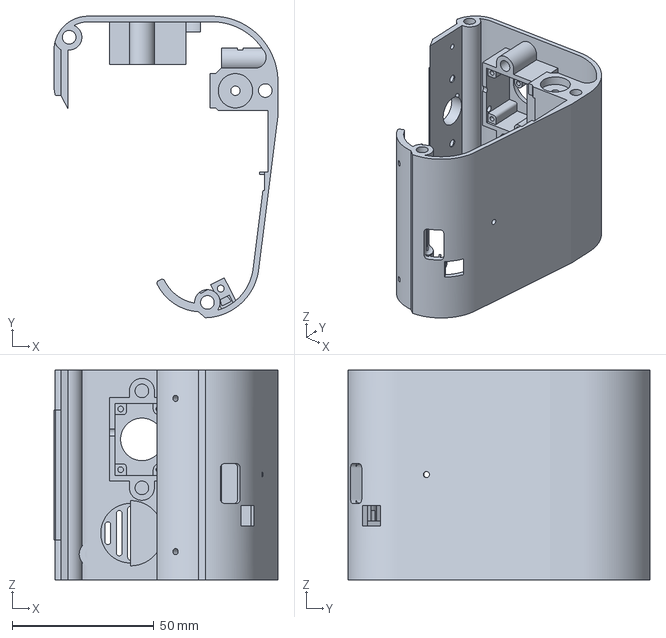
[picture p154: CAD file, 2026-11-04]
build/hardware/prints/2026-10-13/slicer_projects/01_Main_chassis_REFERENCE_A1_0p4.3mf
79.0 x 106.4 x 74.0 mm
