ace-builder/Robbi/build/hardware/prints/2026-10-13/print/Motor_retaining_clip_forward_fastener.stl

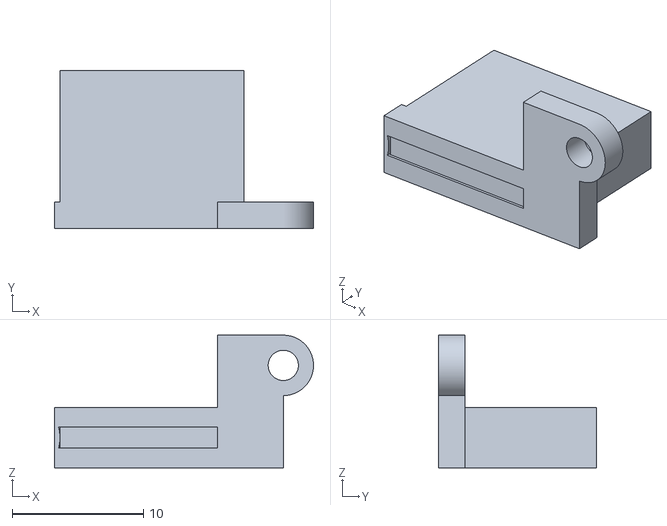
[picture p155: CAD file, 2026-11-04]
build/hardware/prints/2026-10-13/print/Motor_retaining_clip_forward_fastener.stl
19.7 x 12.0 x 10.1
