ace-builder/Robbi/build/hardware/prints/2026-10-13/slicer_projects/03_Both_side_panels_REFERENCE_A1_0p4.3mf

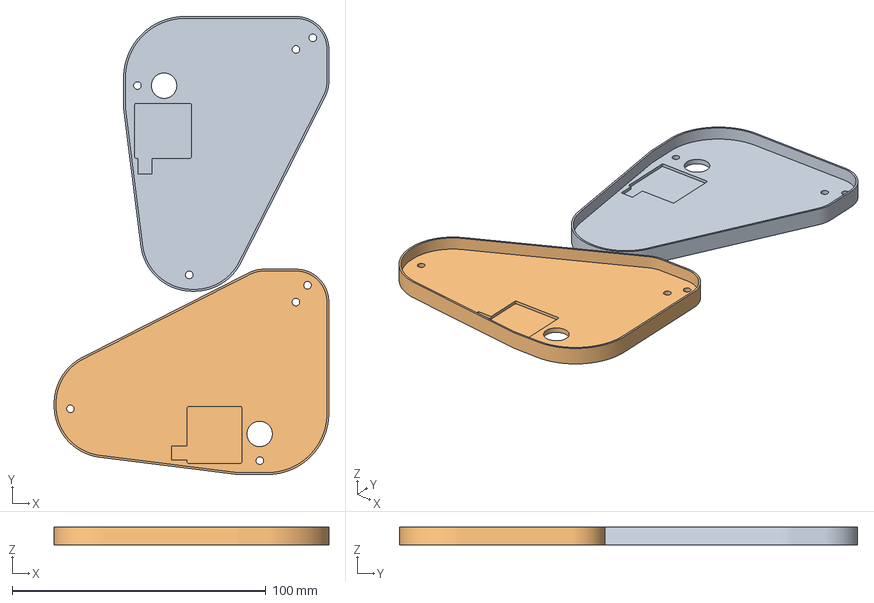
[picture p156: CAD file, 2026-11-04]
build/hardware/prints/2026-10-13/slicer_projects/03_Both_side_panels_REFERENCE_A1_0p4.3mf
108.4 x 180.6 x 7.00 mm
Sidepanel_right_GPIO_side.stl
Sidepanel_left_battery_side.stl
