ace-builder/Robbi/software/web/motion-studio/models/robbi-body.stl

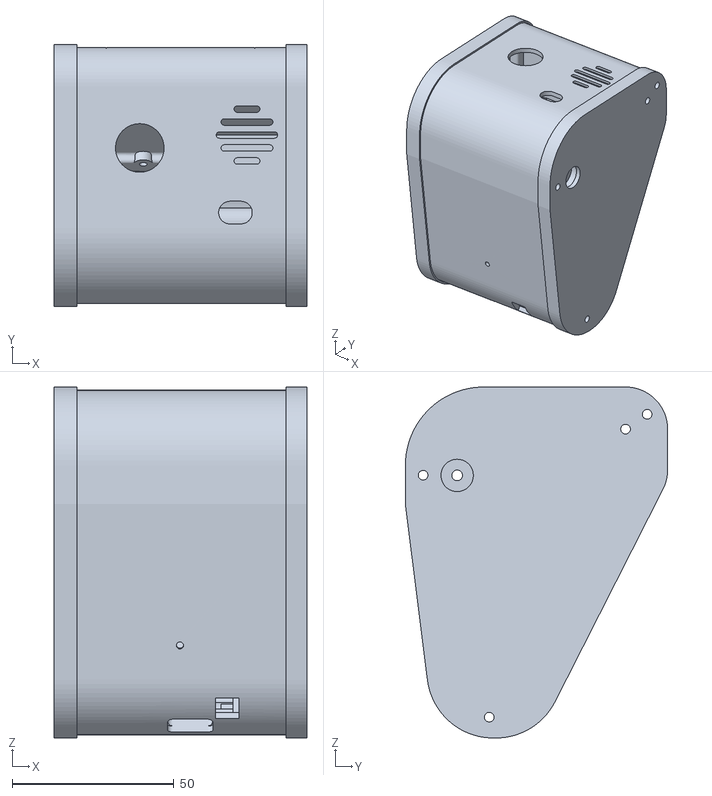
[picture p157: CAD file, 2026-11-04]
software/web/motion-studio/models/robbi-body.stl
78.0 x 81.0 x 108.4
