ace-builder/Robbi/build/hardware/prints/2026-10-13/print/Fixed_head_rear_service_cover.stl

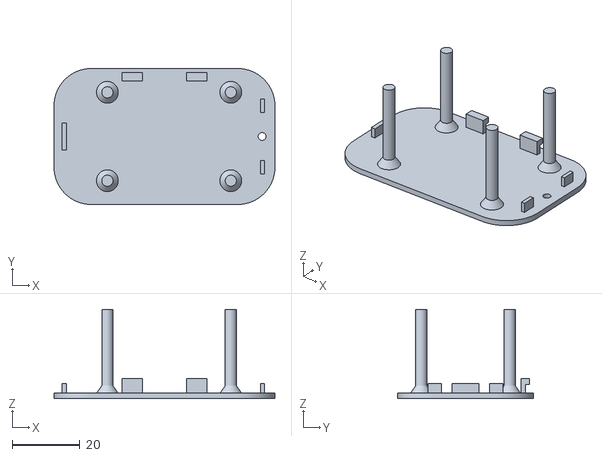
[picture p158: CAD file, 2026-11-04]
build/hardware/prints/2026-10-13/print/Fixed_head_rear_service_cover.stl
65.0 x 40.0 x 26.2
