ace-builder/Robbi/build/hardware/prints/2026-10-13/slicer_projects/04_Four_stack_spacers_REFERENCE_A1_0p4.3mf

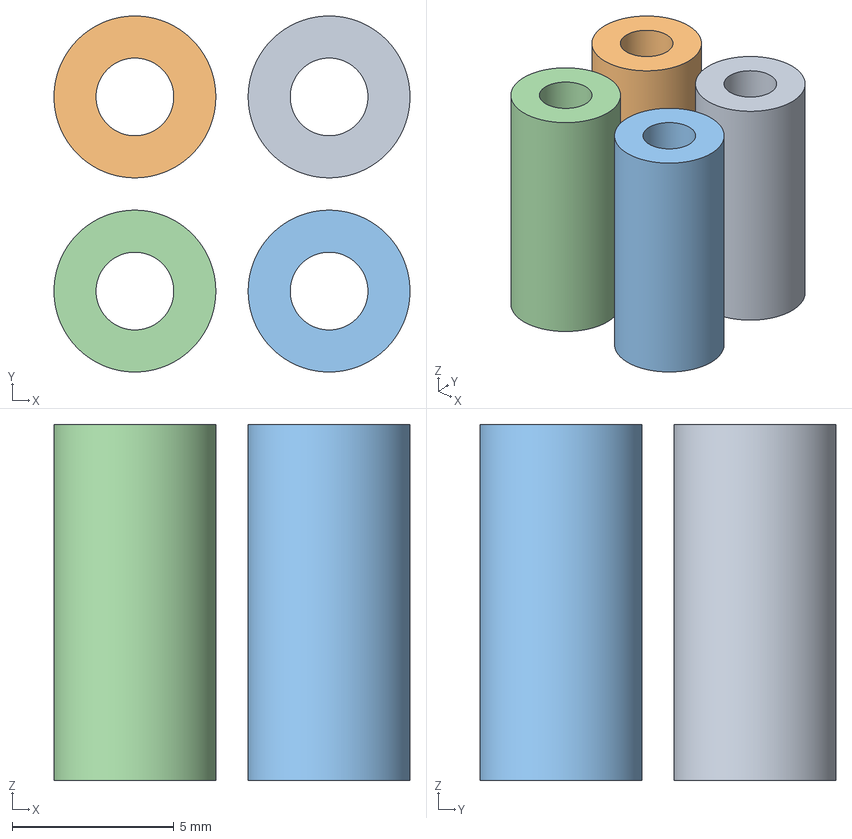
[picture p159: CAD file, 2026-11-04]
build/hardware/prints/2026-10-13/slicer_projects/04_Four_stack_spacers_REFERENCE_A1_0p4.3mf
11.0 x 11.0 x 11.0 mm
Stack_spacer_11mm_PRINT_4.stl_1
Stack_spacer_11mm_PRINT_4.stl_2
Stack_spacer_11mm_PRINT_4.stl_3
Stack_spacer_11mm_PRINT_4.stl_4
