ace-builder/Robbi/software/web/motion-studio/models/robbi-head.stl

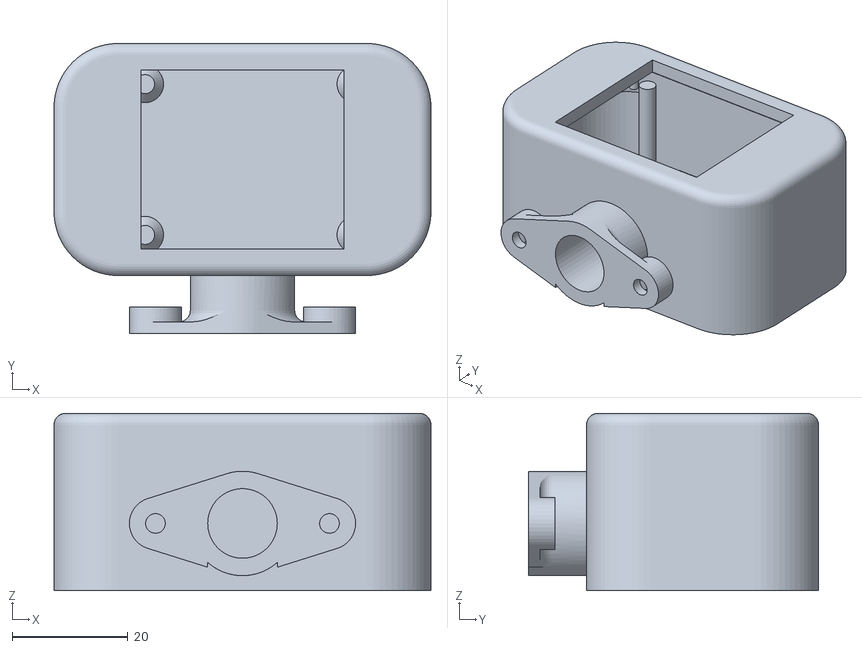
[picture p160: CAD file, 2026-11-04]
software/web/motion-studio/models/robbi-head.stl
65.0 x 50.0 x 30.6
