ace-builder/Robbi/build/hardware/prints/2026-10-13/print/Power_button_pivot_pin_print.stl

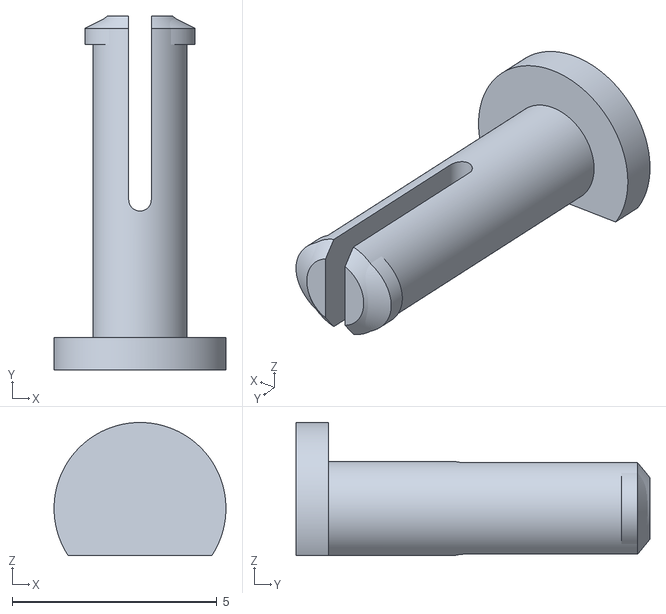
[picture p161: CAD file, 2026-11-04]
build/hardware/prints/2026-10-13/print/Power_button_pivot_pin_print.stl
4.20 x 8.65 x 3.25
