ace-builder/Robbi/build/hardware/prints/2026-10-13/slicer_projects/06_Power_button_rocker_REFERENCE_A1_0p4.3mf

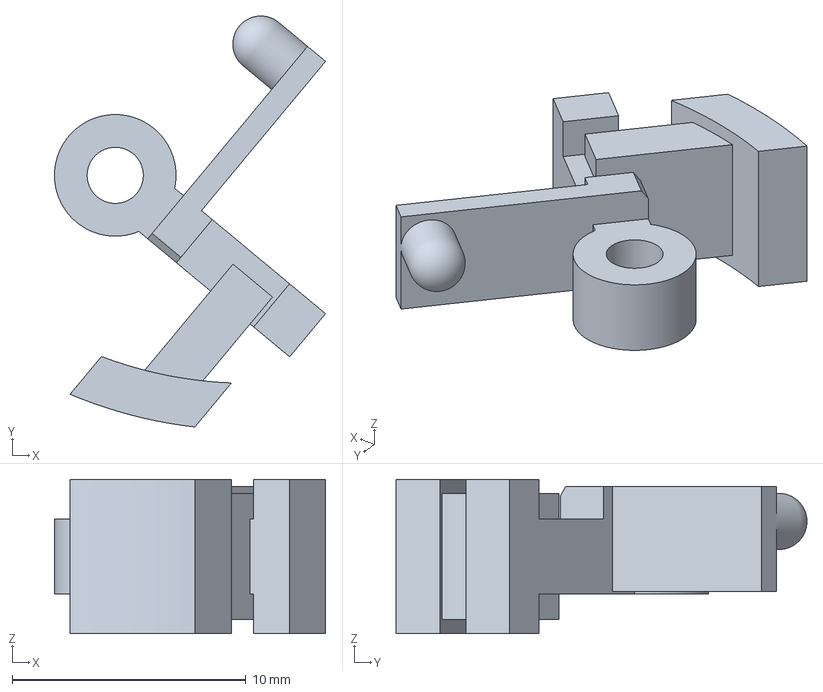
[picture p162: CAD file, 2026-11-04]
build/hardware/prints/2026-10-13/slicer_projects/06_Power_button_rocker_REFERENCE_A1_0p4.3mf
11.6 x 17.6 x 6.60 mm
