ace-builder/Robbi/build/hardware/prints/2026-10-13/print/OPTIONAL_rocker_longer_contact_0p10_print.stl

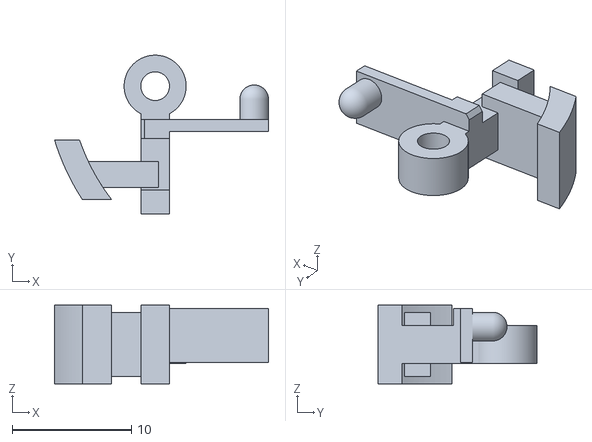
[picture p163: CAD file, 2026-11-04]
build/hardware/prints/2026-10-13/print/OPTIONAL_rocker_longer_contact_0p10_print.stl
17.9 x 13.3 x 6.60
