ace-builder/Robbi/build/hardware/prints/2026-10-13/print/TEST_ONLY_ToF_seat_coupon_PRINT.stl

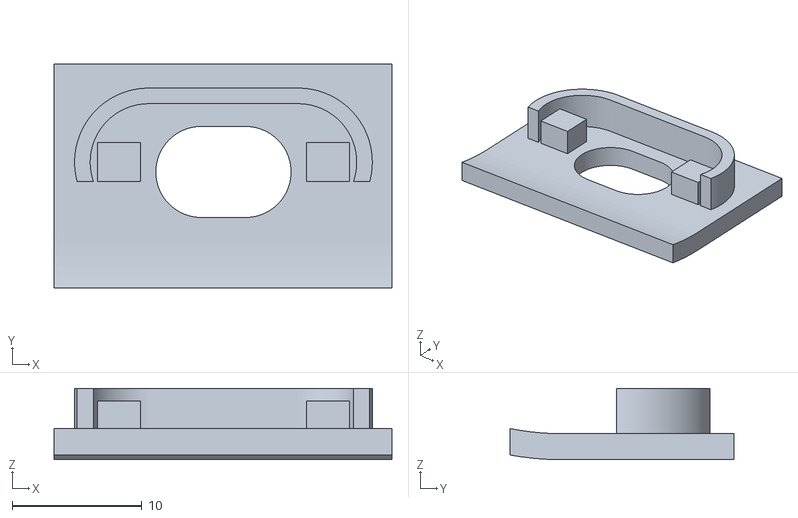
[picture p164: CAD file, 2026-11-04]
build/hardware/prints/2026-10-13/print/TEST_ONLY_ToF_seat_coupon_PRINT.stl
26.0 x 17.2 x 5.50
