ace-builder/Robbi/build/hardware/prints/2026-10-13/print/Power_button_keeper_print.stl

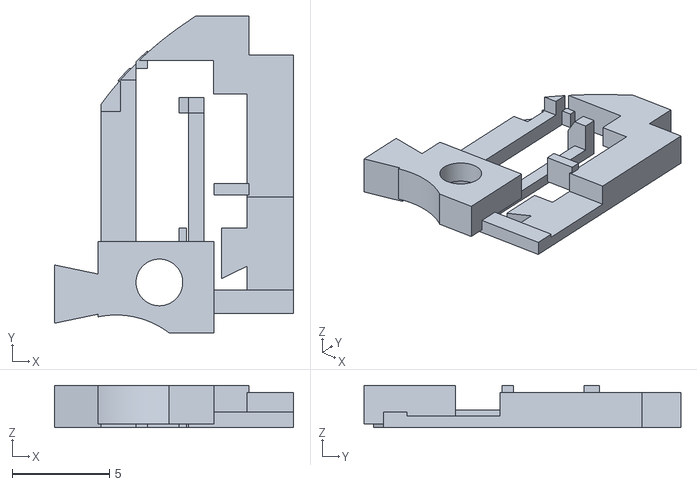
[picture p165: CAD file, 2026-11-04]
build/hardware/prints/2026-10-13/print/Power_button_keeper_print.stl
12.3 x 16.3 x 2.18
