ace-builder/Robbi/build/hardware/prints/2026-10-13/print/Sidepanel_left_battery_side.stl

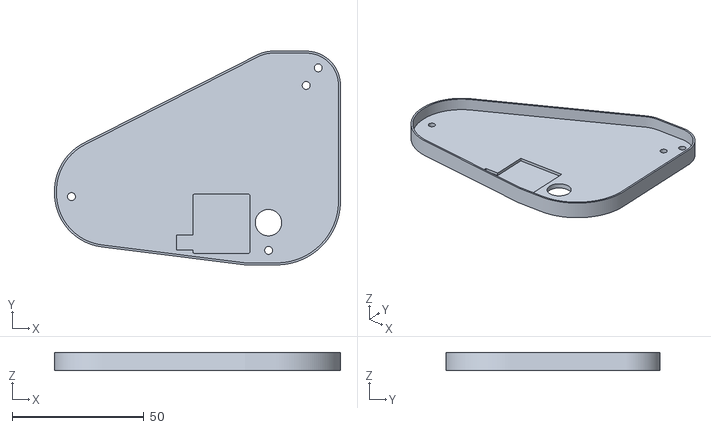
[picture p166: CAD file, 2026-11-04]
build/hardware/prints/2026-10-13/print/Sidepanel_left_battery_side.stl
108.4 x 81.0 x 7.00
