ace-builder/Robbi/build/hardware/prints/2026-10-13/slicer_projects/05_TEST_ONLY_fit_coupon_REFERENCE_A1_0p4.3mf

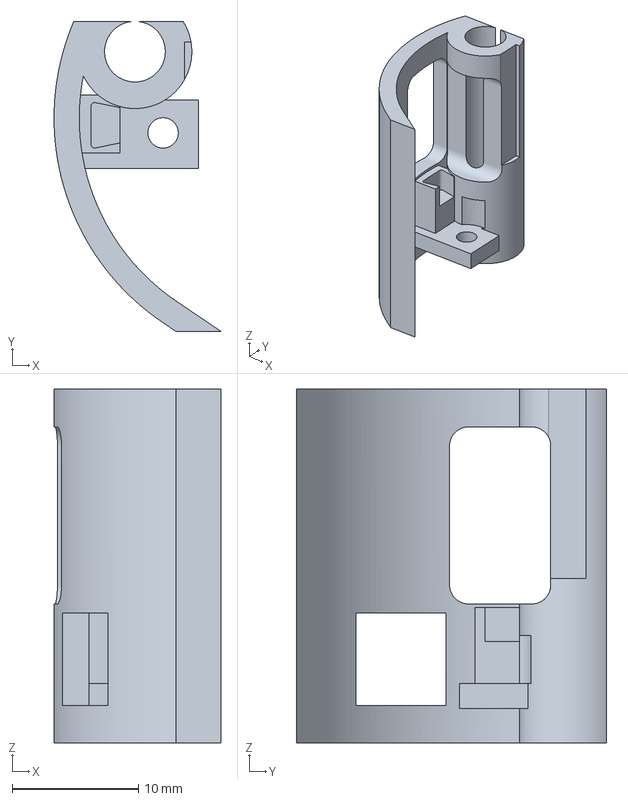
[picture p167: CAD file, 2026-11-04]
build/hardware/prints/2026-10-13/slicer_projects/05_TEST_ONLY_fit_coupon_REFERENCE_A1_0p4.3mf
13.2 x 24.5 x 28.0 mm
