ace-builder/Robbi/build/hardware/prints/2026-10-13/print/Fixed_head_carrier_with_neck.stl

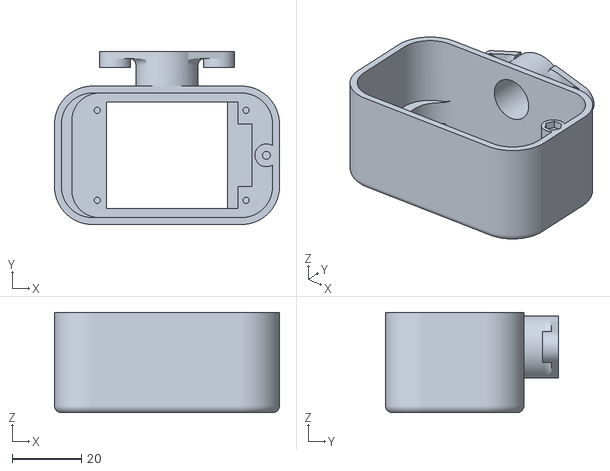
[picture p168: CAD file, 2026-11-04]
build/hardware/prints/2026-10-13/print/Fixed_head_carrier_with_neck.stl
65.0 x 50.0 x 29.0
