ace-builder/Robbi/build/hardware/prints/2026-10-13/slicer_projects/07_Power_button_keeper_and_pin_REFERENCE_A1_0p4.3mf

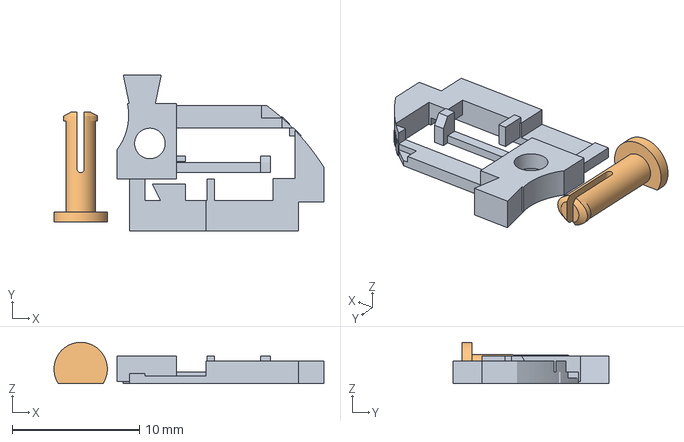
[picture p169: CAD file, 2026-11-04]
build/hardware/prints/2026-10-13/slicer_projects/07_Power_button_keeper_and_pin_REFERENCE_A1_0p4.3mf
21.2 x 12.3 x 3.25 mm
Power_button_keeper_print.stl
Power_button_pivot_pin_print.stl
