ace-builder/Robbi/build/hardware/prints/2026-10-13/slicer_projects/02_Rear_cover_REFERENCE_A1_0p4.3mf

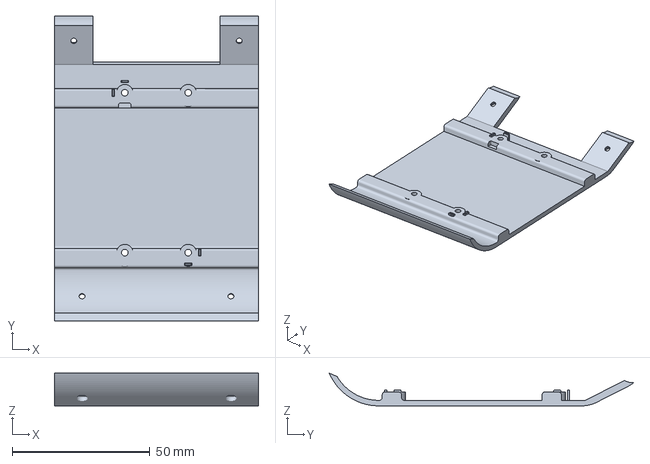
[picture p170: CAD file, 2026-11-04]
build/hardware/prints/2026-10-13/slicer_projects/02_Rear_cover_REFERENCE_A1_0p4.3mf
74.0 x 110.5 x 11.9 mm
