ace-builder/Robbi/build/hardware/prints/2026-10-13/print/Stack_spacer_11mm_PRINT_4.stl

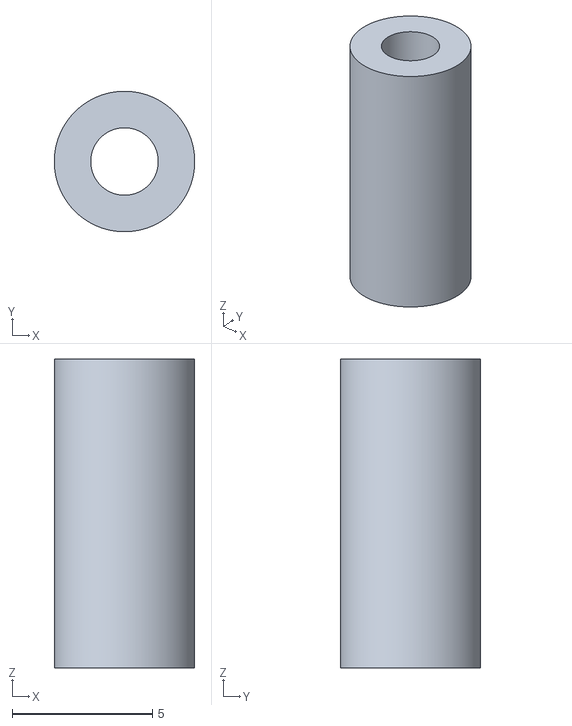
[picture p171: CAD file, 2026-11-04]
build/hardware/prints/2026-10-13/print/Stack_spacer_11mm_PRINT_4.stl
5.00 x 5.00 x 11.0
