ace-builder/Robbi/(list of files, cad)

Other CAD files:
build/hardware/prints/2026-10-13/print/Main_chassis_USB_and_button.stl
build/hardware/prints/2026-10-13/slicer_projects/11_Motor_retaining_clip_REFERENCE_A1_0p4.3mf
build/hardware/prints/2026-10-13/slicer_projects/09_Fixed_head_rear_cover_REFERENCE_A1_0p4.3mf
build/hardware/prints/2026-10-13/print/TEST_ONLY_button_USB_fit_coupon_print.stl
build/hardware/prints/2026-10-13/slicer_projects/10_TEST_ONLY_ToF_seat_coupon_REFERENCE_A1_0p4.3mf
build/hardware/prints/2026-10-13/slicer_projects/08_Fixed_head_carrier_REFERENCE_A1_0p4.3mf
build/hardware/prints/2026-10-13/print/Power_button_rocker_print.stl
build/hardware/prints/2026-10-13/print/OPTIONAL_rocker_shorter_contact_0p10_print.stl
build/hardware/prints/2026-10-13/print/Sidepanel_right_GPIO_side.stl
build/hardware/prints/2026-10-13/print/Rear_electronics_cover.stl
