ace-builder/Robbi/robbi v0_1 wiring diagram.pdf

# Robbi V0.1 Wiring Diagram - ACE Builder (https://www.youtube.com/@acebuilder-diy)

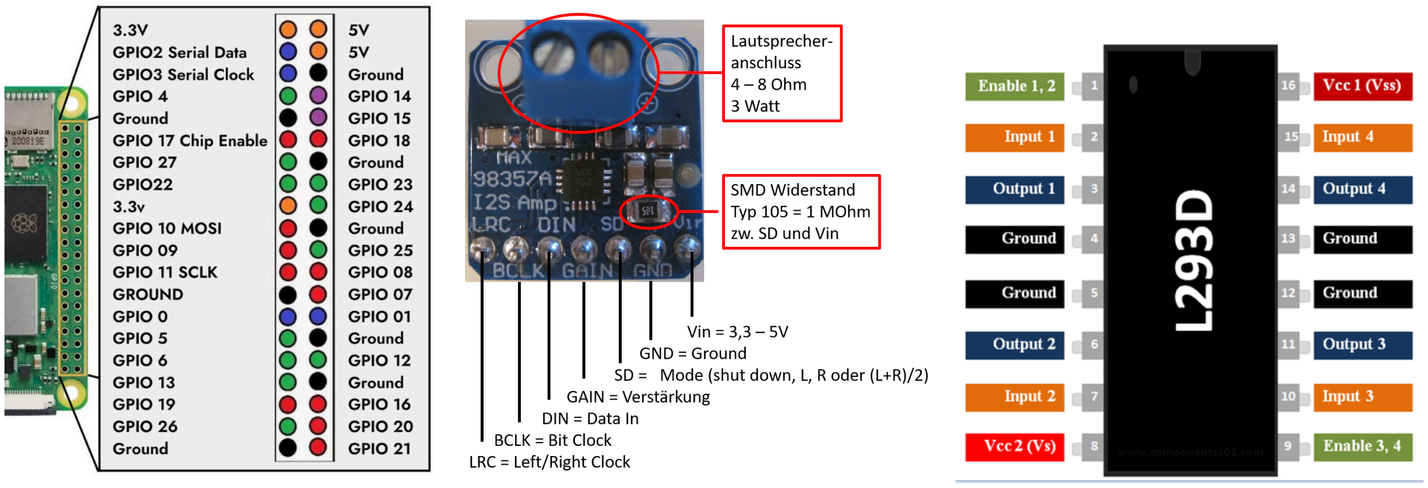
[picture p203: figure]

USB Mic connected via USB.

Pin | Signal | Connected to | Pin | Signal | Connected to
1 | 3V3 | LCD VCC & Max98357A SD | 2 | 5V | L293D VCC₁ & VCC₂ (logic & motor power)
3 | GPIO2 | NC | 4 | 5V | Max98357A VIN
5 | GPIO3 | NC | 6 | GND | Common ground (all modules) MAX98357A GAIN
7 | GPIO4 | Motor 1 IN₂ (L293D) | 8 | GPIO14 | NC
9 | GND | Common ground | 10 | GPIO15 | NC
11 | GPIO17 | Motor 1 IN₁ (L293D) | 12 | GPIO18 | Max98357A BCLK (I²S bit-clock)
13 | GPIO27 | NC | 14 | GND | Common ground
15 | GPIO22 | Motor 2 IN₁ (L293D) | 16 | GPIO23 | Motor 2 IN₂ (L293D)
17 | 3V3 | LCD BLK (backlight) | 18 | GPIO24 | LCD RES (reset)
19 | GPIO10 | LCD SDA (SPI MOSI) | 20 | GND | Common ground
21 | GPIO9 | NC | 22 | GPIO25 | LCD DC (data/command)
23 | GPIO11 | LCD SCL (SPI SCLK) | 24 | GPIO8 | LCD CS (SPI CE0)
25 | GND | Common ground | 26 | GPIO7 | NC
27 | GPIO0 | NC | 28 | GPIO1 | NC
29 | GPIO5 | NC | 30 | GND | Common ground
31 | GPIO6 | NC | 32 | GPIO12 | Motor 1 ENABLE (L293D PWM)
33 | GPIO13 | Motor 2 ENABLE (L293D PWM) | 34 | GND | Common ground
35 | GPIO19 | Max98357A LRC (I²S LRCLK) | 36 | GPIO16 | NC
37 | GPIO26 | NC | 38 | GPIO20 | NC
39 | GND | Common ground | 40 | GPIO21 | Max98357A DIN (I²S data-out)
