ace-builder/Robbi/software/assets/face_animations/meme-problem-compost.png

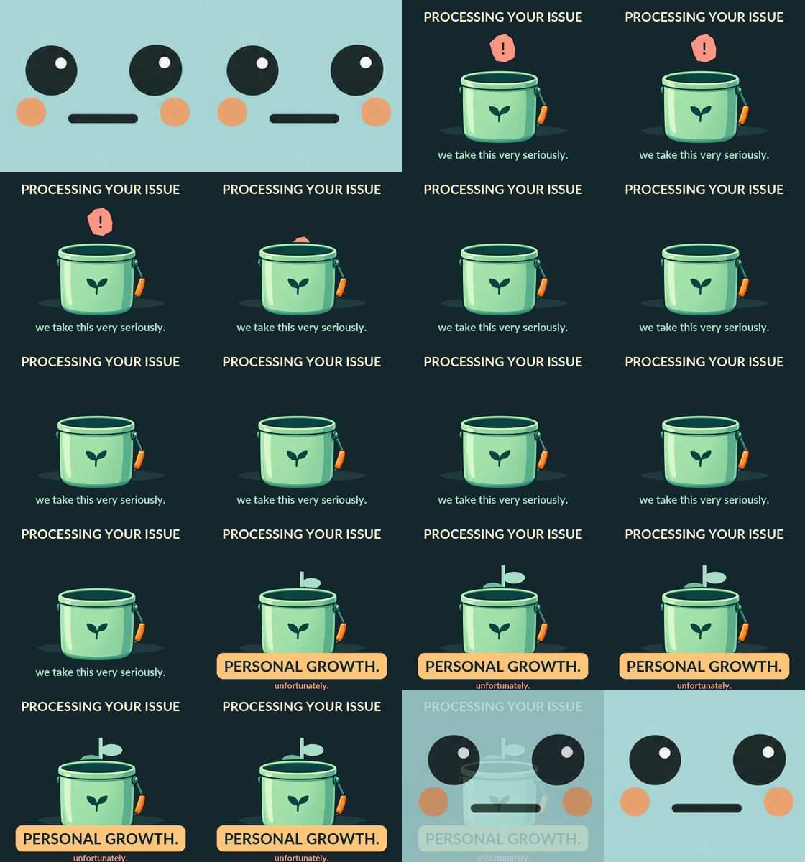
software/assets/face_animations/meme-problem-compost.png
