ace-builder/Robbi/build/hardware/pcb/schematic_v1.pdf

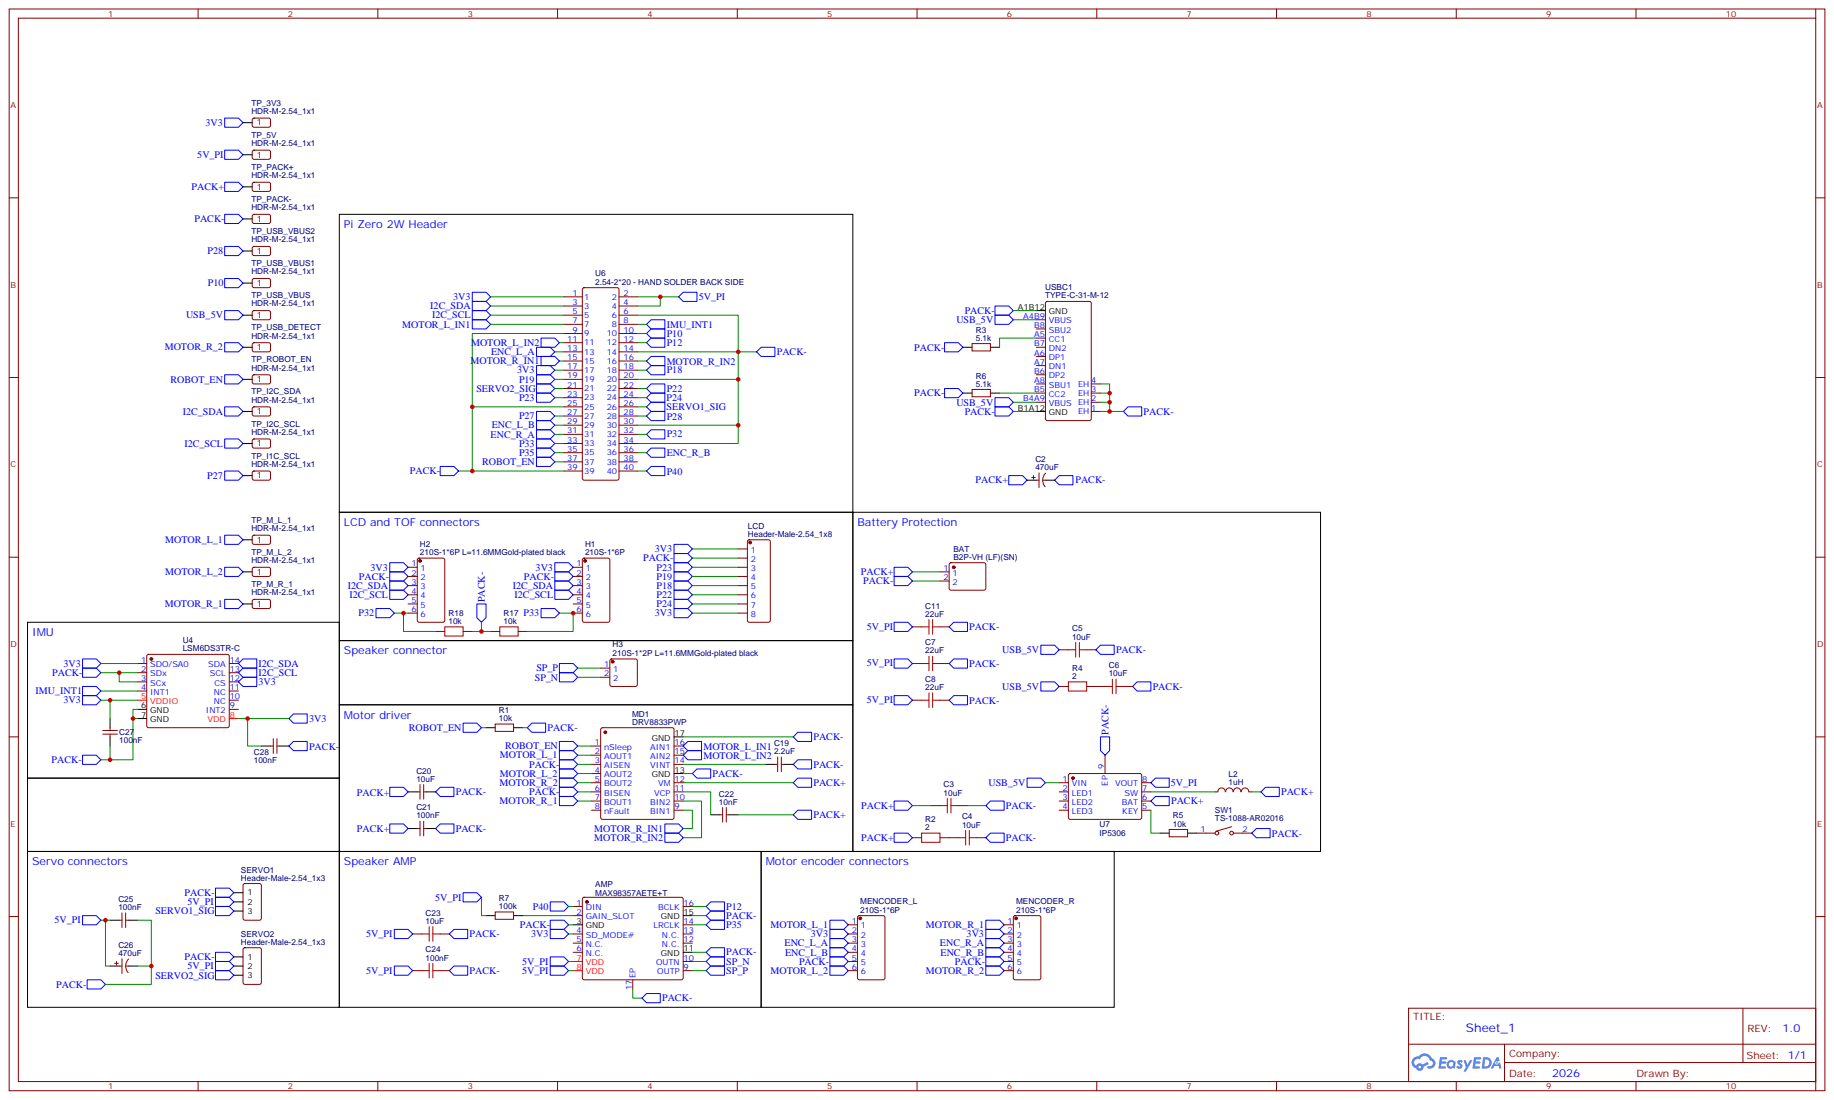
[picture p205: page 1]

LCD and TOF connectors

OUTN 10 GND 11 N.C. 12 N.C. 13 LRCLK 14 GND 15 BCLK 16
