ace-builder/Robbi/(list of files, drawings)

Other design files:
build/hardware/pcb/schematic-verification.json
build/hardware/pcb/schematic_v1.easyeda.json
