ace-builder/Robbi/software/src/robbi/configuration/view.py

"""Dashboard presentation; no configuration loading or hardware imports."""

from .schema import NUMERIC_FIELDS
from .autonomy import group_values

_MODEL_SUGGESTIONS = {
    "openai": [
        "gpt-6-luna",
        "gpt-5.6-luna",
        "gpt-5.6-terra",
        "gpt-5.6-sol",
        "gpt-5.4-mini",
        "gpt-5.4-nano",
    ],
    "alibaba": [
        "qwen3.5-plus",
        "glm-5",
        "kimi-k2.5",
        "MiniMax-M2.5",
    ],
    "local": [
        "qwen3.5-9b",
        "qwen3.5-14b",
        "qwen3.5-32b",
        "gemma-3-12b-it",
        "gemma-4-27b-it",
    ],
    "gemini": [
        "gemma-4-26b-a4b-it",
        "gemma-4-31b-it",
    ],
    "openrouter": [
        "qwen/qwen3.5-9b",
        "qwen/qwen3.5-flash-02-23",
        "qwen/qwen3.5-27b",
        "qwen/qwen3.5-35b-a3b",
        "deepseek/deepseek-v4.1-flash",
        "deepseek/deepseek-v4-flash",
        "deepseek/deepseek-v4-pro",
        "google/gemma-4-31b-it",
        "google/gemma-4-26b-a4b-it",
    ],
}


def snapshot(settings, config_file, secrets_file) -> dict:
    return {
        "constraints": NUMERIC_FIELDS,
        "paths": {
            "config": str(config_file),
            "secrets": str(secrets_file),
        },
        "values": {
            "app_hub": {"url": settings.app_hub_url},
            "background_work": group_values(settings, "background_work"),
            "day_cycle": group_values(settings, "day_cycle"),
            "network": {
                "request_timeout_s": settings.network_request_timeout_s,
                "connect_timeout_s": settings.network_connect_timeout_s,
                "cooldown_s": settings.network_cooldown_s,
                "max_cooldown_s": settings.network_max_cooldown_s,
            },
            "llm": {
                "sarcasm_level": settings.sarcasm_level,
                "ui_text_provider": settings.ui_text_provider,
                "ui_text_model": settings.ui_text_model,
                "speech_input_provider": settings.speech_input_provider,
                "speech_input_model": settings.speech_input_model,
            },
            "stt": {
                "provider": settings.stt_provider,
                "model": settings.stt_model,
                "language": settings.stt_language,
            },
            "tts": {
                "provider": settings.tts_provider,
                "model": settings.tts_model,
                "voice": settings.tts_voice,
                "elevenlabs_model": settings.elevenlabs_model,
                "elevenlabs_voice_id": settings.elevenlabs_voice_id,
            },
            "providers": {
                "openrouter": {"reasoning_effort": settings.openrouter_reasoning_effort},
                "local": {
                    "llm_base_url": settings.local_llm_base_url,
                    "stt_base_url": settings.local_stt_base_url,
                    "tts_base_url": settings.local_tts_base_url,
                },
            },
            "memory": {
                "recent_context_messages": settings.recent_context_messages,
                "extraction_enabled": settings.memory_extraction_enabled,
                "export_markdown_enabled": settings.memory_export_markdown_enabled,
            },
            "events": {
                "enabled": settings.events_enabled,
                "max_queue_size": settings.events_max_queue_size,
            },
            "autonomy": {
                **group_values(settings, "autonomy"),
                "enabled": settings.autonomy_enabled,
                "level": settings.autonomy_level,
                "min_interval_s": settings.autonomy_min_interval_s,
                "max_interval_s": settings.autonomy_max_interval_s,
                "cooldown_after_user_s": settings.autonomy_cooldown_after_user_s,
                "allow_vision": settings.autonomy_allow_vision,
                "allow_web_search": settings.autonomy_allow_web_search,
            },
            "daily_loop": {
                "enabled": settings.daily_loop_enabled,
                "mode": settings.daily_loop_mode,
                "max_proactive_per_day": settings.daily_loop_max_proactive_per_day,
                "min_interval_s": settings.daily_loop_min_interval_s,
                "todo_followup_enabled": settings.daily_loop_todo_followup_enabled,
                "memory_review_nudge_enabled": settings.daily_loop_memory_review_nudge_enabled,
                "telegram_brief_enabled": settings.daily_loop_telegram_brief_enabled,
            },
            "conversation": {
                "followup_enabled": settings.conversation_followup_enabled,
                "followup_timeout_s": settings.conversation_followup_timeout_s,
                "max_turns": settings.conversation_max_turns,
                "end_phrases": settings.conversation_end_phrases,
            },
            "web_search": {
                "provider": settings.web_search_provider,
                "search_depth": settings.web_search_search_depth,
                "max_results": settings.web_search_max_results,
                "configured": bool(settings.tavily_api_key),
            },
            "ui": {
                "debug_mode": settings.ui_debug_mode,
            },
            "telegram": {
                "enabled": settings.telegram_enabled,
                "configured": bool(settings.telegram_bot_token),
                "allowed_chat_ids": settings.telegram_allowed_chat_ids,
                "poll_interval_s": settings.telegram_poll_interval_s,
                "notify_reminders": settings.telegram_notify_reminders,
                "notify_proactive": settings.telegram_notify_proactive,
                "allow_commands": settings.telegram_allow_commands,
                "allow_photos": settings.telegram_allow_photos,
                "allow_voice": settings.telegram_allow_voice,
                "send_audio_replies": settings.telegram_send_audio_replies,
                "allow_robot_actions": settings.telegram_allow_robot_actions,
                "speak_remote_messages": settings.telegram_speak_remote_messages,
            },
            "voice": {
                "wake_engine": settings.voice_wake_engine,
                "local_wake_threshold": settings.voice_local_wake_threshold,
                "local_wake_max_references": settings.voice_local_wake_max_references,
                "local_wake_max_reference_s": settings.voice_local_wake_max_reference_s,
                "local_wake_max_reference_bytes": settings.voice_local_wake_max_reference_bytes,
                "local_wake_max_total_feature_frames": settings.voice_local_wake_max_total_feature_frames,
                "silence_ms": settings.voice_silence_ms,
                "command_start_chunks": settings.voice_command_start_chunks,
                "command_silence_ms": settings.voice_command_silence_ms,
                "command_max_s": settings.voice_command_max_s,
                "min_command_speech_chunks": settings.voice_min_command_speech_chunks,
                "command_wait_s": settings.voice_command_wait_s,
                "ready_tone_block_s": settings.voice_ready_tone_block_s,
                "nanowake_threshold": settings.voice_nanowake_threshold,
                "nanowake_patience": settings.voice_nanowake_patience,
            },
            "motion": {
                "encoder_enabled": settings.motion_encoder_enabled,
                "default_step_cm": settings.motion_default_step_cm,
                "default_turn_deg": settings.motion_default_turn_deg,
                "wheel_diameter_cm": settings.motion_wheel_diameter_cm,
                "wheel_base_cm": settings.motion_wheel_base_cm,
                "encoder_counts_per_rev": settings.motion_encoder_counts_per_rev,
                "encoder_tolerance_counts": settings.motion_encoder_tolerance_counts,
                "turn_max_duty": settings.motion_turn_max_duty,
                "turn_start_duty": settings.motion_turn_start_duty,
                "turn_tolerance_counts": settings.motion_turn_tolerance_counts,
                "imu_heading_enabled": settings.motion_imu_heading_enabled,
                "imu_gyro_weight": settings.motion_imu_gyro_weight,
                "imu_turn_tolerance_deg": settings.motion_imu_turn_tolerance_deg,
                "pwm_max_duty": settings.motion_pwm_max_duty,
                "pwm_min_duty": settings.motion_pwm_min_duty,
                "pwm_ramp_min": settings.motion_pwm_ramp_min,
                "sync_kp": settings.motion_sync_kp,
                "curve_pwm_slew_per_s": settings.motion_curve_pwm_slew_per_s,
                "curve_trim_gain": settings.motion_curve_trim_gain,
                "curve_start_assist": settings.motion_curve_start_assist,
                "curve_cross_track_gain": settings.motion_curve_cross_track_gain,
                "pid_kp": settings.motion_pid_kp,
                "pid_ki": settings.motion_pid_ki,
                "pid_kd": settings.motion_pid_kd,
                "pid_integral_limit": settings.motion_pid_integral_limit,
                "stop_margin_per_duty": settings.motion_stop_margin_per_duty,
                "stop_margin_ratio": settings.motion_stop_margin_ratio,
                "control_interval_s": settings.motion_control_interval_s,
                "encoder_timeout_s": settings.motion_encoder_timeout_s,
                "stall_timeout_s": settings.motion_stall_timeout_s,
                "brake_s": settings.motion_brake_s,
                "swap_motor_outputs": settings.motion_swap_motor_outputs,
                "swap_encoder_inputs": settings.motion_swap_encoder_inputs,
                "obstacle_stop_enabled": settings.motion_obstacle_stop_enabled,
                "obstacle_stop_cm": settings.motion_obstacle_stop_cm,
                "arc_radius_cm": settings.motion_arc_radius_cm,
                "sine_radius_cm": settings.motion_sine_radius_cm,
                "sine_angle_deg": settings.motion_sine_angle_deg,
                "wiggle_angle_deg": settings.motion_wiggle_angle_deg,
                "avoid_backoff_cm": settings.motion_avoid_backoff_cm,
                "avoid_turn_deg": settings.motion_avoid_turn_deg,
                "left_motor_invert": settings.motion_left_motor_invert,
                "right_motor_invert": settings.motion_right_motor_invert,
                "encoder_left_invert": settings.motion_encoder_left_invert,
                "encoder_right_invert": settings.motion_encoder_right_invert,
            },
            "imu": {"enabled": settings.imu_enabled, "poll_hz": settings.imu_poll_hz},
            "tof": {
                "enabled": settings.tof_enabled,
                "h2_enabled": settings.tof_h2_enabled,
                "poll_hz": settings.tof_poll_hz,
                "distance_mode": settings.tof_distance_mode,
                "timing_budget_ms": settings.tof_timing_budget_ms,
                "intermeasurement_ms": settings.tof_intermeasurement_ms,
                "roi_size": settings.tof_roi_size,
                "max_age_s": settings.tof_max_age_s,
            },
            "slam": {
                "enabled": settings.slam_enabled,
                "grid_resolution_cm": settings.slam_grid_resolution_cm,
                "scan_step_deg": settings.slam_scan_step_deg,
                "samples_per_angle": settings.slam_samples_per_angle,
                "max_range_cm": settings.slam_max_range_cm,
                "min_range_cm": settings.slam_min_range_cm,
                "explore_step_cm": settings.slam_explore_step_cm,
                "max_explore_steps": settings.slam_max_explore_steps,
                "min_pose_confidence": settings.slam_min_pose_confidence,
                "scan_match_enabled": settings.slam_scan_match_enabled,
                "turn_speed": settings.slam_turn_speed,
                "drive_speed": settings.slam_drive_speed,
                "sample_settle_s": settings.slam_sample_settle_s,
                "scan_mode": settings.slam_scan_mode,
                "continuous_scan_hz": settings.slam_continuous_scan_hz,
                "continuous_turn_speed": settings.slam_continuous_turn_speed,
                "continuous_scan_timeout_s": settings.slam_continuous_scan_timeout_s,
                "min_scan_samples": settings.slam_min_scan_samples,
            },
            "heartbeat": {
                "enabled": settings.heartbeat_enabled,
                "initial_delay_s": settings.heartbeat_initial_delay_s,
                "recent_user_quiet_s": settings.heartbeat_recent_user_quiet_s,
            },
        },
        "options": {
            "providers": ["openai", "alibaba", "gemini", "openrouter", "local"],
            "stt_providers": ["openai", "elevenlabs", "local"],
            "tts_providers": ["openai", "elevenlabs", "local"],
            "autonomy_levels": ["off", "quiet", "normal", "bold"],
            "daily_loop_modes": ["manual", "quiet", "active"],
            "web_search_providers": ["disabled", "tavily"],
            "web_search_depths": ["ultra-fast", "fast", "basic", "advanced"],
            "wake_engines": ["auto", "nanowakeword", "local_wake", "stt"],
            "models": _MODEL_SUGGESTIONS,
            "stt_models": {
                "openai": [
                    "gpt-transcribe",
                    "gpt-4o-transcribe",
                    "gpt-4o-mini-transcribe",
                ],
                "elevenlabs": [
                    "scribe_v2",
                ],
                "local": [
                    "tiny",
                    "base",
                    "small",
                    "medium",
                    "large-v3-turbo",
                ],
            },
            "tts_models": {
                "openai": [
                    "tts-1",
                    "tts-1-hd",
                ],
                "elevenlabs": [
                    "eleven_v4",
                    "eleven_multilingual_v2",
                    "eleven_flash_v2_5",
                    "eleven_turbo_v2_5",
                ],
                "local": [
                    "hexgrad/Kokoro-82M",
                    "Qwen/Qwen3-TTS-12Hz-0.6B-CustomVoice",
                    "Qwen/Qwen3-TTS-12Hz-1.7B-CustomVoice",
                ],
            },
            "tts_voices": {
                "openai": [
                    "alloy",
                    "ash",
                    "ballad",
                    "coral",
                    "echo",
                    "sage",
                    "shimmer",
                    "verse",
                ],
                "local": [
                    "af_heart",
                    "af_bella",
                    "am_michael",
                    "bf_emma",
                    "bm_george",
                    "aiden",
                    "dylan",
                    "eric",
                    "ono_anna",
                    "ryan",
                    "serena",
                    "sohee",
                    "uncle_fu",
                    "vivian",
                ],
            },
            "elevenlabs_models": [
                "eleven_v4",
                "eleven_multilingual_v2",
                "eleven_flash_v2_5",
                "eleven_turbo_v2_5",
            ],
        },
    }
