ace-builder/Robbi/(commit log)

2026-04-09 Update README.md
    included BOM
2026-04-09 added wiring diagram
2026-11-03 Document current Robbi hardware limitations
2026-11-04 Align build guide with untested October enclosure design
    Correct mechanical order, fixed head, button, battery access and fastener specifications. Add matching unchanged STL exports and unsliced reference projects; distinguish CAD checks from physical validation and earlier build footage.
2026-11-05 Add verified Robbi PCB schematic
    Publish the EasyEDA source, PDF and netlist matched against the production BOM, placement and Gerber copper. Document legacy test-point references.
2026-11-05 Replace camera parts-list link
    Link the recommended 160-degree camera option and note the sensor, connector and fit checks.
2026-11-06 Fix custom PCB ordering reference
    Link the original PCB manufacturer quote and provide an AliExpress service search, keeping the BOM and guide in sync.
2026-11-06 Use JLCPCB for PCB manufacturing
